BananaGithubserfer/velopath/app/velopath3_project/documents/velopath_materials/brochure/assets/velopath-device-photo.png

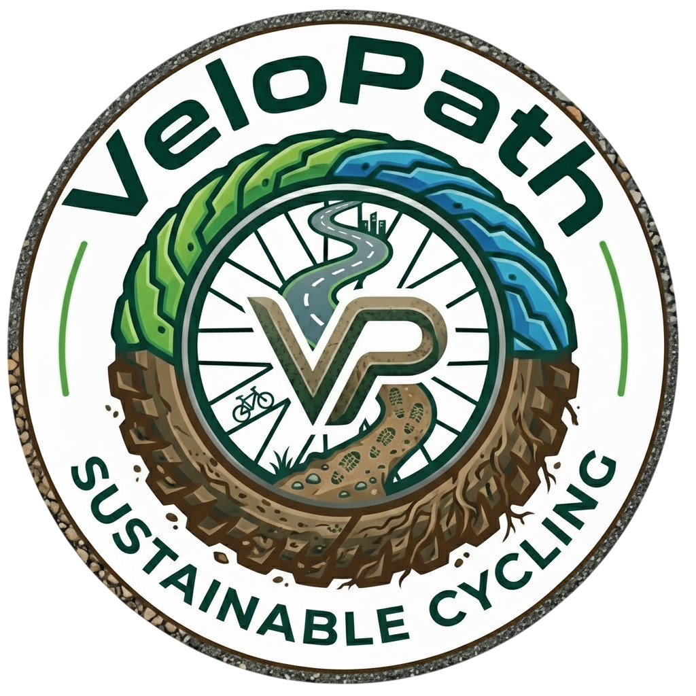
app/velopath3_project/documents/velopath_materials/brochure/assets/velopath-device-photo.png
