BananaGithubserfer/velopath/app/velopath3_project/artifacts/test-report-2026-04-02/02-dashboard-dark.png

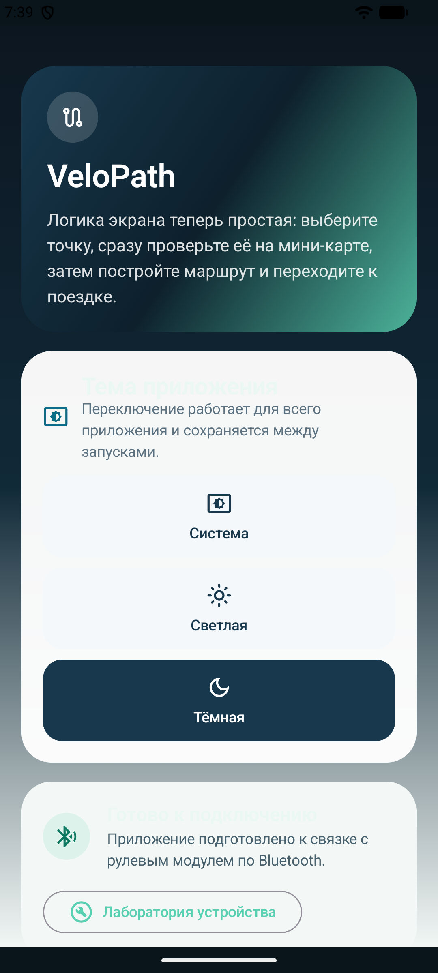
app/velopath3_project/artifacts/test-report-2026-04-02/02-dashboard-dark.png
