BananaGithubserfer/velopath/_migration/flash_import_report_2026-04-12.md

# Flash import report

Date: 2026-04-12
Source drive: D:\\
Destination: C:\\Users\\vladimir.DESKTOP-L4RFPI0\\Documents\\velopath\\documentation\\from_flash

Total files copied: 97
Total folders created: 5

## By extension
- .bak: 23
- .png: 19
- .m3d: 18
- .pdf: 8
- .docx: 5
- .stl: 5
- .a3d: 4
- .cdw: 3
- .kdw: 2
- .3mf_dir: 2
- .dxf: 2
- .3mf: 2
- .xcf: 1
- .deck: 1
- .frw: 1
- .gcode: 1

## Top-level copied groups
- gearbox
- velopath_0
- velopath_docs
- box_net_with_full_bw_logo_on_lid_FINAL.dxf
- VELOPATH (1).pdf
- VELOPATH.deck
- VELOPATH.pdf
- Тех.карта_шаблон.png
- Тех_карта_не_знаю_чего.png
