BananaGithubserfer/velopath/documentation/orders/rezonit_2026-08-21_from_scratch/drc_report.txt

** Drc report for velopath_rezonit_2026_08_21.kicad_pcb **
** Created on 2026-08-21T18:04:39 **
** Report includes: Errors, Warnings **

** Found 199 DRC violations **
[silk_over_copper]: Silkscreen clipped by solder mask
    Local override; warning
    @(29.0725 mm, 45.0300 mm): Сегмент от Q3 на F.Silkscreen
    @(29.4475 mm, 45.8000 mm): Конт. пл. 3 [GND] от Q3 на F.Cu
[silk_over_copper]: Silkscreen clipped by solder mask
    Local override; warning
    @(29.8225 mm, 45.0300 mm): Сегмент от Q3 на F.Silkscreen
    @(29.4475 mm, 45.8000 mm): Конт. пл. 3 [GND] от Q3 на F.Cu
[silk_over_copper]: Silkscreen clipped by solder mask
    Local override; warning
    @(29.8225 mm, 47.7300 mm): Сегмент от Q3 на F.Silkscreen
    @(29.4475 mm, 45.8000 mm): Конт. пл. 3 [GND] от Q3 на F.Cu
[silk_over_copper]: Silkscreen clipped by solder mask
    Local override; warning
    @(33.6325 mm, 45.0300 mm): Сегмент от Q3 на F.Silkscreen
    @(34.0075 mm, 45.8000 mm): Конт. пл. 1 [Net-(Q3-G)] от Q3 на F.Cu
[silk_over_copper]: Silkscreen clipped by solder mask
    Local override; warning
    @(34.3825 mm, 45.0300 mm): Сегмент от Q3 на F.Silkscreen
    @(34.0075 mm, 45.8000 mm): Конт. пл. 1 [Net-(Q3-G)] от Q3 на F.Cu
[silk_over_copper]: Silkscreen clipped by solder mask
    Local override; warning
    @(34.3825 mm, 48.1350 mm): Сегмент от Q3 на F.Silkscreen
    @(34.0075 mm, 45.8000 mm): Конт. пл. 1 [Net-(Q3-G)] от Q3 на F.Cu
[silk_over_copper]: Silkscreen clipped by solder mask
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
    Local override; warning
    @(27.3000 mm, 51.1000 mm): Сегмент от C7 на B.Silkscreen
    @(28.3675 mm, 50.8500 mm): Конт. пл. 1 [+3.3V] от C7 на B.Cu
[silk_over_copper]: Silkscreen clipped by solder mask
    Local override; warning
    @(27.3000 mm, 51.1000 mm): Сегмент от C7 на B.Silkscreen
    @(27.2325 mm, 50.8500 mm): Конт. пл. 2 [GND] от C7 на B.Cu
[silk_over_copper]: Silkscreen clipped by solder mask
    Local override; warning
    @(28.3000 mm, 50.6000 mm): Сегмент от C7 на B.Silkscreen
    @(28.3675 mm, 50.8500 mm): Конт. пл. 1 [+3.3V] от C7 на B.Cu
[silk_over_copper]: Silkscreen clipped by solder mask
    Local override; warning
    @(28.3000 mm, 50.6000 mm): Сегмент от C7 на B.Silkscreen
    @(27.2325 mm, 50.8500 mm): Конт. пл. 2 [GND] от C7 на B.Cu
[silk_over_copper]: Silkscreen clipped by solder mask
    Local override; warning
    @(28.3000 mm, 51.1000 mm): Сегмент от C7 на B.Silkscreen
    @(28.3675 mm, 50.8500 mm): Конт. пл. 1 [+3.3V] от C7 на B.Cu
[silk_over_copper]: Silkscreen clipped by solder mask
    Local override; warning
    @(29.6750 mm, 50.4200 mm): Сегмент от R1 на B.Silkscreen
    @(30.7975 mm, 50.1500 mm): Конт. пл. 1 [Net-(D1-K-)] от R1 на B.Cu
[silk_over_copper]: Silkscreen clipped by solder mask
    Local override; warning
    @(29.6750 mm, 50.4200 mm): Сегмент от R1 на B.Silkscreen
    @(29.6025 mm, 50.1500 mm): Конт. пл. 2 [GND] от R1 на B.Cu

** Found 0 unconnected pads **

** Found 0 Footprint errors **

** Ignored checks **
    - Footprint has no courtyard defined
    - Track endpoint not centered on via
    - Tuning profile track geometries
    - Footprint doesn't match symbol's footprint filters
    - PTH inside courtyard
    - NPTH inside courtyard
    - Footprint component type doesn't match footprint pads
    - Footprint doesn't match copy in library

** End of Report **
