BananaGithubserfer/velopath/INDEX.md

# VeloPath - project index

Last updated: 2026-08-10

Project root:
`C:\Users\vladimir.DESKTOP-L4RFPI0\Documents\velopath`

## 1) Main folders

- `app` - Android application, Gradle project, APK outputs.
- `firmware` - MCU firmware workspaces.
- `documentation` - reports, technical docs, mechanical docs, migration notes.
- `pcb` - KiCad schematic/PCB and production files.
- `advertising` - booklets, presentations, visual assets.
- `_migration` - migration/import logs.

## 2) Where to find things quickly

Android app:
- `C:\Users\vladimir.DESKTOP-L4RFPI0\Documents\velopath\app\velopath3_project`
- Release APK copies:
  `C:\Users\vladimir.DESKTOP-L4RFPI0\Documents\velopath\app\releases`

STM32 firmware:
- Primary tree:
  `C:\Users\vladimir.DESKTOP-L4RFPI0\Documents\velopath\firmware\firmware`
- Legacy/backup workspace:
  `C:\Users\vladimir.DESKTOP-L4RFPI0\Documents\velopath\firmware\stm32_legacy_workspace`

ESP (all ESP code + artifacts + temp build data in one place):
- `C:\Users\vladimir.DESKTOP-L4RFPI0\Documents\velopath\firmware\esp`
- Folder policy:
  `C:\Users\vladimir.DESKTOP-L4RFPI0\Documents\velopath\firmware\esp\README.md`

Reports and explanatory documents:
- `C:\Users\vladimir.DESKTOP-L4RFPI0\Documents\velopath\documentation\reports\project_docs`
- Explanatory note (Shanenkov):
  `C:\Users\vladimir.DESKTOP-L4RFPI0\Documents\velopath\documentation\reports\explanatory_note`
- Reviews:
  `C:\Users\vladimir.DESKTOP-L4RFPI0\Documents\velopath\documentation\reports\reviews`
- Hardware audit (schematic + PCB, 2026-08-10):
  `C:\Users\vladimir.DESKTOP-L4RFPI0\Documents\velopath\documentation\reports\hardware_audit_2026-08-10`

Engineering/process docs:
- `C:\Users\vladimir.DESKTOP-L4RFPI0\Documents\velopath\documentation\engineering\process_docs`
- Engineering visuals:
  `C:\Users\vladimir.DESKTOP-L4RFPI0\Documents\velopath\documentation\engineering\visuals`

Mechanical CAD docs:
- Main assembly models:
  `C:\Users\vladimir.DESKTOP-L4RFPI0\Documents\velopath\documentation\mechanical_cad\main_assembly_models`
- Gearbox:
  `C:\Users\vladimir.DESKTOP-L4RFPI0\Documents\velopath\documentation\mechanical_cad\gearbox`

PCB:
- Main PCB folder:
  `C:\Users\vladimir.DESKTOP-L4RFPI0\Documents\velopath\pcb`

Advertising:
- Presentations:
  `C:\Users\vladimir.DESKTOP-L4RFPI0\Documents\velopath\advertising\presentations`
- Booklets:
  `C:\Users\vladimir.DESKTOP-L4RFPI0\Documents\velopath\advertising\brochures`
- Assets:
  `C:\Users\vladimir.DESKTOP-L4RFPI0\Documents\velopath\advertising\assets`

## 3) Navigation docs

Project onboarding guide:
- `C:\Users\vladimir.DESKTOP-L4RFPI0\Documents\velopath\START_HERE.md`

Software stack (non-ESP):
- `C:\Users\vladimir.DESKTOP-L4RFPI0\Documents\velopath\documentation\software_stack_non_esp.md`

Materials origin map:
- `C:\Users\vladimir.DESKTOP-L4RFPI0\Documents\velopath\documentation\materials_origin_and_import_map.md`

Migration reports:
- `C:\Users\vladimir.DESKTOP-L4RFPI0\Documents\velopath\_migration\migration_report_2026-04-12.md`
- `C:\Users\vladimir.DESKTOP-L4RFPI0\Documents\velopath\_migration\flash_import_report_2026-04-12.md`
