BananaGithubserfer/velopath/START_HERE.md

# START HERE - quick onboarding

If you are new to this project, use this order:

1. Open project map:
   `C:\Users\vladimir.DESKTOP-L4RFPI0\Documents\velopath\INDEX.md`
2. Read software overview (non-ESP):
   `C:\Users\vladimir.DESKTOP-L4RFPI0\Documents\velopath\documentation\software_stack_non_esp.md`
3. Read materials/source map:
   `C:\Users\vladimir.DESKTOP-L4RFPI0\Documents\velopath\documentation\materials_origin_and_import_map.md`

## Fast path by task

Mobile app:
- `C:\Users\vladimir.DESKTOP-L4RFPI0\Documents\velopath\app\velopath3_project`

STM32 firmware:
- `C:\Users\vladimir.DESKTOP-L4RFPI0\Documents\velopath\firmware\firmware`

ESP work:
- `C:\Users\vladimir.DESKTOP-L4RFPI0\Documents\velopath\firmware\esp`

PCB/electronics:
- `C:\Users\vladimir.DESKTOP-L4RFPI0\Documents\velopath\pcb`

Reports and explanatory docs:
- `C:\Users\vladimir.DESKTOP-L4RFPI0\Documents\velopath\documentation\reports`

Engineering/process docs:
- `C:\Users\vladimir.DESKTOP-L4RFPI0\Documents\velopath\documentation\engineering`

Mechanical CAD docs:
- `C:\Users\vladimir.DESKTOP-L4RFPI0\Documents\velopath\documentation\mechanical_cad`
