BananaGithubserfer/velopath/documentation/reports/Криминалистические очки с ультрафиолетовой подсветкой_VeloPath_готово.docx

# VeloPath — система тактильной навигации для велосипеда

ВСОШ 2026-2027

Файл утверждён: 01.10.2026

Список олимпиад для которых предназначен проект: ВсОШ «Труд (технология)», направление ТТиТТ

____________________________________________________________________

ФИО Исполнителя №1: Штаненков Владимир Владимирович

Класс (Номер, буква): ______________

ФИО Классного руководителя исполнителя №1: ___________________________

ФИО Исполнителя №2: не предусмотрен

Класс (Номер, буква): ______________

ФИО Классного руководителя исполнителя №2:___________________________

ФИО Исполнителя №3: не предусмотрен

Класс (Номер, буква): ______________

ФИО Классного руководителя исполнителя №3:___________________________

ФИО Научного руководителя №1: ______________________________________

ФИО Научного руководителя №2: ______________________________________

ФИО Научного руководителя №3: ______________________________________

Подпись исполнителя №1: ____________________

Подпись исполнителя №2: ____________________

Подпись исполнителя №3: ____________________

Подпись научного руководителя №1: ____________________

Подпись научного руководителя №2: ____________________

Подпись научного руководителя №3: ____________________

Оглавление

1. Общая часть 6

1.1 Цель 6

1.2 Проблема, решаемая проектом 6

1.3 Целевая аудитория проекта 6

1.4 Преимущества проекта перед аналогами 7

1.5 Уровень готовности проекта по этапам олимпиады 8

1.5.1 Муниципальный этап 8

1.5.2 Региональный этап 8

1.5.3 Заключительный этап 8

2. Предмет разработки (тип устройства) 9

2.1 Комплектация готового изделия(-ий) 9

2.2 Список функций предмета разработки 9

2.3 Список задач до каждого этапа 10

2.3.1 Муниципальный этап 10

2.3.2 Региональный этап 10

2.3.3 Заключительный этап 10

2.4 Список основних электронных компоннентов 10

2.5 Список сложных для создания/закупки компонентов 11

2.6 Список собственных печатных плат/готовых электронных модулей 12

2.7 Перспективы в случае оставшегося времени на доработку 13

3. Зарядная станция (при наличии) 15

3.1 Список функций зарядной станции 15

3.2 Список задач до каждого этапа 15

3.2.1 Муниципальный этап 16

3.2.2 Региональный этап 16

3.2.3 Заключительный этап 16

3.3 Список основних электронных компоннентов 16

3.4 Список сложных для создания/закупки компонентов 17

3.5 Список собственных печатных плат/готовых электронных модулей 18

3.6 Перспективы в случае оставшегося времени на доработку 19

4. Программная часть проекта (при наличии) 20

4.1 Список программных функций предмета разработки 20

4.2 Список программных функций зарядной станции (при наличии) 20

4.3 Список функций приложения/сайта/бота (при наличии) 21

4.4 Список задач до каждого этапа 22

4.4.1 Муниципальный этап 22

4.4.2 Региональный этап 23

4.4.3 Заключительный этап 23

4.5 Перспективы в случае оставшегося времени на доработку 23

5. Дополнительные материалы 24

5.1 Название проекта 24

5.2 Патентное исследование 24

5.3 Опросы целевой аудитории 25

5.4 Логотип 26

5.5 Продвижение и ведение социальных сетей проекта 27

5.6 Буклеты/визитки 28

5.7 Упаковка 29

5.8 Презентация и сценарий защиты проекта 30

5.9 Апробация проекта 31

5.10 Дополнительные печатные и информационные материалы 32

1. Общая часть

## 1.1 Цель

Цель проекта — разработать и испытать комплекс VeloPath: мобильное приложение и встраиваемый в концы велосипедного руля модуль, который передаёт тактильные указания о направлении движения и позволяет пользоваться навигацией без постоянного взгляда на экран.

## 1.2 Проблема, решаемая проектом

Во время движения велосипедисту приходится отвлекаться от дороги, чтобы читать карту или указания на экране смартфона. Это снижает внимание к дорожной обстановке, особенно при ярком солнце, вибрации, дожде и движении по незнакомому маршруту. VeloPath передаёт предупреждение о повороте, сигнал самого поворота и завершение маршрута вибрацией левой и правой частей руля. Направление считывается руками, поэтому экран нужен только для построения маршрута и контроля приложения.

## 1.3 Целевая аудитория проекта

Основные пользователи — велосипедисты-любители, участники велоспорта и курьеры, которым требуется навигация во время движения. Дополнительная аудитория — пользователи, которым неудобно постоянно смотреть на экран из-за яркого освещения, погодных условий или требований безопасности. Устройство рассчитано на велосипеды с рулём, в торцы которого устанавливаются два модуля диаметром примерно 17–20 мм.

## 1.4 Преимущества проекта перед аналогами

Прямые аналоги — велокомпьютеры и навигаторы с экраном; косвенные — смартфон на держателе и голосовые подсказки. VeloPath сообщает направление тактильно и не закрывает обзор картой или телефоном. Два симметричных модуля дают однозначное различение левого и правого поворота, а компас позволяет уточнять отклонение от курса. Конструкция размещается внутри руля, защищает электронику и не требует отдельного экрана на руле. Прототип объединяет собственную плату, прошивку и мобильное приложение в одной системе.

## 1.5 Уровень готовности проекта по этапам олимпиады

Проект готовится поэтапно: на муниципальном этапе демонстрируется работающий макет и базовый сценарий навигации; на региональном — собранный прототип с корпусом, платой, прошивкой и приложением; на заключительном — полностью собранное изделие, комплект документации, результаты испытаний на нескольких типах велосипедов и демонстрация маршрута.

### 1.5.1 Муниципальный этап

Готовы постановка задачи и архитектура системы, CAD-модель корпуса, схема основных узлов, базовая версия мобильного приложения и прошивки, демонстрация передачи команд по Bluetooth и работы вибромоторов.

### 1.5.2 Региональный этап

Собраны печатная плата и корпус, установлены аккумуляторы, вибромоторы, крепления и зарядный разъём; реализованы построение маршрута, получение GPS, расчёт направления, передача команд по Bluetooth и сигналы поворота; выполнена первичная проверка на велосипеде.

### 1.5.3 Заключительный этап

Представляется рабочий прототип VeloPath в корпусе с двумя вибрационными модулями, управляющей платой на STM32F103RGT6, аккумуляторами LiFePO4, мобильным приложением Android, руководством пользователя, схемами, чертежами, спецификацией и протоколом апробации на разных велосипедах.

## 2.1 Комплектация готового изделия(-ий)

1) левый и правый модули корпуса; 2) управляющая плата; 3) два вибромотора с регуляторами; 4) два аккумулятора LiFePO4 14500; 5) крепления и крепёж; 6) соединительная проводка и разъём XT30; 7) установленная прошивка; 8) мобильное приложение VeloPath для Android; 9) инструкция по установке, зарядке и первому запуску; 10) транспортировочная упаковка.

## 2.2 Список функций предмета разработки

• передача тактильного сигнала левого и правого направления; • предупреждение о повороте примерно за 10 секунд; • сигнал выполнения поворота с интенсивностью, зависящей от отклонения курса; • сигнал завершения маршрута одновременной вибрацией; • получение команд от приложения по Bluetooth UART; • определение ориентации по магнитометру LIS3MDL; • автономная работа от двух LiFePO4 аккумуляторов; • зарядка через установленную схему TP5000 и разъём XT30; • размещение в торцах велосипедного руля с механической фиксацией.

## 2.3 Список задач до каждого этапа

Задачи включают разработку конструкции, электроники, прошивки, мобильного приложения, изготовление деталей, сборку и испытания. Состав по этапам указан ниже.

### 2.3.1 Муниципальный этап

Уточнить требования и сценарии сигналов; завершить эскизную компоновку; подготовить схему и перечень компонентов; реализовать базовую Bluetooth-связь и управление вибрацией; подготовить демонстрационный макет.

### 2.3.2 Региональный этап

Изготовить и проверить печатную плату; изготовить корпус и крепления; установить аккумуляторы и моторы; реализовать построение маршрута, GPS и расчёт направления; выполнить первичную апробацию и исправить выявленные ошибки.

### 2.3.3 Заключительный этап

Завершить сборку и маркировку изделия; проверить зарядку, связь и все сигналы; провести испытания в городе, на просёлочной дороге и в лесу; оформить чертежи, спецификацию, инструкцию, презентацию и подтверждающие материалы.

## 2.4 Список основних электронных компоннентов

STM32F103RGT6 — микроконтроллер прошивки и управления; WH-BLE106 — Bluetooth UART-связь с телефоном; LIS3MDL — магнитометр для определения курса; TP5000 и BMS — зарядка и защита LiFePO4; два LiFePO4 14500 — автономное питание; два бесколлекторных мотора Mini 1103 и два регулятора SPEDIX ES20 Lite 20A — создание тактильной вибрации; LD39050PU33 и пассивные компоненты — стабилизация и согласование питания.

## 2.5 Список сложных для создания/закупки компонентов

Печатная плата требует заказа на производстве из-за малых посадочных мест магнитометра и плотной трассировки. Эксцентрики вибромоторов изготавливаются фрезерованием алюминия и запрессовкой на вал. Корпус, крепления и держатели моторов печатаются на 3D-принтере по разработанным моделям. Эти элементы необходимы для размещения узлов в ограниченном диаметре руля и обеспечения надёжной фиксации.

## 2.6 Список собственных печатных плат/готовых электронных модулей

Собственная управляющая печатная плата объединяет STM32F103RGT6, Bluetooth, магнитометр, питание, зарядку и выводы моторов. Готовые модули: WH-BLE106, регуляторы SPEDIX ES20 Lite и элементы защиты аккумуляторов. Плата спроектирована в KiCad и изготовлена на производстве Резонит.

## 2.7 Список необходимого технологического оборудования

ПК с KiCad, Android Studio и STM32CubeIDE; паяльная станция; мультиметр; лабораторный блок питания; сварка аккумуляторов; 3D-принтер Creality Ender 3 V3 SE; фрезерный и сверлильный станки для эксцентриков; ручной слесарный инструмент; оборудование для проверки Bluetooth и навигации.

## 2.8 Перспективы в случае оставшегося времени на доработку

Уменьшить габариты платы и корпуса; повысить влагозащиту; добавить диагностику заряда и состояния связи; разработать сменные крепления для рулей разных диаметров; улучшить алгоритм фильтрации компаса; подготовить серийную технологию изготовления и расширить приложение статистикой поездки.

3. Зарядная станция (при наличии)

Отдельная зарядная станция проектом не предусмотрена. Зарядка аккумуляторов выполнена внутри правого модуля через разъём XT30 и контроллер TP5000.

## 3.1 Список функций зарядной станции

Не применяется: отдельной станции нет. Изделие принимает заряд через встроенный разъём и контроллер.

## 3.2 Список задач до каждого этапа

Не применяется: отдельная зарядная станция не разрабатывается.

### 3.2.1 Муниципальный этап

Не применяется.

### 3.2.2 Региональный этап

Не применяется.

### 3.2.3 Заключительный этап

Не применяется.

## 3.3 Список основних электронных компоннентов

Не применяется: зарядный узел находится на управляющей плате изделия и использует TP5000, BMS и разъём XT30.

## 3.4 Список сложных для создания/закупки компонентов

Не применяется.

## 3.5 Список собственных печатных плат/готовых электронных модулей

Зарядная часть выполнена на собственной управляющей плате; отдельная плата станции отсутствует.

## 3.6 Список необходимого технологического оборудования

Оборудование отдельной станции не требуется; для проверки зарядки используются мультиметр и лабораторный блок питания.

## 3.7 Перспективы в случае оставшегося времени на доработку

Разработать внешний зарядный док с контактами pogo-pin, если испытания покажут необходимость ускоренной установки изделия на зарядку.

## 4.1 Список программных функций предмета разработки

Прошивка контроллера и логика устройства обеспечивают приём команд по UART, управление левым и правым каналами вибрации, чтение магнитометра, формирование сигналов предупреждения, поворота и завершения маршрута, контроль режимов питания и диагностику связи.

## 4.2 Список программных функций зарядной станции (при наличии)

Не применяется: отдельной зарядной станции нет.

## 4.3 Список функций приложения/сайта/бота (при наличии)

Android-приложение создаёт маршрут, отображает карту, получает координаты GPS, рассчитывает направление и ключевые события, передаёт команды по Bluetooth, показывает состояние подключения и предоставляет настройки пользователя. Используются Kotlin, Jetpack Compose, Android Navigation Compose, Yandex MapKit и Google Play Services Location.

## 4.4 Список задач до каждого этапа

Разработка прошивки и Android-приложения ведётся совместно с изготовлением аппаратной части.

### 4.4.1 Муниципальный этап

Собрать прототип обмена данными; реализовать команды вибрации; подготовить экран построения маршрута и подключение Bluetooth; проверить базовый сценарий на стенде.

### 4.4.2 Региональный этап

Реализовать GPS, расчёт направления, события маршрута и работу с магнитометром; связать приложение с реальной платой; добавить диагностику и обработку ошибок связи.

### 4.4.3 Заключительный этап

Стабилизировать прошивку и приложение; провести полевые испытания; подготовить APK, инструкцию, демонстрационный сценарий и резервный режим показа функций без внешней сети.

## 4.5 Перспективы в случае оставшегося времени на доработку

Добавить журнал поездки, настройку интенсивности сигналов, обновление прошивки через приложение, профили для разных типов велосипедов и более устойчивое к помехам определение курса.

## 5.1 Название проекта

VeloPath («ВелоПуть») — название отражает назначение системы: построение велосипедного маршрута и передача пути пользователю через устройство в руле. Название используется на корпусе, в приложении, документации и презентации.

## 5.2 Патентное исследование

Провести поиск по открытым базам Роспатента и международным базам по ключевым словам: велосипедная навигация, тактильная навигация, вибрационные указатели поворота, устройство в руле. Отдельно сравнить решения с экраном, голосовыми подсказками и вибрационными сигналами. Результаты оформить таблицей аналогов и приложить к защите; при обнаружении близкого патента скорректировать формулировки конструкции.

## 5.3 Опросы целевой аудитории

Провести опрос не менее 10 велосипедистов и курьеров. Проверить понятность левого и правого сигналов, полезность предупреждения за 10 секунд, удобство расположения в руле и готовность использовать приложение. Зафиксировать ответы анкетами, свести результаты в таблицу и использовать их для настройки сигналов.

## 5.4 Логотип

Использовать существующий логотип VeloPath в едином варианте: название VeloPath и графический мотив маршрута. Размещать логотип на корпусе, плате, упаковке, буклете, презентации и экране приложения.

## 5.5 Продвижение и ведение социальных сетей проекта

Вести дневник разработки и демонстрации прототипа в VK и Telegram с дублированием ключевых публикаций в VK. Публиковать фотографии CAD-моделей, платы, сборки, испытаний и короткие ролики с пояснением сигналов. Подготовить контент-план по этапам изготовления и апробации.

## 5.6 Буклеты/визитки

Подготовить двусторонний буклет формата А5: проблема, схема работы, комплект, характеристики, фотографии и QR-код на материалы проекта. Для общения с экспертами дополнительно использовать визитку с названием VeloPath и контактами автора.

## 5.7 Упаковка

Использовать компактную картонную коробку с ложементом из вспененного материала. Внутри отдельно зафиксировать левый и правый модули, кабель, крепёж и инструкцию. На крышке разместить логотип VeloPath, на вкладыше — схему установки и предупреждения по зарядке.

## 5.8 Презентация и сценарий защиты проекта

Защита включает презентацию, демонстрационный прототип, схему системы, фотографию платы и корпуса, сравнительную таблицу аналогов и короткую демонстрацию маршрута. Порядок: проблема безопасности, идея тактильной навигации, конструкция и электроника, приложение, испытания, результаты и перспективы.

## 5.9 Апробация проекта

Испытать устройство на спортивном кросс-кантри, фитнес-кросс-кантри, гравийном и шоссейном велосипедах. Проверить фиксацию, различимость сигналов, работу Bluetooth, точность указаний и автономность. Участники проходят знакомый и незнакомый маршрут; результаты фиксируются видео, фотографиями, анкетами и протоколом испытаний.

## 5.10 Дополнительные печатные и информационные материалы

Подготовить руководство по установке и первому запуску, памятку по сигналам, правила зарядки LiFePO4, технический паспорт с составом изделия, спецификацию, электрическую схему, чертежи корпуса и протокол апробации. К заключительному этапу материалы должны быть доступны в печатном и электронном виде.
