BananaGithubserfer/velopath/documentation/reports/reviews/рецензия_от_ядра.pdf

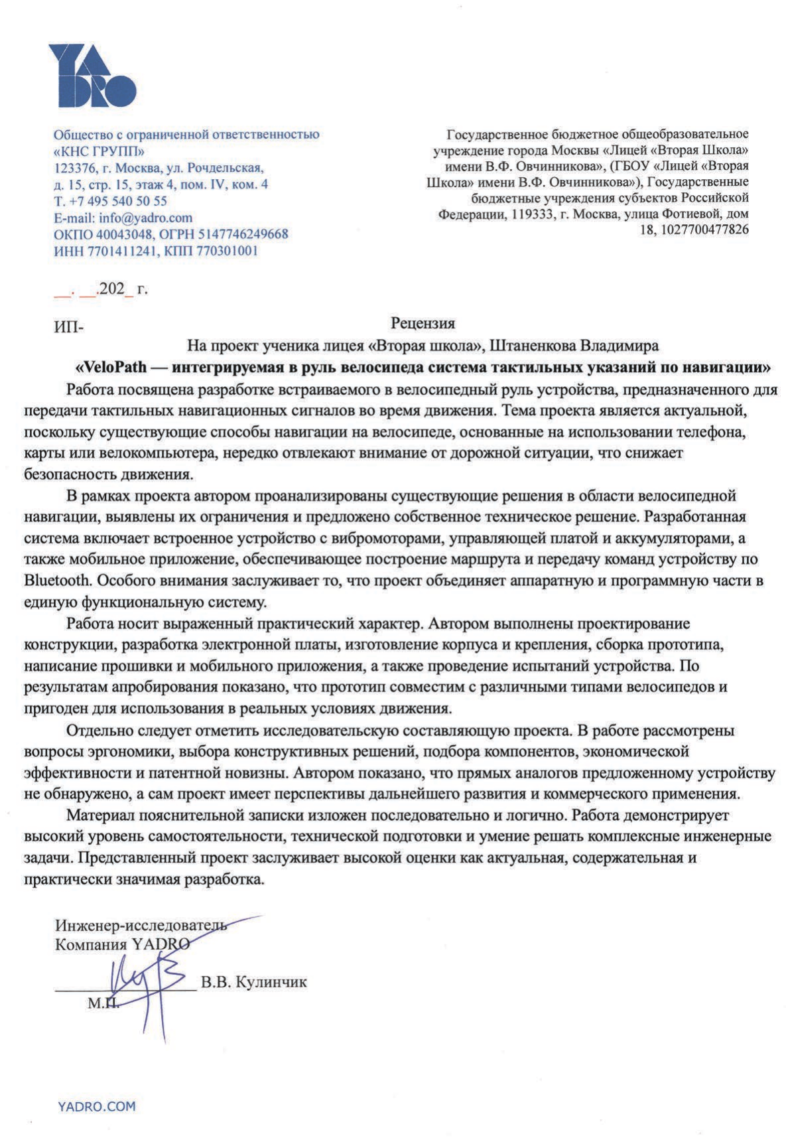
[picture p44: page 1]
