BananaGithubserfer/velopath/documentation/engineering/process_docs/Тех.карта_корпус.pdf

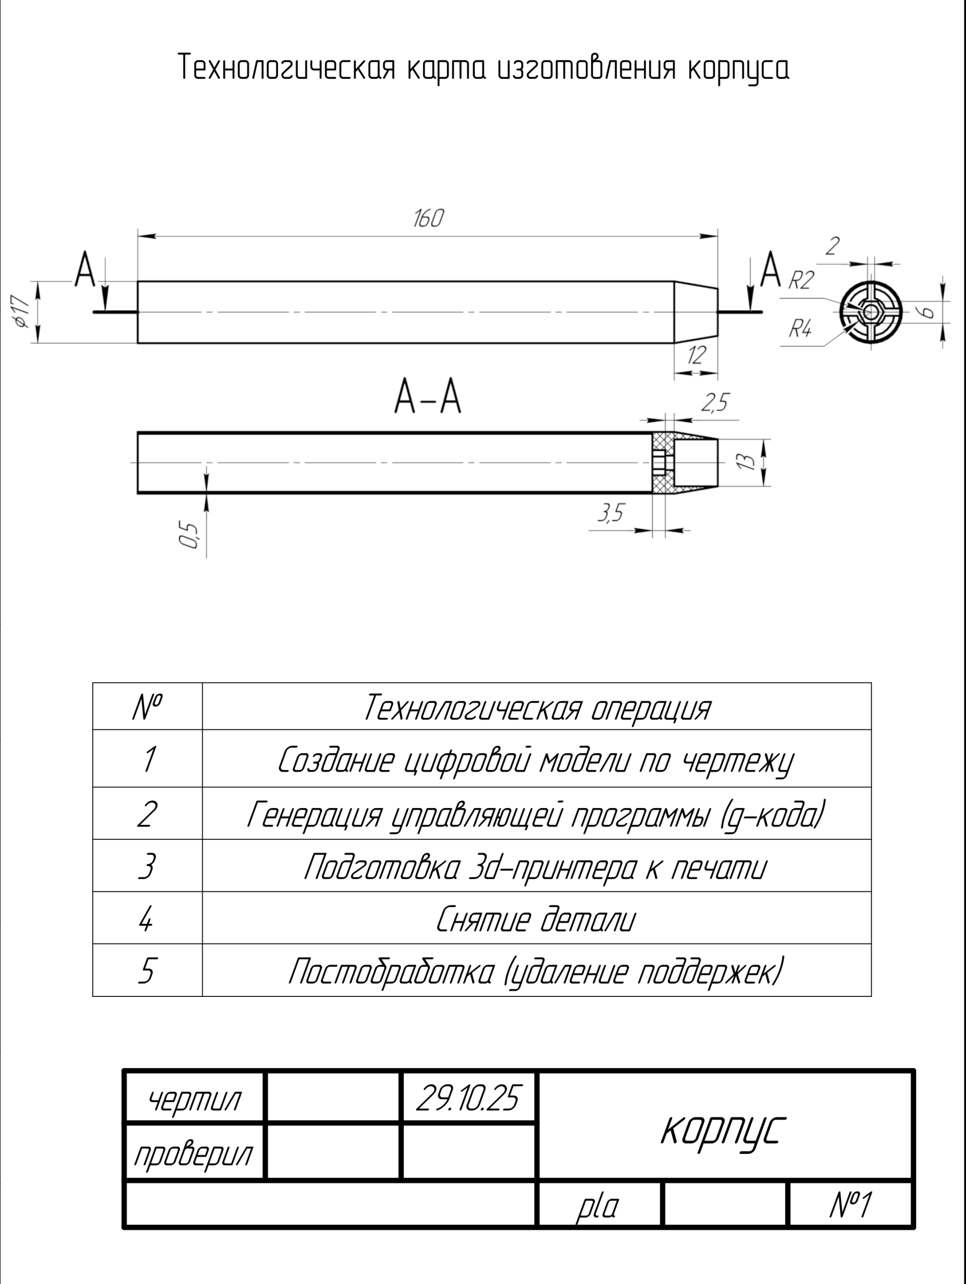
[picture p45: page 1]
