BananaGithubserfer/velopath/advertising/assets/lid_black_preview.png

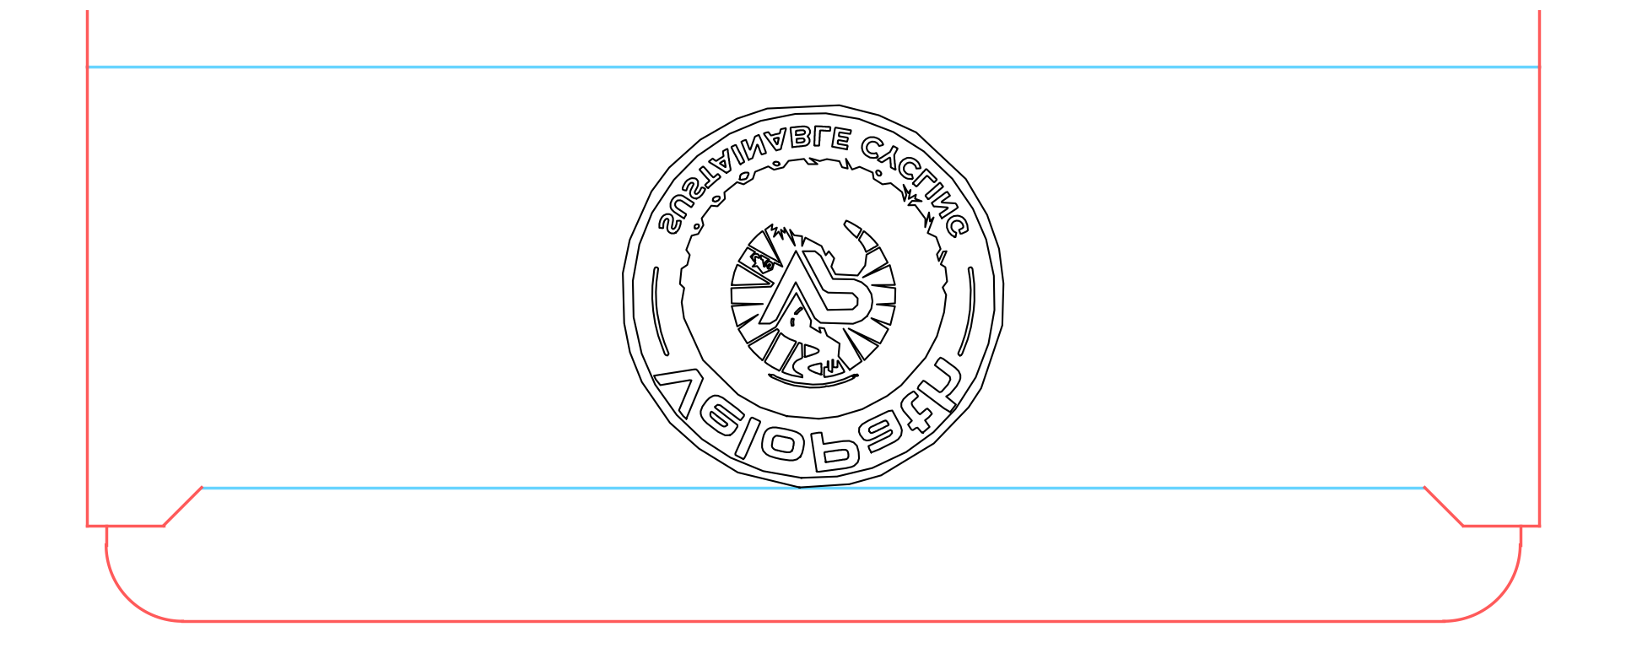
advertising/assets/lid_black_preview.png
