BananaGithubserfer/velopath/app/velopath3_project/documents/velopath_materials/app_reports/route-current.png

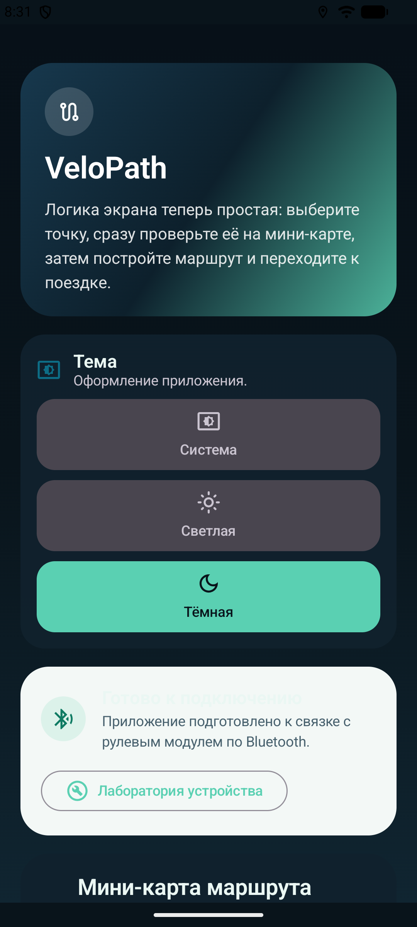
app/velopath3_project/documents/velopath_materials/app_reports/route-current.png
