BananaGithubserfer/velopath/documentation/_artifacts/duplicates/Тех.карта_корпус__20260412_233927406__20260412_234039031.png

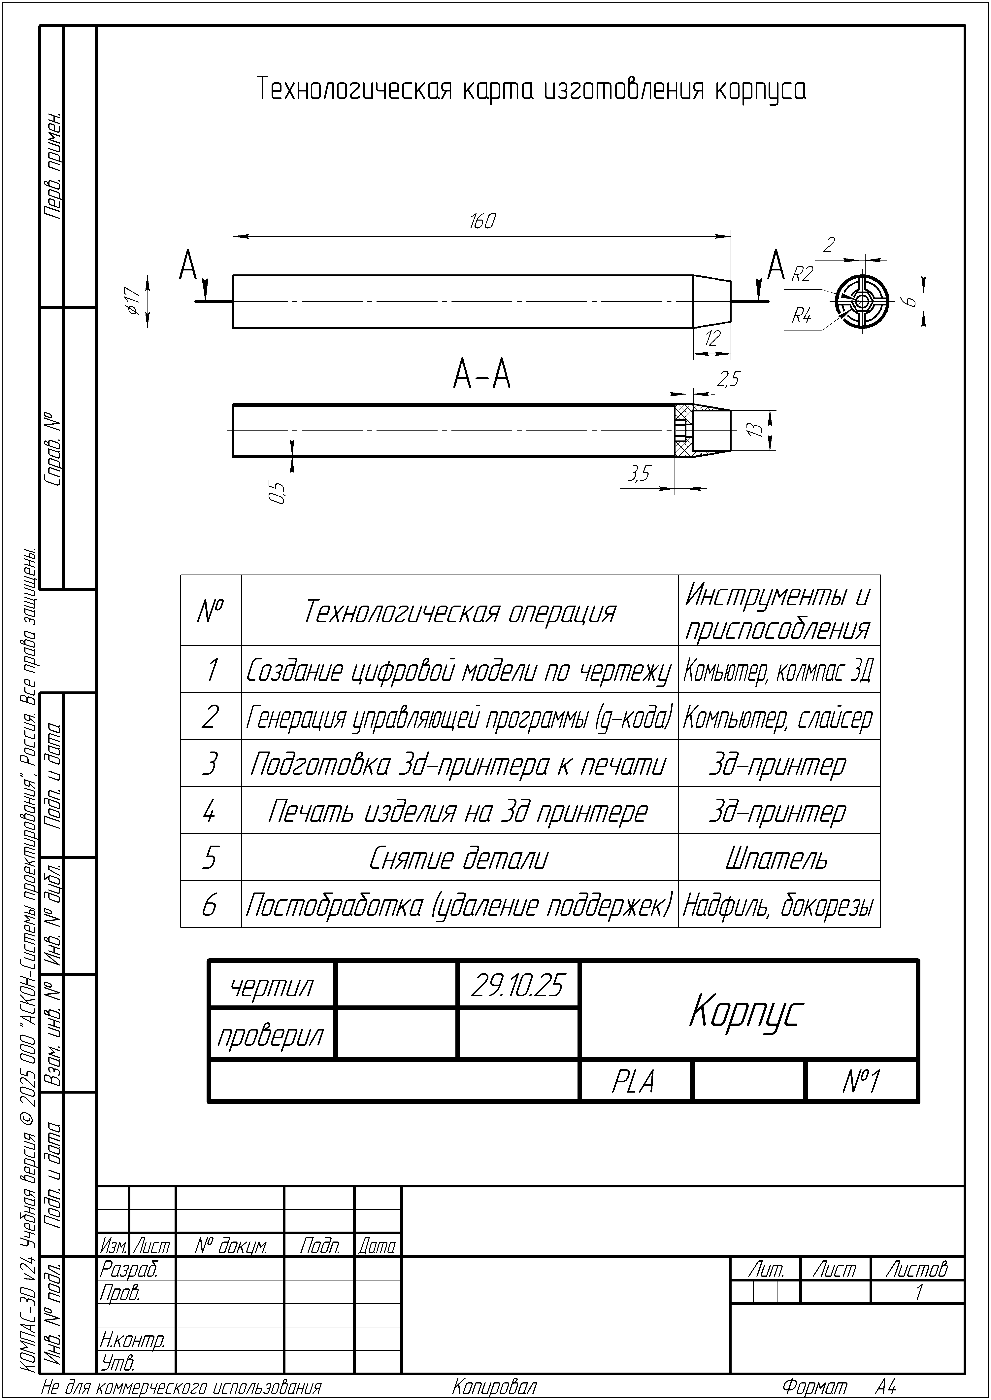
documentation/_artifacts/duplicates/Тех.карта_корпус__20260412_233927406__20260412_234039031.png
