BananaGithubserfer/velopath/documentation/engineering/visuals/1 - корпус.png

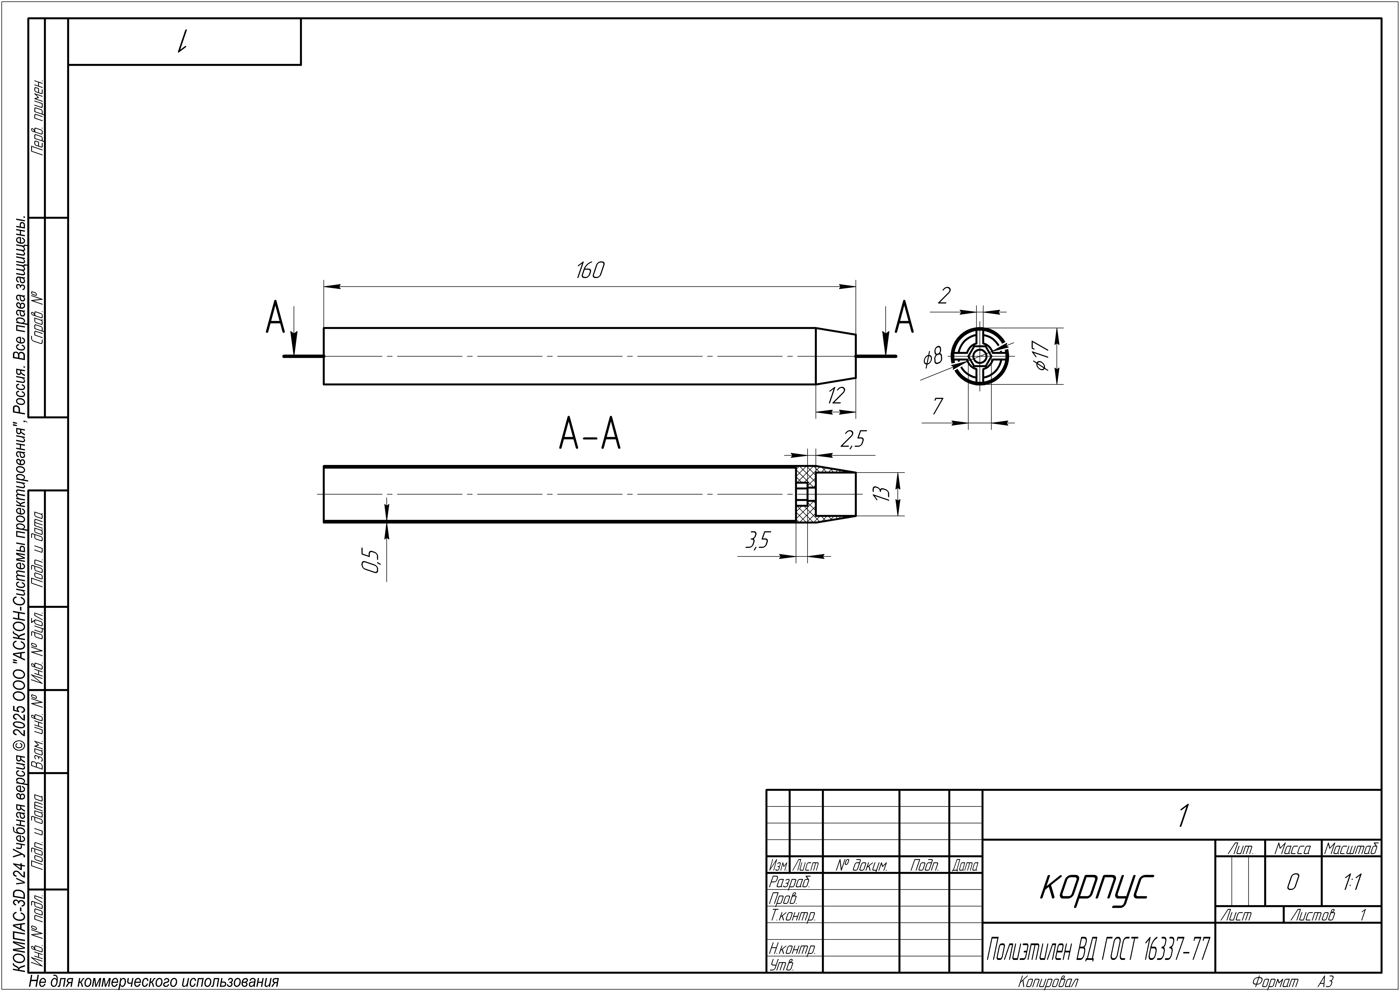
documentation/engineering/visuals/1 - корпус.png
