BananaGithubserfer/velopath/documentation/engineering/visuals/Тех.карта_корпус.png

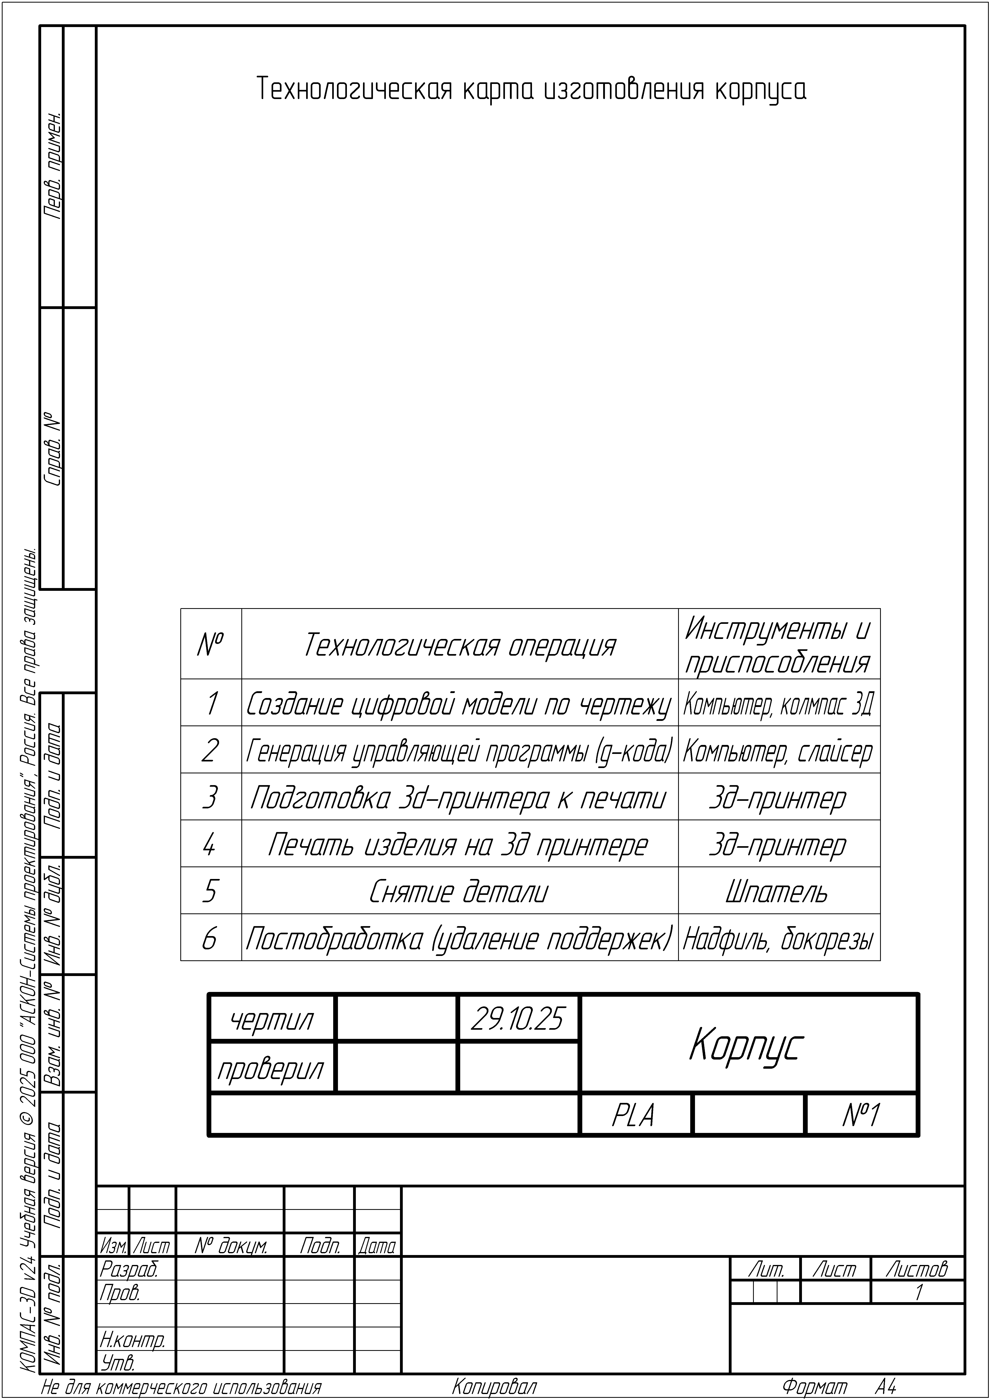
documentation/engineering/visuals/Тех.карта_корпус.png
