BananaGithubserfer/velopath/documentation/engineering/visuals/Тех.карта_шаблон.png

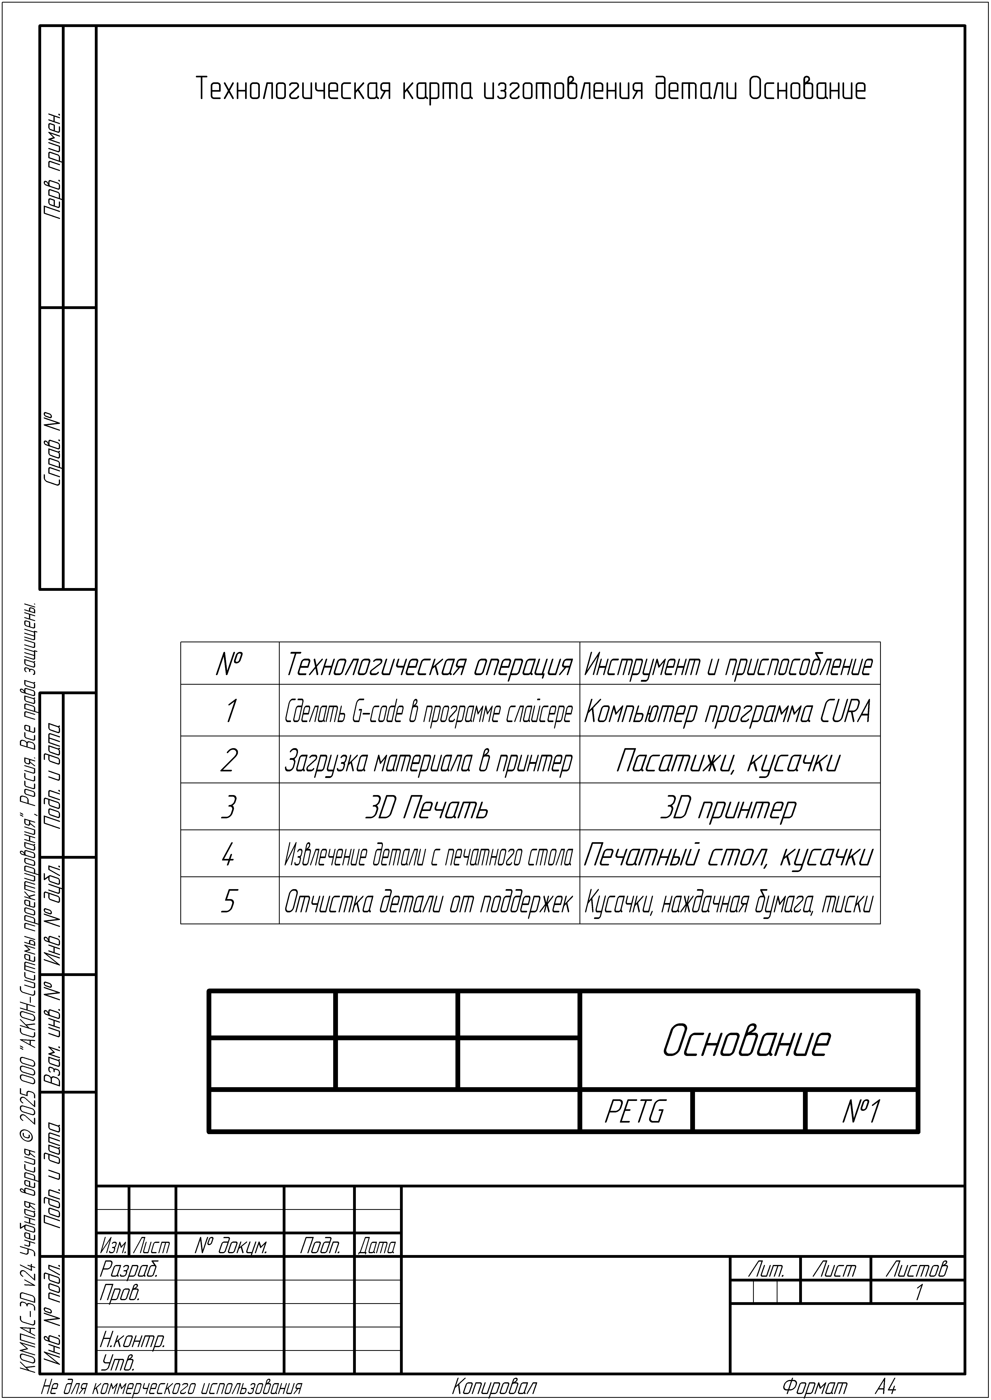
documentation/engineering/visuals/Тех.карта_шаблон.png
