BananaGithubserfer/velopath/documentation/mechanical_cad/.зарядка.3mf/зарядка_plate_1.png

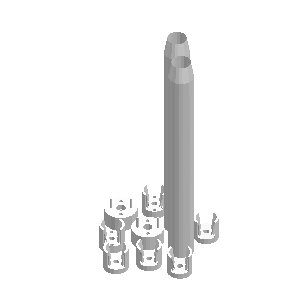
documentation/mechanical_cad/.зарядка.3mf/зарядка_plate_1.png
