BananaGithubserfer/velopath/documentation/mechanical_cad/.сборка.3mf/сборка_thumbnail.png

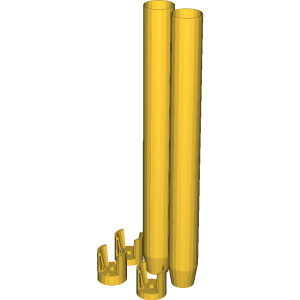
documentation/mechanical_cad/.сборка.3mf/сборка_thumbnail.png
