BananaGithubserfer/velopath/app/velopath3_project/documents/velopath_materials/README.md

# VeloPath Materials

This folder contains the curated non-code materials for VeloPath.

Contents:

- `brochure/`
  - final Figma-importable brochure SVGs
  - brochure assets
  - real app screenshots used for brochure/layout work
- `app_reports/`
  - selected app capture files
  - latest visual report artifacts
- `firmware_docs/`
  - handlebar firmware overview
  - WH-BLE106 notes and report

Removed as obsolete from the project root and brochure workspace:

- temporary emulator screenshots
- intermediate UI XML dumps
- old non-Figma brochure SVGs
- duplicate artifact screenshots from the project root
