BananaGithubserfer/velopath/documentation/materials_origin_and_import_map.md

# Materials origin and placement map

Last updated: 2026-04-12

This file explains where materials came from and where they are now located.

## 1) Source locations used during import

- Local machine:
  `C:\Users\vladimir.DESKTOP-L4RFPI0\Documents`
- USB flash drive:
  `D:\`
  (import was copy-only; source files on flash were not deleted)
- Existing project workspace:
  `C:\Users\vladimir.DESKTOP-L4RFPI0\AndroidStudioProjects\velopath3`

## 2) Final mapping (human-readable structure)

Application:
- Source project:
  `C:\Users\vladimir.DESKTOP-L4RFPI0\Documents\velopath\app\velopath3_project`
- APK copies:
  `C:\Users\vladimir.DESKTOP-L4RFPI0\Documents\velopath\app\releases`

Firmware:
- STM32:
  `C:\Users\vladimir.DESKTOP-L4RFPI0\Documents\velopath\firmware\firmware`
  `C:\Users\vladimir.DESKTOP-L4RFPI0\Documents\velopath\firmware\stm32_legacy_workspace`
- ESP (all ESP-related data consolidated):
  `C:\Users\vladimir.DESKTOP-L4RFPI0\Documents\velopath\firmware\esp`

Documentation:
- Reports/text docs:
  `C:\Users\vladimir.DESKTOP-L4RFPI0\Documents\velopath\documentation\reports\project_docs`
- Explanatory note:
  `C:\Users\vladimir.DESKTOP-L4RFPI0\Documents\velopath\documentation\reports\explanatory_note`
- Reviews:
  `C:\Users\vladimir.DESKTOP-L4RFPI0\Documents\velopath\documentation\reports\reviews`
- Engineering/process docs:
  `C:\Users\vladimir.DESKTOP-L4RFPI0\Documents\velopath\documentation\engineering\process_docs`
- Engineering visuals:
  `C:\Users\vladimir.DESKTOP-L4RFPI0\Documents\velopath\documentation\engineering\visuals`
- Mechanical CAD docs:
  `C:\Users\vladimir.DESKTOP-L4RFPI0\Documents\velopath\documentation\mechanical_cad\main_assembly_models`
  `C:\Users\vladimir.DESKTOP-L4RFPI0\Documents\velopath\documentation\mechanical_cad\gearbox`

PCB:
- Main electrical/PCB files:
  `C:\Users\vladimir.DESKTOP-L4RFPI0\Documents\velopath\pcb`

Advertising:
- Presentations:
  `C:\Users\vladimir.DESKTOP-L4RFPI0\Documents\velopath\advertising\presentations`
- Booklets:
  `C:\Users\vladimir.DESKTOP-L4RFPI0\Documents\velopath\advertising\brochures`
- Assets:
  `C:\Users\vladimir.DESKTOP-L4RFPI0\Documents\velopath\advertising\assets`

## 3) Service/technical leftovers

Temporary lock files and duplicate-collision files are isolated to:
- `C:\Users\vladimir.DESKTOP-L4RFPI0\Documents\velopath\documentation\_artifacts`

This keeps main folders clean and readable for new contributors.
