BananaGithubserfer/velopath/outputs/01a176eb-3d44-7fe1-ba5f-1e65135a0bb9/missing-components.xlsx

BMS
Обозначение на плате | Блок | Название и номинал | Посадочное место | Количество | Срок доставки | Ссылка | Стоимость за шт
Q1 | BMS | BMS, марка не указана | PCM_Package_TO_SOT_SMD_AKL:TSOT-23-6 | 1
Q2 | BMS | Транзистор NPN, номинал не указан | Package_TO_SOT_SMD:TO-252-2 | 1 |  | virtustec
Q3 | BMS | Транзистор NPN, номинал не указан | Package_TO_SOT_SMD:TO-252-2 | 1 |  | virtustec
C18 | BMS | Конденсатор 10 мкФ | PCM_Capacitor_SMD_AKL:C_0402_1005Metric_Pad0.74x0.62mm_HandSolder | 1 |  | virtustec
R9 | BMS | Резистор, номинал не указан | Resistor_SMD:R_0603_1608Metric_Pad0.98x0.95mm_HandSolder | 1 |  | virtustec
Контроллер зарядки и прочие компоненты
Обозначение на плате | Блок | Название и номинал | Посадочное место | Количество | Срок доставки | Ссылка
R13 | Контроллер зарядки | Резистор 50 кОм | PCM_4ms_Resistor:R_0402 | 1 |  | не найдено
R16 | Контроллер зарядки | Резистор 2,2 кОм | PCM_4ms_Resistor:R_0402 | 1 |  | https://www.chipdip.ru/product/0.062vt-0402-2.2-kom-1-rc0402fr-072k2l-chip-rezistor-yageo-9000451096 | 6
R8 | Контроллер зарядки | Резистор 110 кОм | PCM_4ms_Resistor:R_0402 | 1 |  | https://www.chipdip.ru/product/0.062vt-0402-110-kom-1-chip-rezistor-smd-9000189884 | 4
C17 | Контроллер зарядки | Конденсатор 10 мкФ | PCM_Capacitor_SMD_AKL:C_0603_1608Metric_Pad1.05x0.95mm_HandSolder | 1 |  | https://www.chipdip.ru/product/10mkf-x5r-10v-10-0603-cc0603krx5r6bb106-kondensator-yageo-9000289184 | 8
D11 | Контроллер зарядки | Диод Шоттки, маркировка не указана | PCM_SparkFun-Semiconductor-Standard:SOD-123 | 1 |  | https://www.chipdip.ru/product/1n5817w-diod-shottki-1a-20v-sod-123-hottech-9001276142 | 4
D7 | Контроллер зарядки | Контроллер CN3763 | PCM_Package_SO_AKL:SSOP-10_3.9x4.9mm_P1.00mm | 1 |  | https://www.chipdip.ru/product/cn3763-ponizhayuschiy-pwm-preobrazovatel-dlya-consonance-9001242034 | 36
