BananaGithubserfer/velopath/documentation/orders/rezonit_2026-08-21_from_scratch/assembly/bom_grouped.csv

Refs | Value | Footprint | Qty | DNP
C1,C9 | 105 | Capacitor_SMD:C_0402_1005Metric_Pad0.74x0.62mm_HandSolder | 2
C2-C4,C7,C8,C10,C11 | 104 | Capacitor_SMD:C_0402_1005Metric_Pad0.74x0.62mm_HandSolder | 7
C12,C15,C17 | 10uF | PCM_Capacitor_SMD_AKL:C_0603_1608Metric_Pad1.05x0.95mm_HandSolder | 3
C13,C16 | 100nF | PCM_4ms_Capacitor:C_0402 | 2
C14 | 220nF | PCM_4ms_Capacitor:C_0402 | 1
C18,C19 | 22 uF | PCM_Capacitor_SMD_AKL:C_0402_1005Metric_Pad0.74x0.62mm_HandSolder | 2
C23 | 100nF | PCM_4ms_Capacitor:C_0603 | 1
C24 | 100nF | Capacitor_SMD:C_0603_1608Metric_Pad1.08x0.95mm_HandSolder | 1
C25 | 10nF | Capacitor_SMD:C_0603_1608Metric_Pad1.08x0.95mm_HandSolder | 1
D1,D2 |  | LED_SMD:LED_0603_1608Metric_Pad1.05x0.95mm_HandSolder | 2
D3 | HT7333-A | PCM_Package_TO_SOT_SMD_AKL:SOT-89-3_Handsoldering | 1
D10,D11 |  | PCM_SparkFun-Semiconductor-Standard:SOD-123 | 2
D13 | Red | PCM_LED_SMD_AKL:LED_0603_1608Metric | 1
J1 | charger | PCM_4ms_Connector:Socket_1x02_2.54mm_TH | 1
J2 | battery | Connector_PinSocket_2.54mm:PinSocket_1x03_P2.54mm_Vertical | 1
J3,J6 | control | PCM_SparkFun-Connector:1x01_P2.0mm | 2
J4,J7 | gnd | PCM_SparkFun-Connector:1x01_P2.0mm | 2
J5 | ESC_power | PCM_4ms_Connector:Socket_1x02_2.54mm_TH | 1
JP1 |  | Jumper:SolderJumper-3_P1.3mm_Open_Pad1.0x1.5mm | 1
L2 | 22 uH | PCM_Inductor_SMD_AKL:L_Vishay_IHLP-2525 | 1
P2 | SWD | Connector_PinSocket_2.00mm:PinSocket_1x04_P2.00mm_Vertical | 1
Q1 | HY2122-AB1B | PCM_Package_TO_SOT_SMD_AKL:TSOT-23-6 | 1
Q2,Q3 | N-MOSFET 30V logic-level | Package_TO_SOT_SMD:TO-252-2 | 2
Q6 | 2SJ168 | PCM_Package_TO_SOT_SMD_AKL:SC-59 | 1
R1,R5 | 1k | Resistor_SMD:R_0402_1005Metric_Pad0.72x0.64mm_HandSolder | 2
R2,R7,R11 | 10K | Resistor_SMD:R_0402_1005Metric_Pad0.72x0.64mm_HandSolder | 3
R3,R4 | 4.7K | Resistor_SMD:R_0402_1005Metric_Pad0.72x0.64mm_HandSolder | 2
R6 | 1M | Resistor_SMD:R_0402_1005Metric_Pad0.72x0.64mm_HandSolder | 1
R9,R10 | 470R | Resistor_SMD:R_0603_1608Metric_Pad0.98x0.95mm_HandSolder | 2
R12 | 0.12 | PCM_4ms_Resistor:R_0402 | 1
R13 | 50 kOm | PCM_4ms_Resistor:R_0402 | 1
R14 | 120 | PCM_4ms_Resistor:R_0402 | 1
R15 | 10 kOm | PCM_4ms_Resistor:R_0402 | 1
R16 | 2.2 kOm | PCM_4ms_Resistor:R_0402 | 1
R17 | 10 kOm | Resistor_SMD:R_0402_1005Metric_Pad0.72x0.64mm_HandSolder | 1
R18 | 2k | Resistor_SMD:R_0603_1608Metric_Pad0.98x0.95mm_HandSolder | 1
SW1 | Push_Button | Button_Switch_SMD:SW_SPST_PTS810 | 1
U1 | LIS3MDL | Package_LGA:LGA-12_2x2mm_P0.5mm | 1
U3 | STM32F103RGTx | Package_QFP:LQFP-64_10x10mm_P0.5mm | 1
U6 |  | 2026_314_projects:WH-BLE106 | 1
U7 | CN3765 | PCM_Package_SO_AKL:SSOP-10_3.9x4.9mm_P1.00mm | 1
Y2 | 8MHz | Crystal:Resonator_SMD_Murata_CSTxExxV-3Pin_3.0x1.1mm_HandSoldering | 1
