BananaGithubserfer/velopath/app/velopath3_project/documents/velopath_materials/brochure/assets/velopath-telegram-qr.png

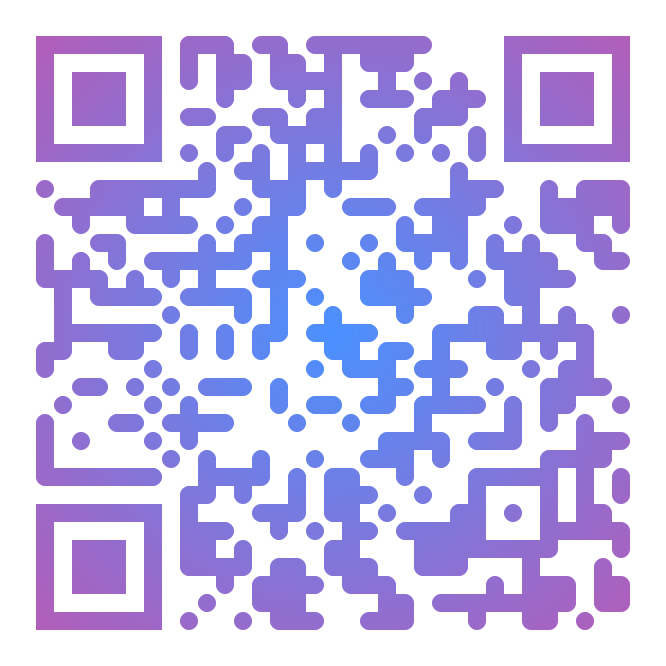
app/velopath3_project/documents/velopath_materials/brochure/assets/velopath-telegram-qr.png
