BananaGithubserfer/velopath/app/velopath3_project/documents/velopath_materials/brochure/screenshots/velopath-home.jpg

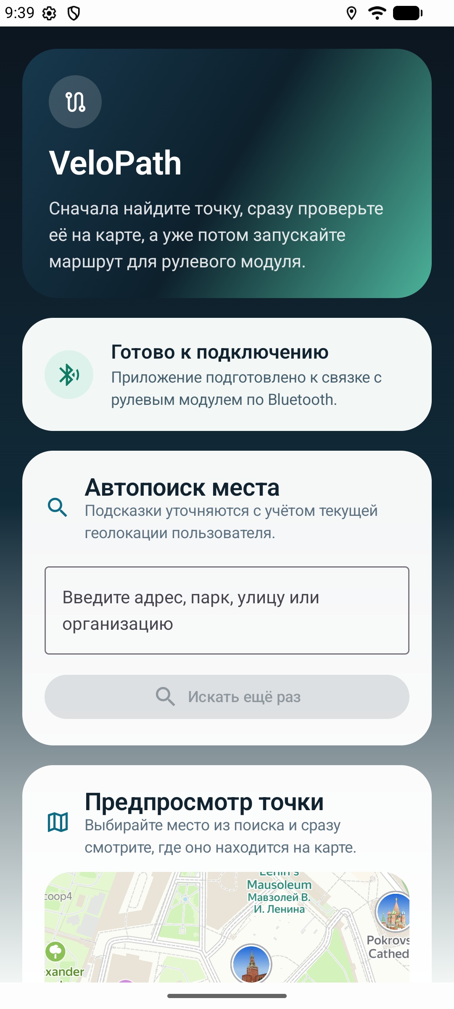
app/velopath3_project/documents/velopath_materials/brochure/screenshots/velopath-home.jpg
