BananaGithubserfer/velopath/documentation/mechanical_cad/сборка.3mf

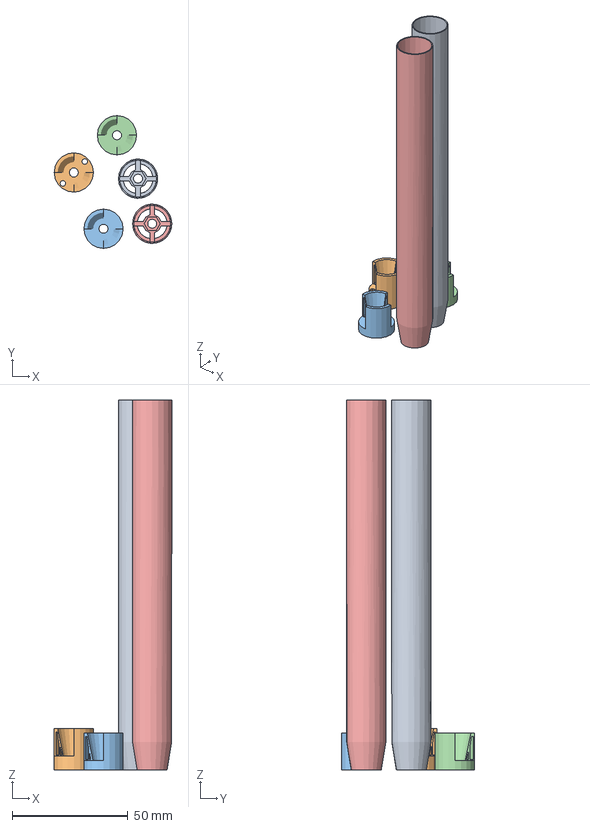
[picture p58: CAD file, 2026-08-09]
documentation/mechanical_cad/сборка.3mf
50.9 x 57.4 x 160.0 mm
корпус.stl
крепеж bat.stl
крепеж пассивный.stl
крепеж.stl
корпус.stl(1)
