BananaGithubserfer/velopath/documentation/mechanical_cad/Фрагмент.dxf

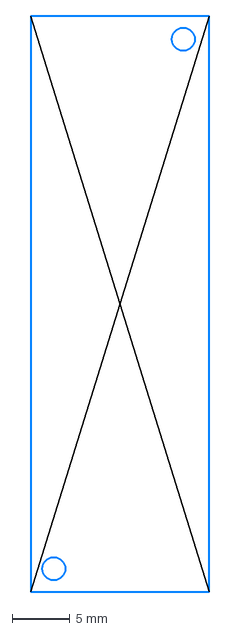
[picture p59: CAD file, 2026-08-09]
documentation/mechanical_cad/Фрагмент.dxf
15.5 x 50.0 mm
