BananaGithubserfer/velopath/documentation/mechanical_cad/крепеж пассивный.stl

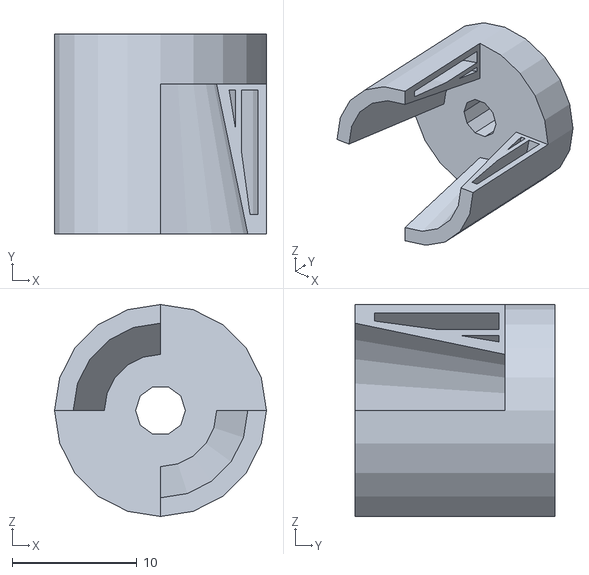
[picture p60: CAD file, 2026-08-09]
documentation/mechanical_cad/крепеж пассивный.stl
17.0 x 16.0 x 17.0
