BananaGithubserfer/velopath/documentation/mechanical_cad/корпус.stl

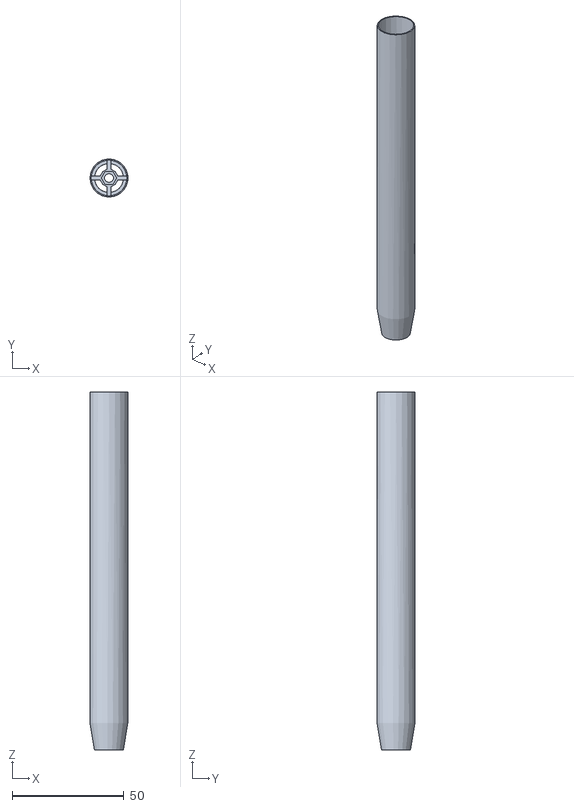
[picture p61: CAD file, 2026-08-09]
documentation/mechanical_cad/корпус.stl
17.0 x 17.0 x 160.0
