BananaGithubserfer/velopath/documentation/mechanical_cad/крепеж bat.stl

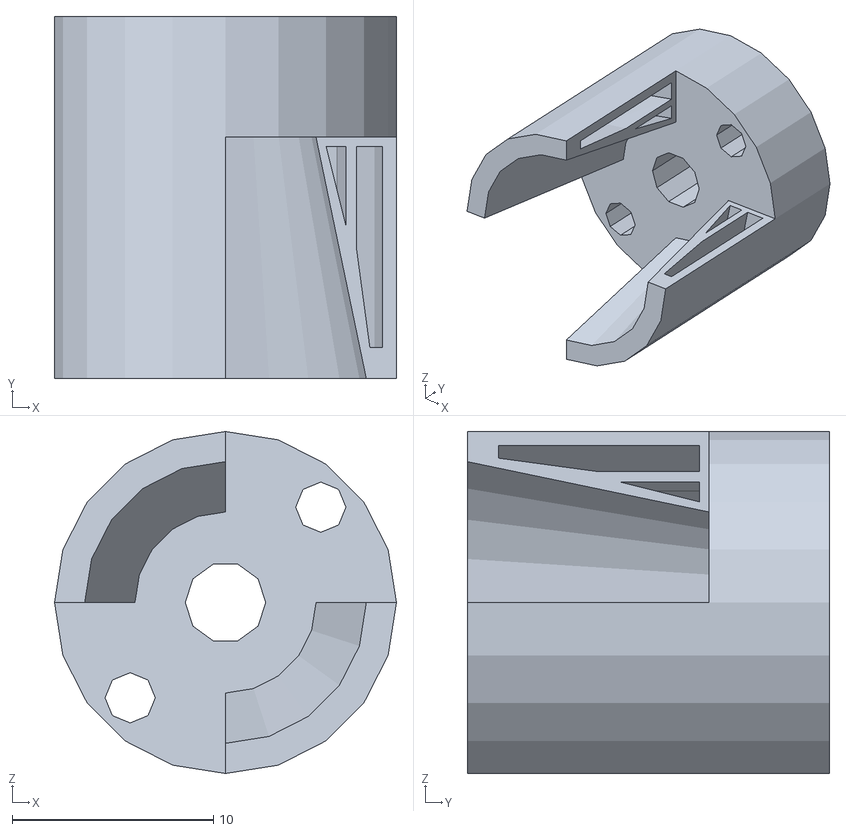
[picture p62: CAD file, 2026-08-09]
documentation/mechanical_cad/крепеж bat.stl
17.0 x 18.0 x 17.0
