BananaGithubserfer/velopath/(list of files, cad)

Other CAD files:
documentation/mechanical_cad/зарядка.3mf
documentation/mechanical_cad/крепеж.stl
documentation/mechanical_cad/зарядка.stl
