BananaGithubserfer/velopath/app/velopath3_project/artifacts/test-report-2026-04-02/09-ride-after-build.png

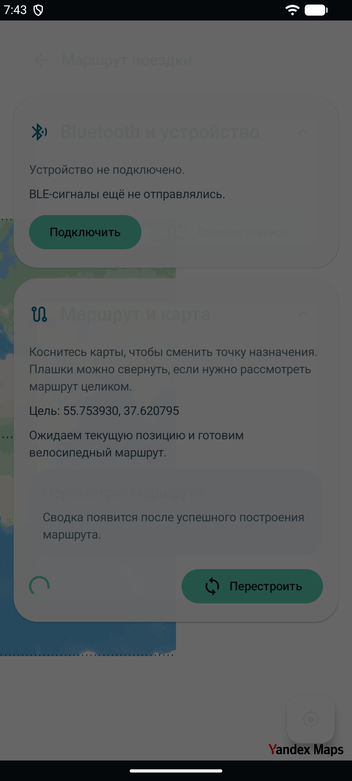
app/velopath3_project/artifacts/test-report-2026-04-02/09-ride-after-build.png
