BananaGithubserfer/velopath/app/velopath3_project/artifacts/ble_test_report_20260404_151605.txt

VeloPath BLE Test Report (Retry)
===============================
Timestamp: 2026-04-04 15:16:05
Workspace: C:\Users\vladimir.DESKTOP-L4RFPI0\AndroidStudioProjects\velopath3

Test Attempt
------------
- Command: python firmware/tools/ble_stable_terminal.py --retries 6 --pair-reset-on-fail --max-runtime 120
- Outcome:
  * ATTEMPT 1 FAILED: BLE device 'VeloPath' not found
  * ATTEMPT 2 FAILED: BLE device 'VeloPath' not found (after repair cycle)
  * ATTEMPT 3 FAILED: BLE device 'VeloPath' not found (after repair cycle)
  * Timed out after 120s

Summary
-------
- BLE advertising for VeloPath/WH-BLE 106 not visible during this window.
- No GATT connection or console testing possible without advertisement.
