BananaGithubserfer/velopath/app/velopath3_project/artifacts/test-report-2026-04-02-final/00-current.png

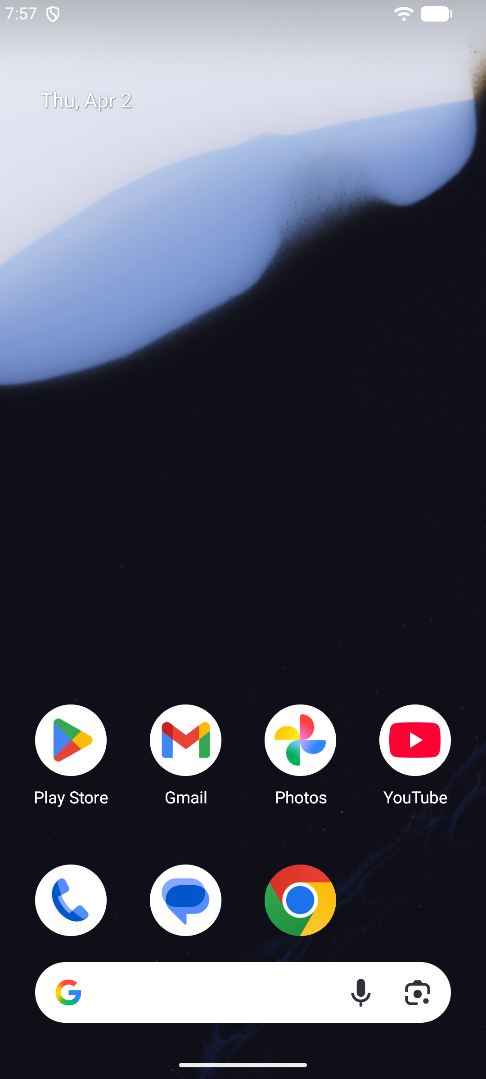
app/velopath3_project/artifacts/test-report-2026-04-02-final/00-current.png
