BananaGithubserfer/velopath/app/velopath3_project/artifacts/test-report-2026-04-02-final/02-after-wait.png

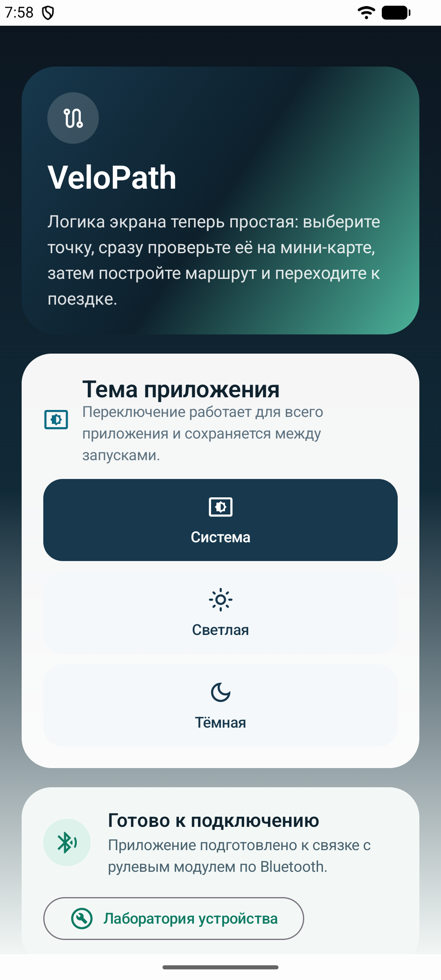
app/velopath3_project/artifacts/test-report-2026-04-02-final/02-after-wait.png
