BananaGithubserfer/velopath/app/velopath3_project/artifacts/test-report-2026-04-02-final/05-current-after-lab-tap.png

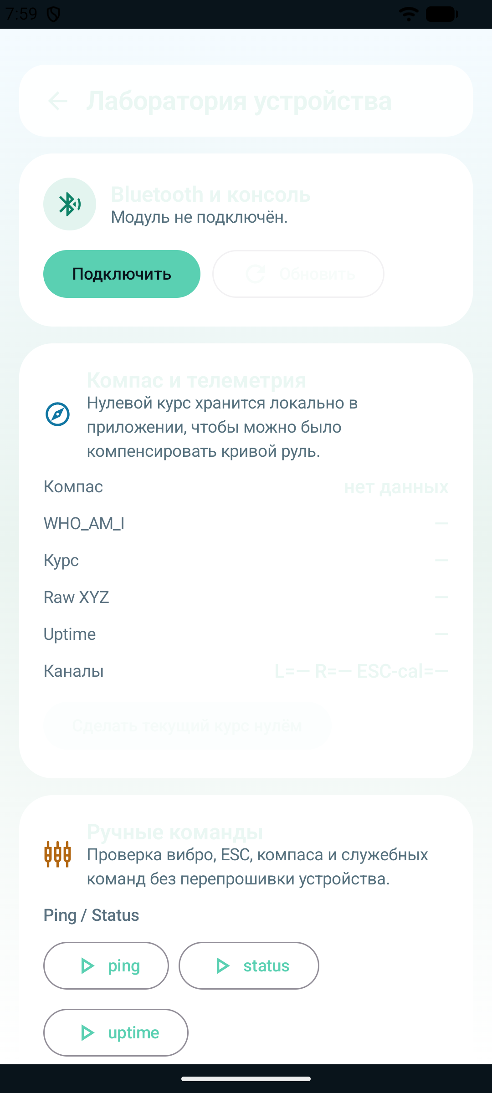
app/velopath3_project/artifacts/test-report-2026-04-02-final/05-current-after-lab-tap.png
