BananaGithubserfer/velopath/app/velopath3_project/artifacts/test-report-2026-04-02-final/07-dashboard-quickstart-dark.png

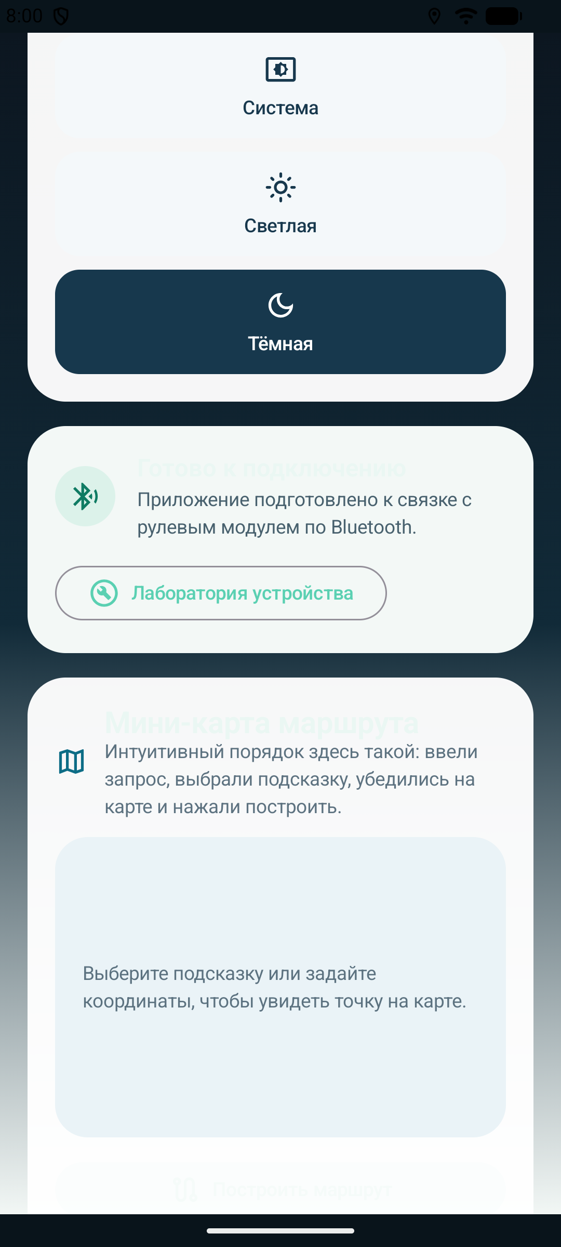
app/velopath3_project/artifacts/test-report-2026-04-02-final/07-dashboard-quickstart-dark.png
