BananaGithubserfer/velopath/app/velopath3_project/artifacts/test-report-2026-04-02-final/08-dashboard-lower.png

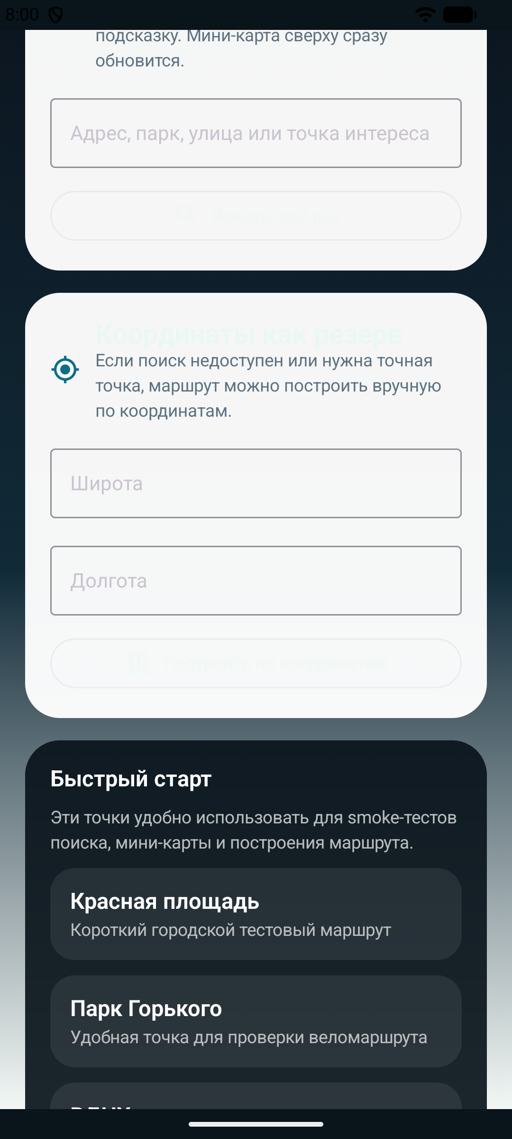
app/velopath3_project/artifacts/test-report-2026-04-02-final/08-dashboard-lower.png
