BananaGithubserfer/velopath/app/velopath3_project/artifacts/test-report-2026-04-02-final/10-ride-collapsed-dark.png

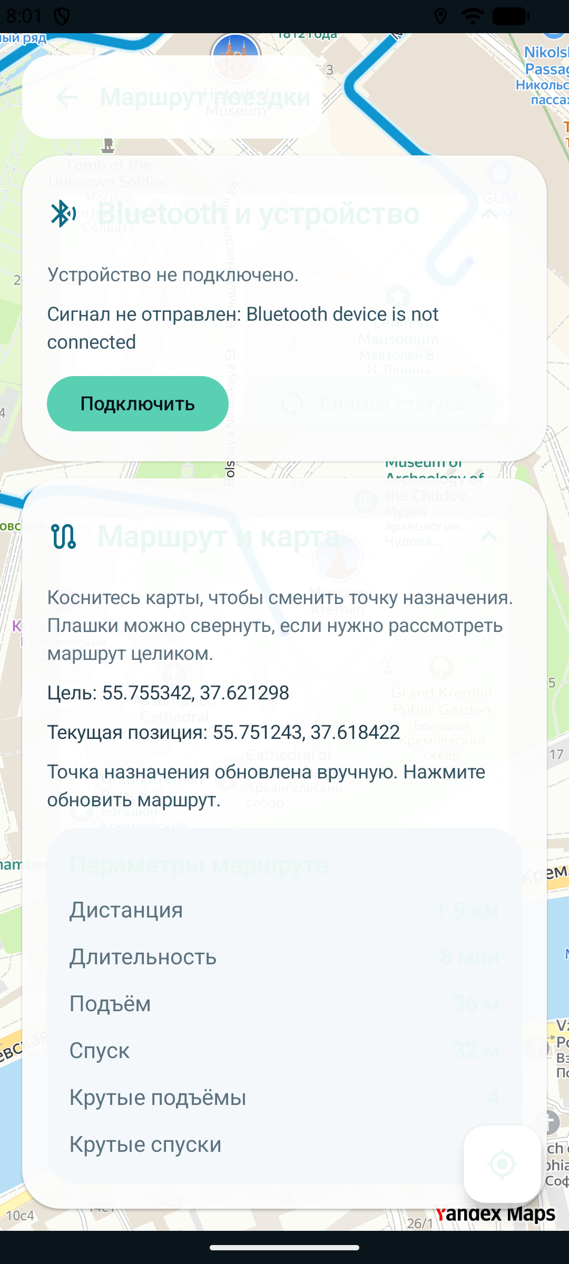
app/velopath3_project/artifacts/test-report-2026-04-02-final/10-ride-collapsed-dark.png
