BananaGithubserfer/velopath/app/velopath3_project/artifacts/test-report-2026-04-02-final/17-dashboard-dark-final-explicit.png

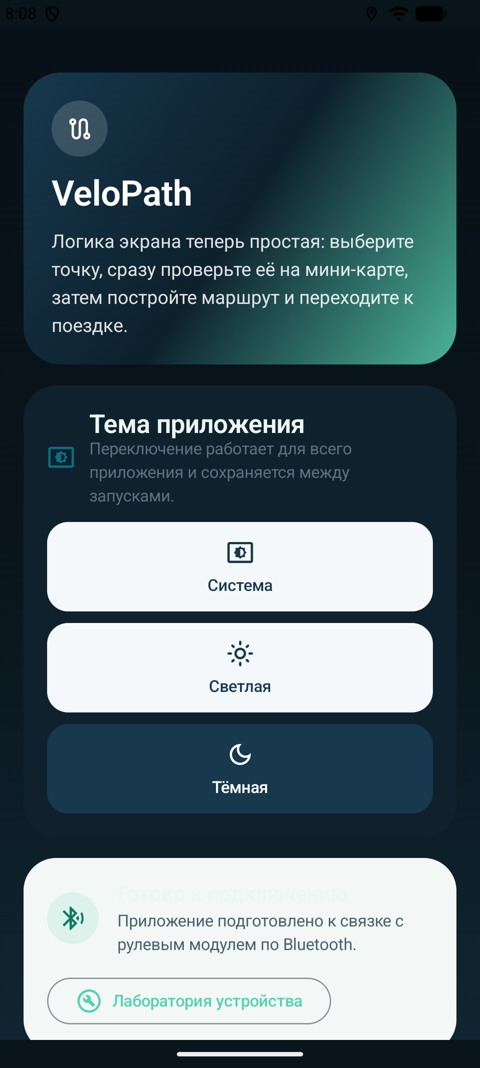
app/velopath3_project/artifacts/test-report-2026-04-02-final/17-dashboard-dark-final-explicit.png
