BananaGithubserfer/velopath/app/velopath3_project/artifacts/test-report-2026-04-02-final/19-device-lab-dark-final.png

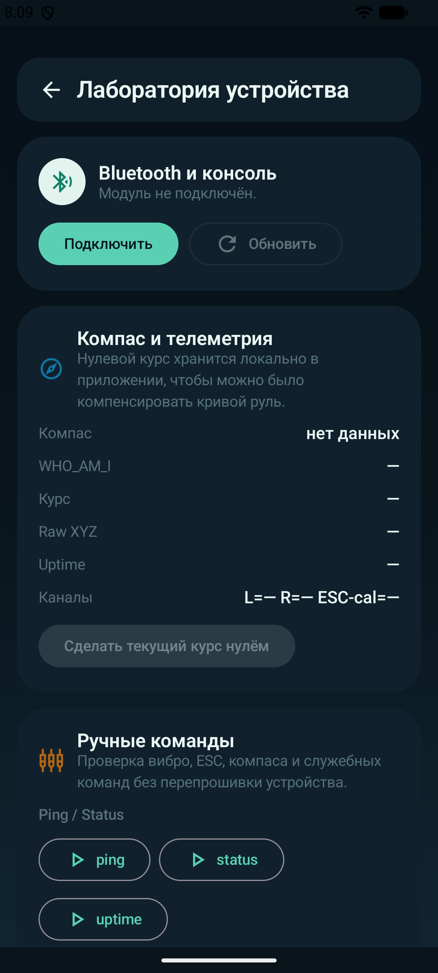
app/velopath3_project/artifacts/test-report-2026-04-02-final/19-device-lab-dark-final.png
