BananaGithubserfer/velopath/app/velopath3_project/artifacts/test-report-2026-04-02-final/route-collapsed-final.png

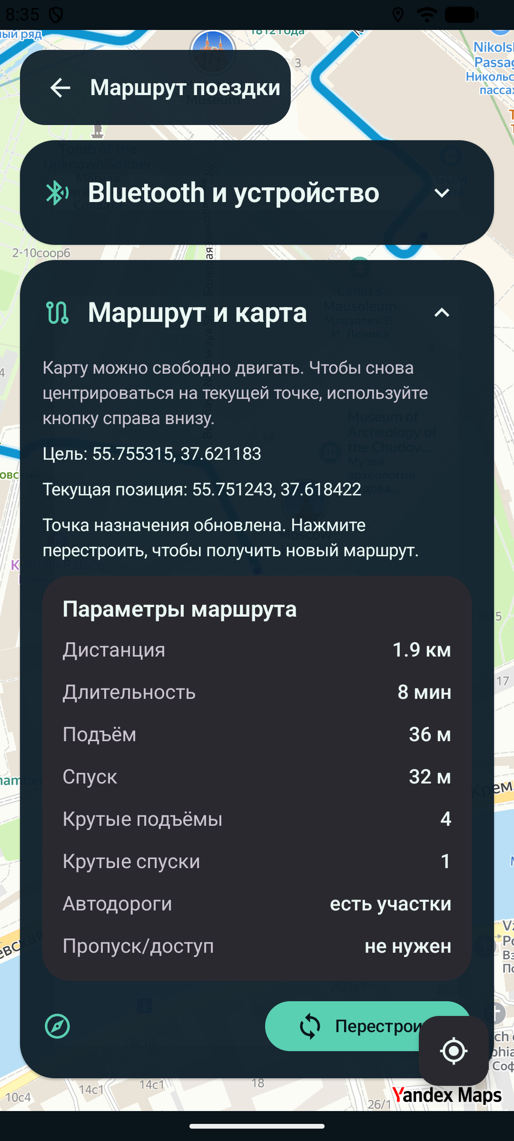
app/velopath3_project/artifacts/test-report-2026-04-02-final/route-collapsed-final.png
