BananaGithubserfer/velopath/app/velopath3_project/artifacts/test-report-2026-04-02-final/route-intent-final.png

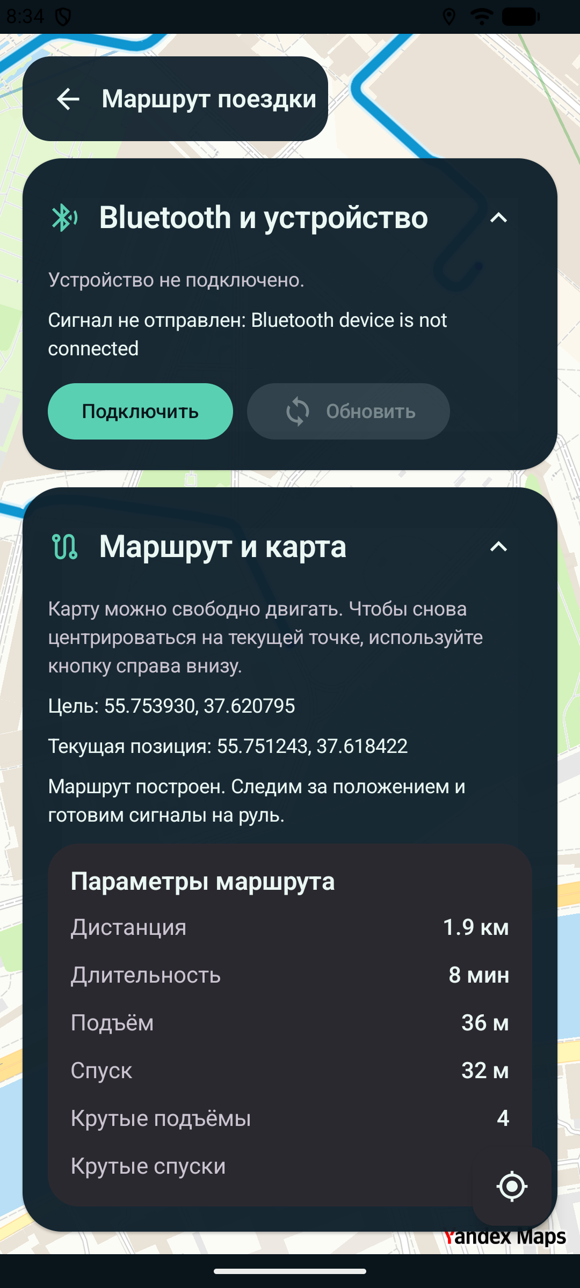
app/velopath3_project/artifacts/test-report-2026-04-02-final/route-intent-final.png
