BananaGithubserfer/velopath/app/velopath3_project/artifacts/test-report-2026-04-02/04-dashboard-presets.png

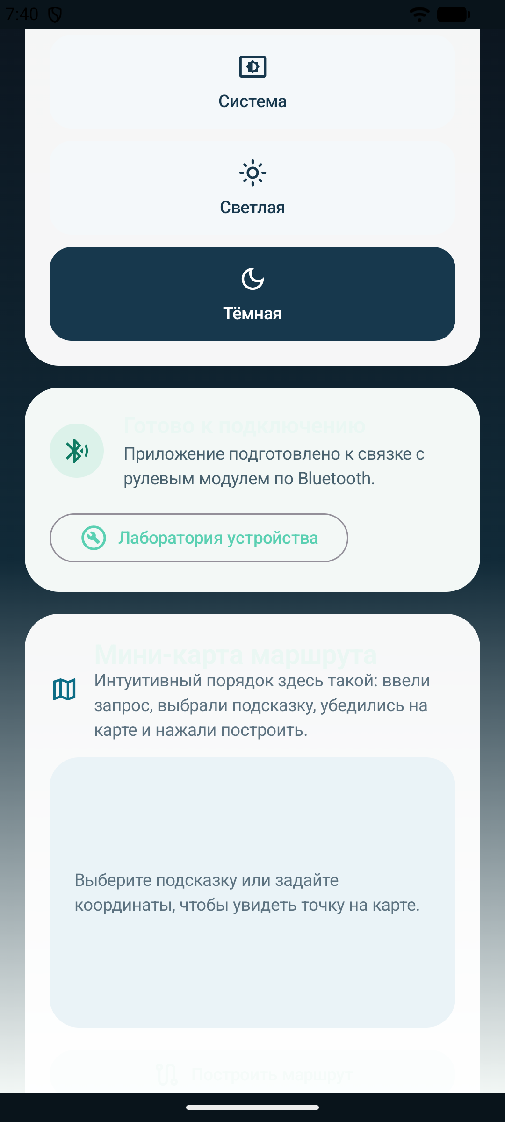
app/velopath3_project/artifacts/test-report-2026-04-02/04-dashboard-presets.png
