BananaGithubserfer/velopath/app/velopath3_project/artifacts/test-report-2026-04-02/05-dashboard-scrolled.png

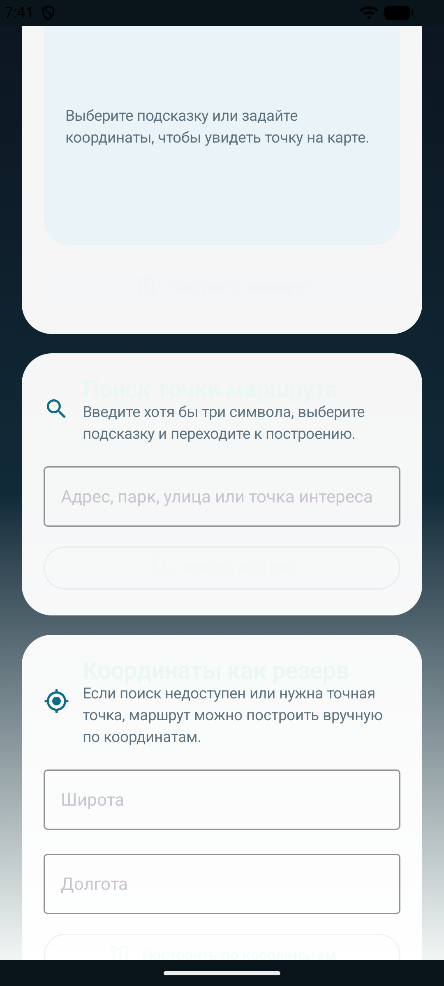
app/velopath3_project/artifacts/test-report-2026-04-02/05-dashboard-scrolled.png
