BananaGithubserfer/velopath/app/velopath3_project/artifacts/test-report-2026-04-02/06-dashboard-quickstart.png

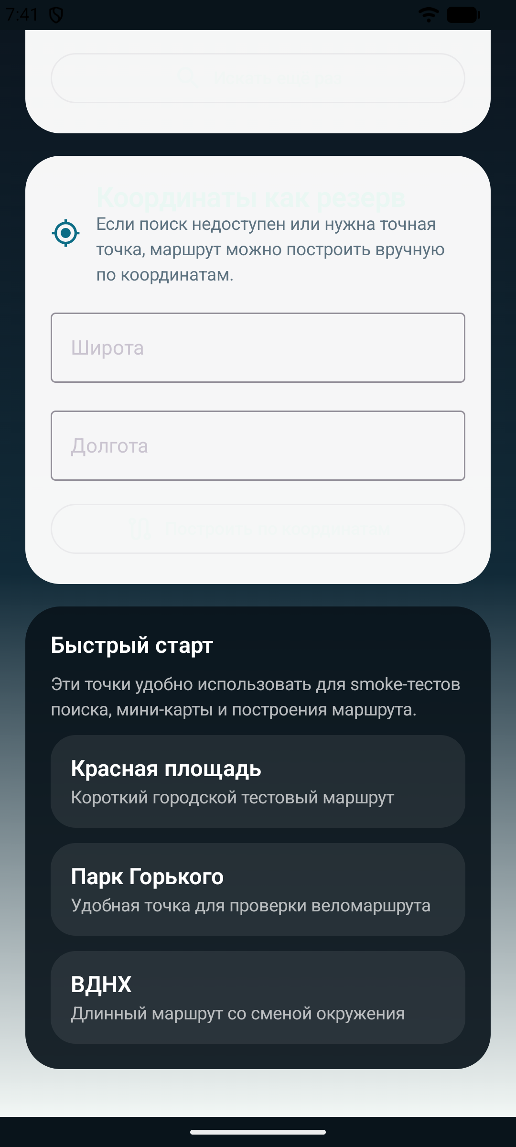
app/velopath3_project/artifacts/test-report-2026-04-02/06-dashboard-quickstart.png
