BananaGithubserfer/velopath/app/velopath3_project/artifacts/test-report-2026-04-02/07-dashboard-after-preset.png

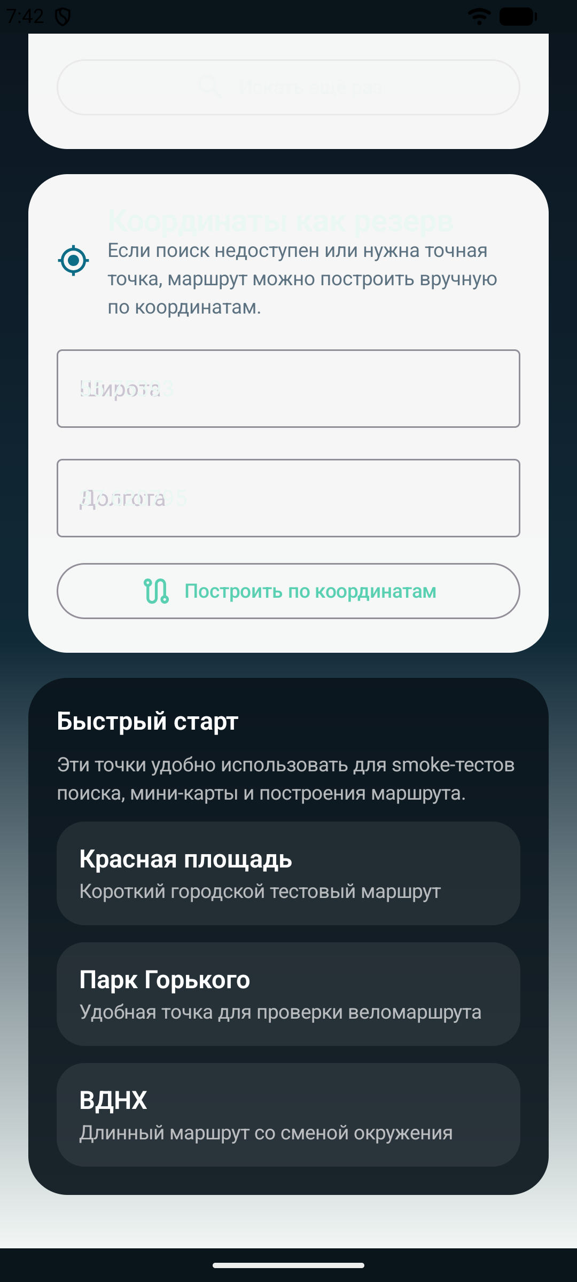
app/velopath3_project/artifacts/test-report-2026-04-02/07-dashboard-after-preset.png
