BananaGithubserfer/velopath/app/velopath3_project/artifacts/test-report-2026-04-02/08-ride-screen.png

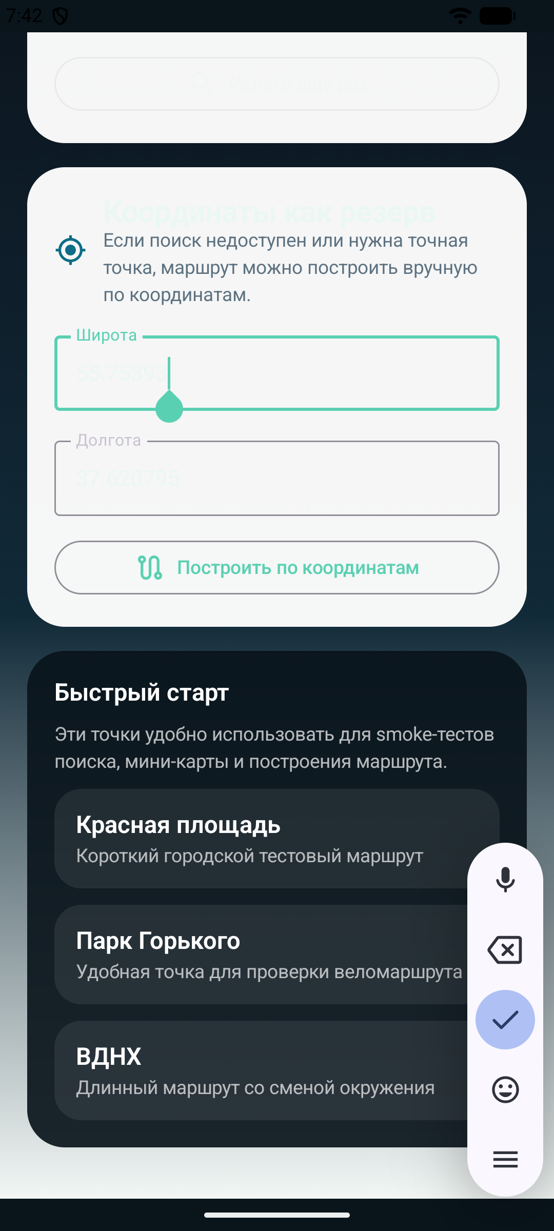
app/velopath3_project/artifacts/test-report-2026-04-02/08-ride-screen.png
