BananaGithubserfer/velopath/app/velopath3_project/artifacts/test-report-2026-04-02/10-ride-collapsed.png

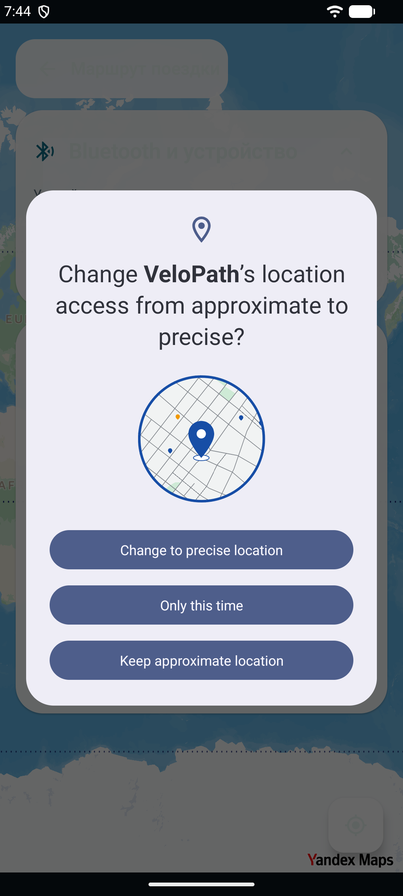
app/velopath3_project/artifacts/test-report-2026-04-02/10-ride-collapsed.png
