BananaGithubserfer/velopath/app/velopath3_project/artifacts/test-report-2026-04-02/11-ride-after-precise.png

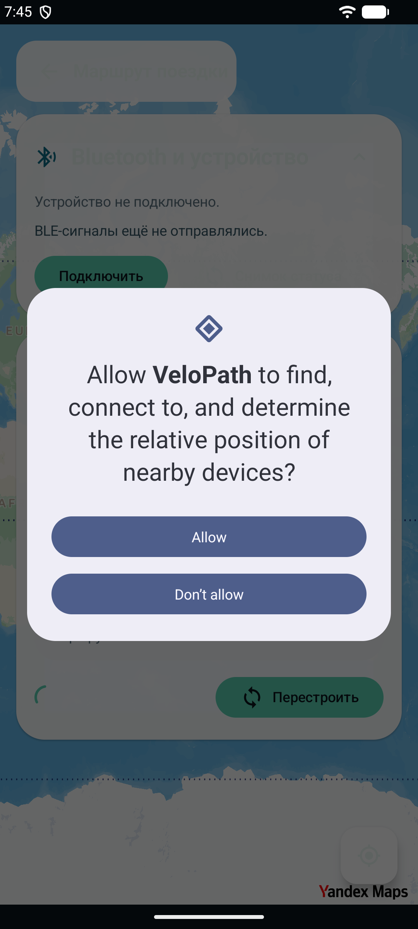
app/velopath3_project/artifacts/test-report-2026-04-02/11-ride-after-precise.png
