BananaGithubserfer/velopath/advertising/brochures/Velopath Буклет.pdf

# Что это?

# Для кого?

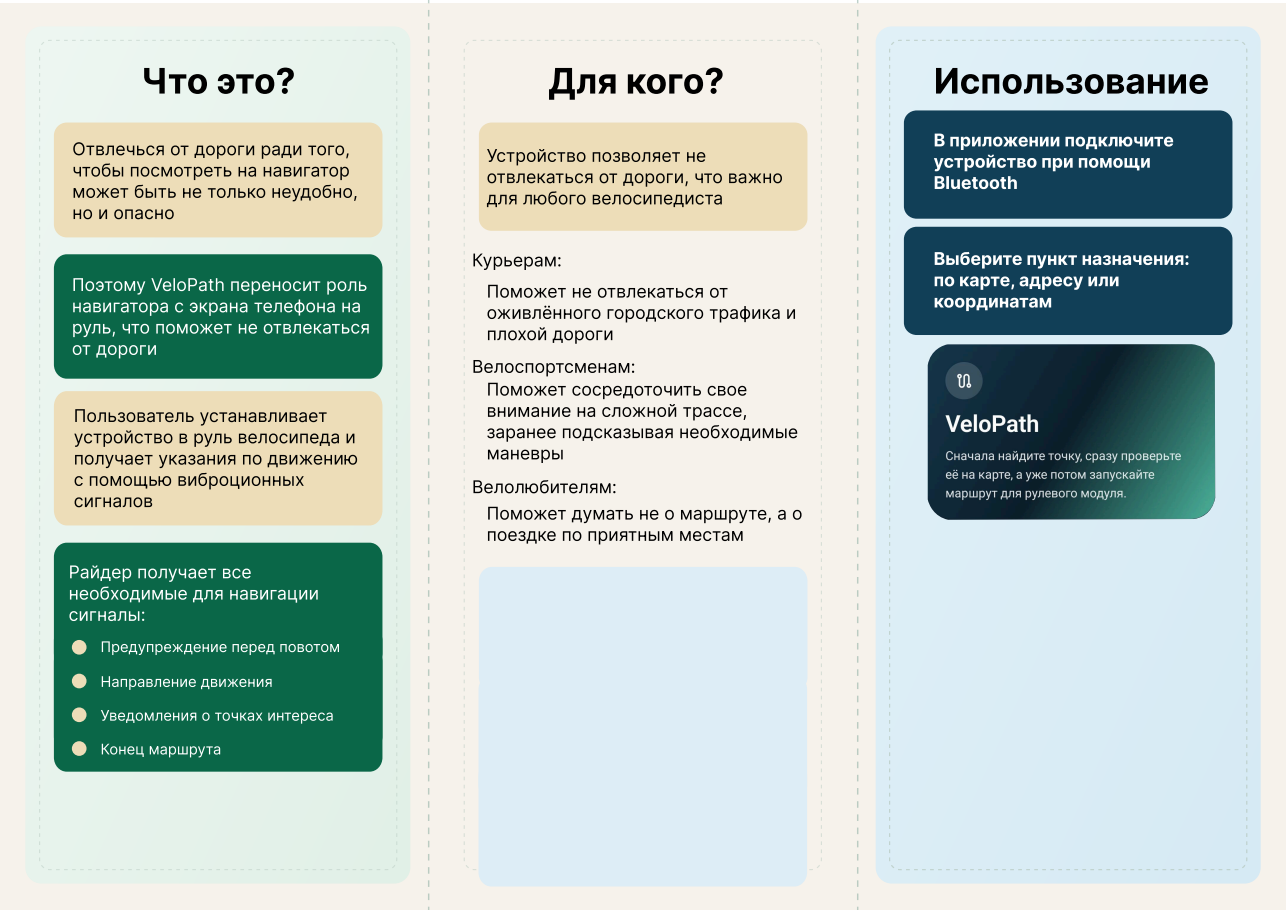
[picture p88: page 1]
но и опасно; Использование; от дороги; Пользователь устанавливает; сигналов; Курьерам:; плохой дороги; Велоспортсменам:; маневры; Велолюбителям:; координатам; сигналы:; Направление движения; Конец маршрута

В приложении подключите
устройство при помощи
Bluetooth

Отвлечься от дороги ради того,

Устройство позволяет не

чтобы посмотреть на навигатор

отвлекаться от дороги, что важно

может быть не только неудобно,

для любого велосипедиста

Выберите пункт назначения:

по карте, адресу или

Поэтому VeloPath переносит роль
навигатора с экрана телефона на

Поможет не отвлекаться от
оживлённого городского трафика и

руль, что поможет не отвлекаться

Поможет сосредоточить свое

внимание на сложной трассе,

заранее подсказывая необходимые

устройство в руль велосипеда и

получает указания по движению
с помощью виброционных

Поможет думать не о маршруте, а о

поездке по приятным местам

Райдер получает все

необходимые для навигации

Предупреждение перед повотом

Уведомления о точках интереса
