BananaGithubserfer/velopath/advertising/presentations/VELOPATH.pdf

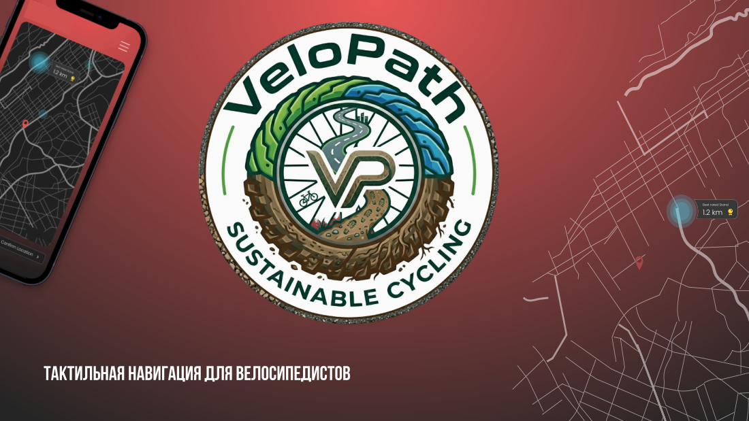
[picture p89: page 1]

Slide Deck Title

Best rated Stand

This is just the beginning of something big.

тактильная навигация для велосипедистов

# Проблематика

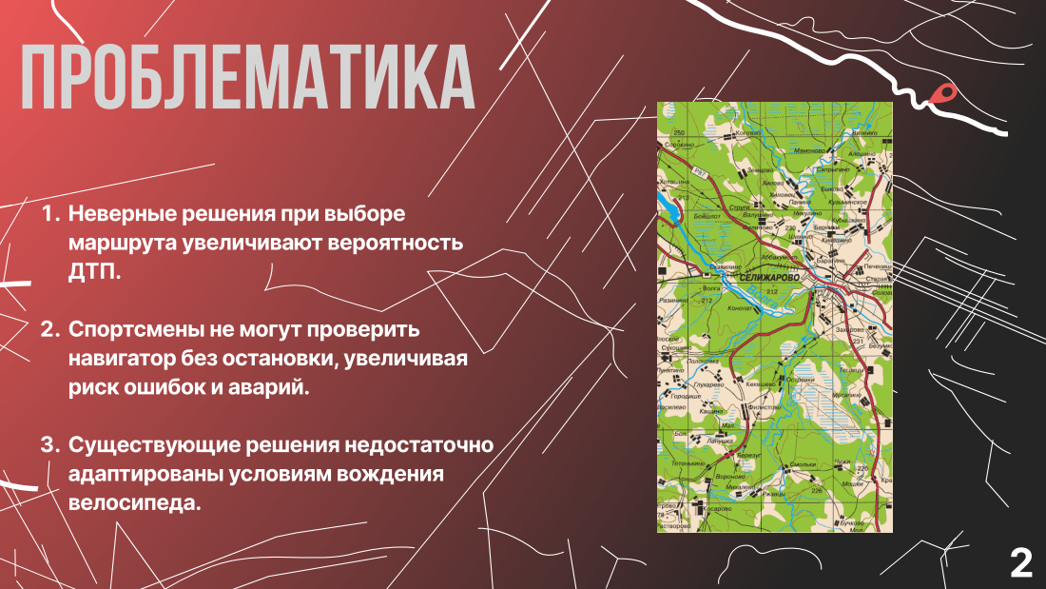
[picture p90: page 2]

Неверные решения при выборе
маршрута увеличивают вероятность
ДТП.
is just the beginninцукцуйацуацйуацуацйауg of something big.

Спортсмены не могут проверить
навигатор без остановки, увеличивая
риск ошибок и аварий.

Существующие решения недостаточно
адаптированы условиям вождения
велосипеда.

# АКТУальность

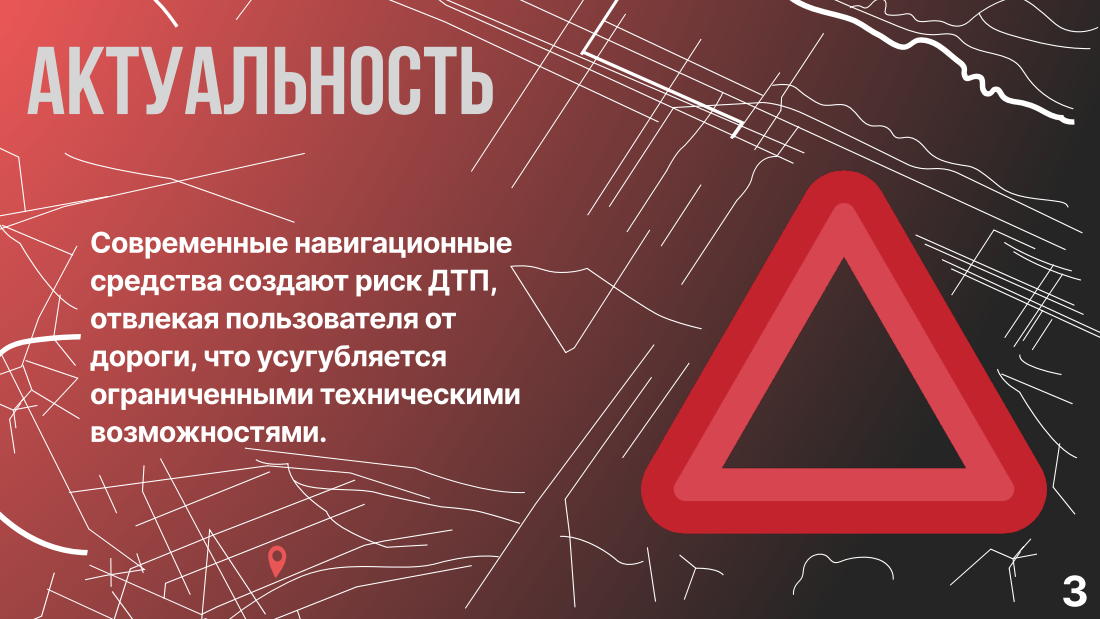
[picture p91: page 3]

Современные навигационные
Slide Deck Title
средства создают риск ДТП,

отвлекая пользователя от
This is just the beginning of something big.
дороги, что усугубляется
ограниченными техническими
возможностями.

# концепция

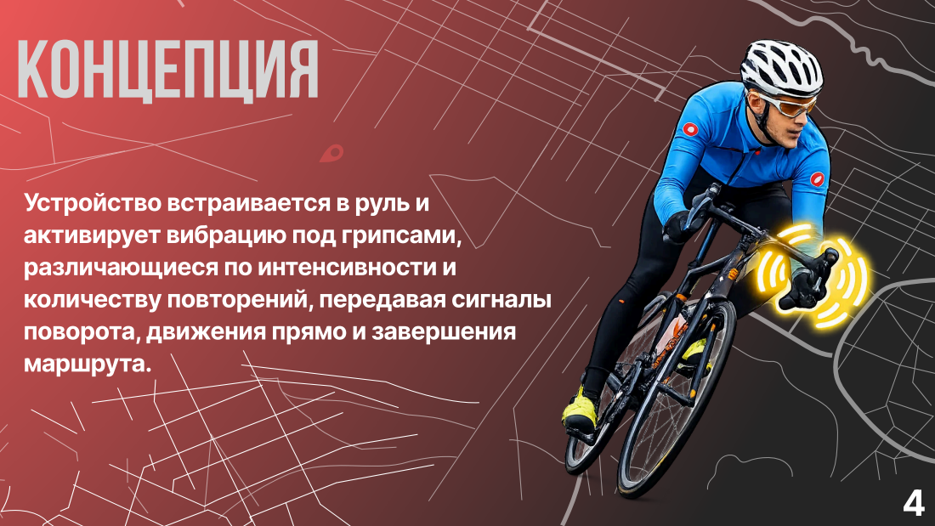
[picture p92: page 4]

Устройство встраивается в руль и
активирует вибрацию под грипсами,
различающиеся по интенсивности и
количеству повторений, передавая сигналы
поворота, движения прямо и завершения
маршрута.

# ЦЕЛЬ

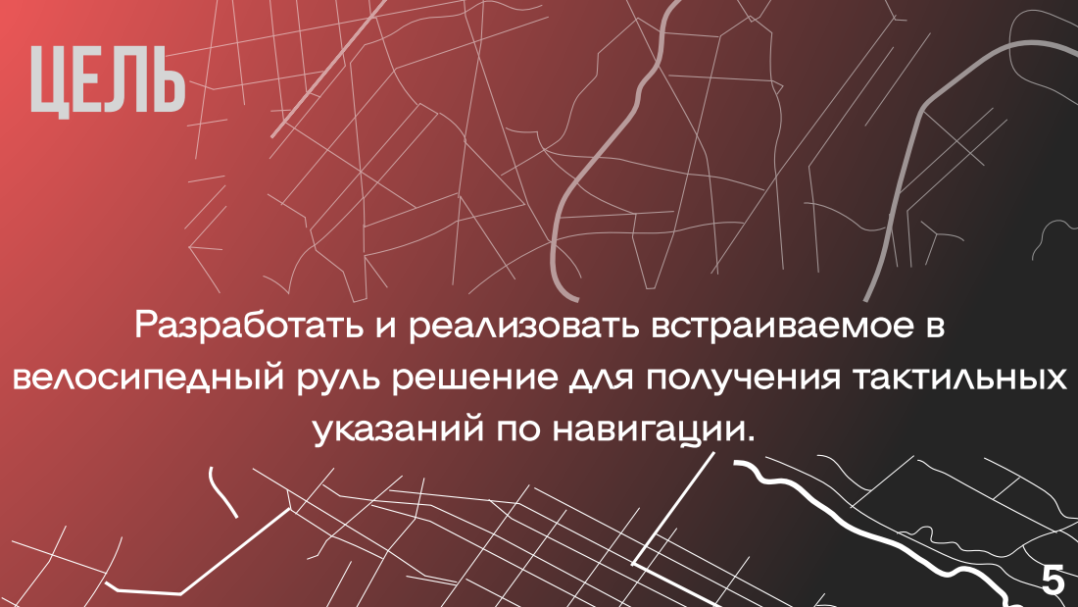
[picture p93: page 5]

Slide Deck Title
Разработать и реализовать встраиваемое в
This is just the beginning of something big.
велосипедный руль решение для получения тактильных

указаний по навигации.

# Задачи

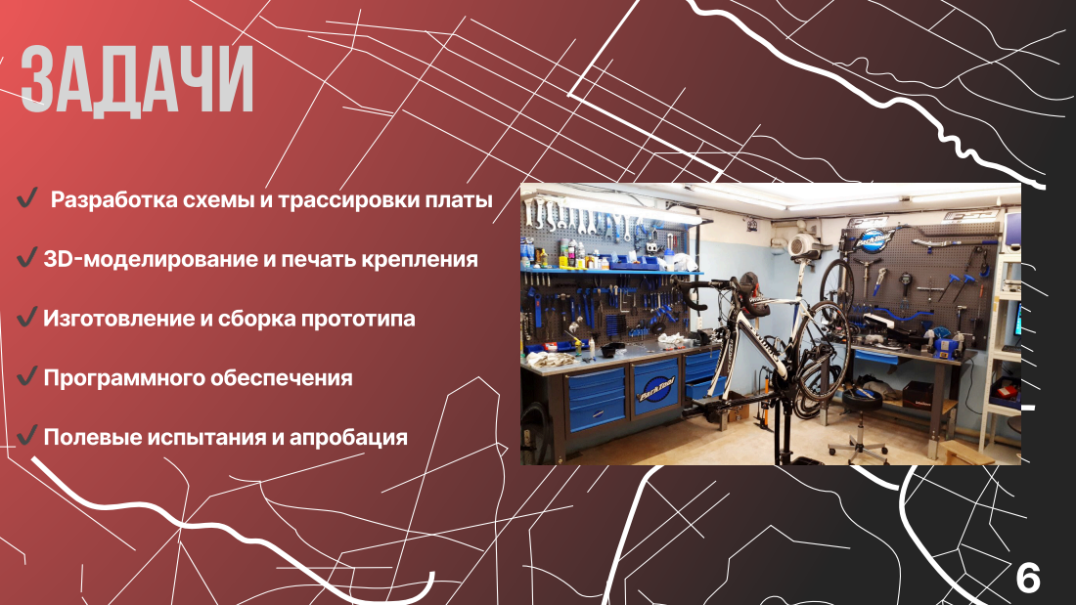
[picture p94: page 6]
Программного обеспечения

Разработка схемы и трассировки платы

3D-моделирование и печать крепления

Изготовление и сборка прототипа

Полевые испытания и апробация

# Целевая Аудитория

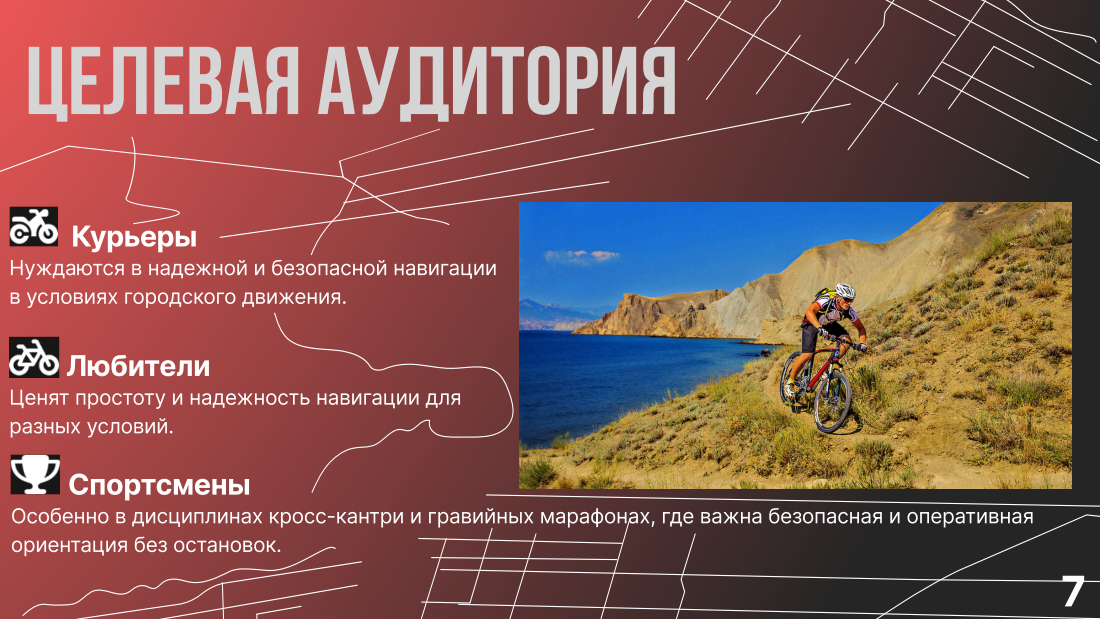
[picture p95: page 7]
Курьеры; Любители; разных условий.; Спортсмены

Нуждаются в надежной и безопасной навигации
в условиях городского движения.

This is just the beginning of something big.

Ценят простоту и надежность навигации для

Особенно в дисциплинах кросс-кантри и гравийных марафонах, где важна безопасная и оперативная
ориентация без остановок.

# Преимущества velopath

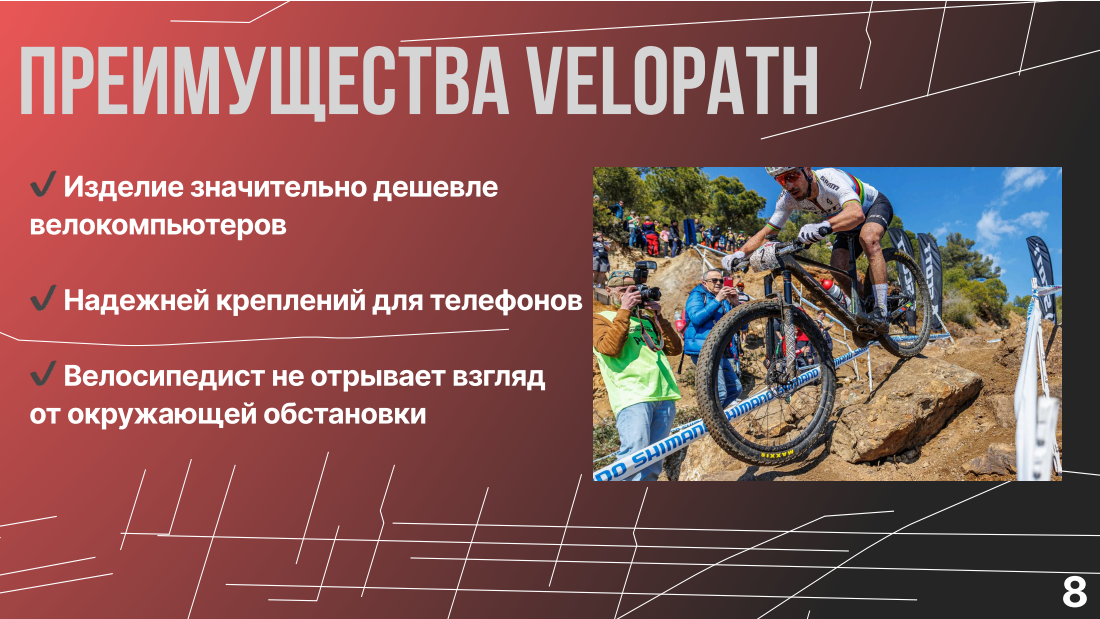
[picture p96: page 8]

Изделие значительно дешевле
велокомпьютеров
Slide Deck Title
Надежней креплений для телефонов

This is just the beginning of something big.
Велосипедист не отрывает взгляд
от окружающей обстановки

# Как работает

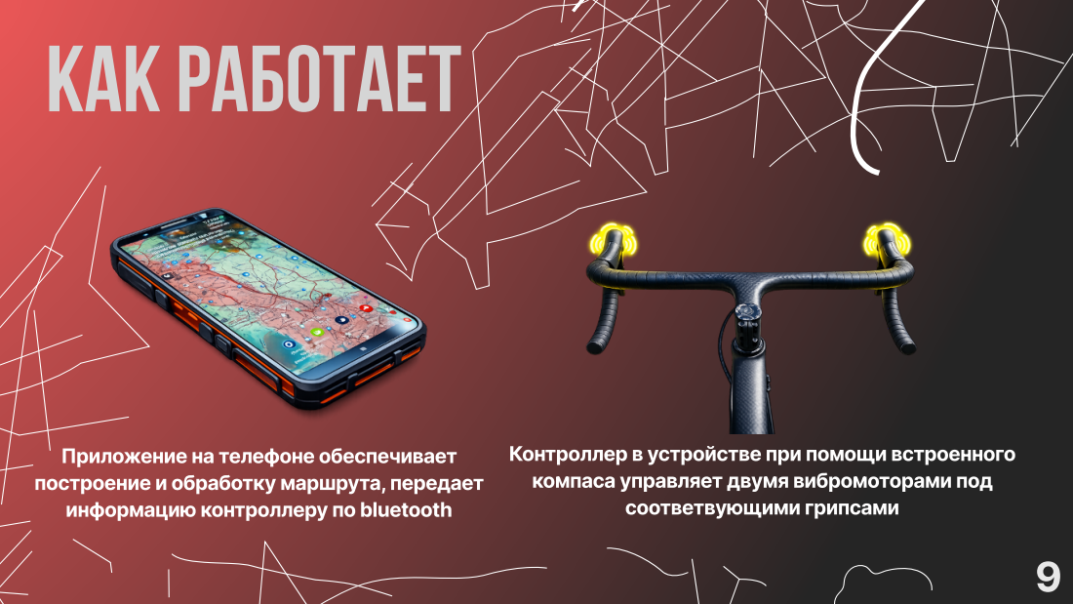
[picture p97: page 9]
соответвующими грипсами

Slide Deck Title

This is just the beginning of something big.

Приложение на телефоне обеспечивает
построение и обработку маршрута, передает
информацию контроллеру по bluetooth

Контроллер в устройстве при помощи встроенного
компаса управляет двумя вибромоторами под

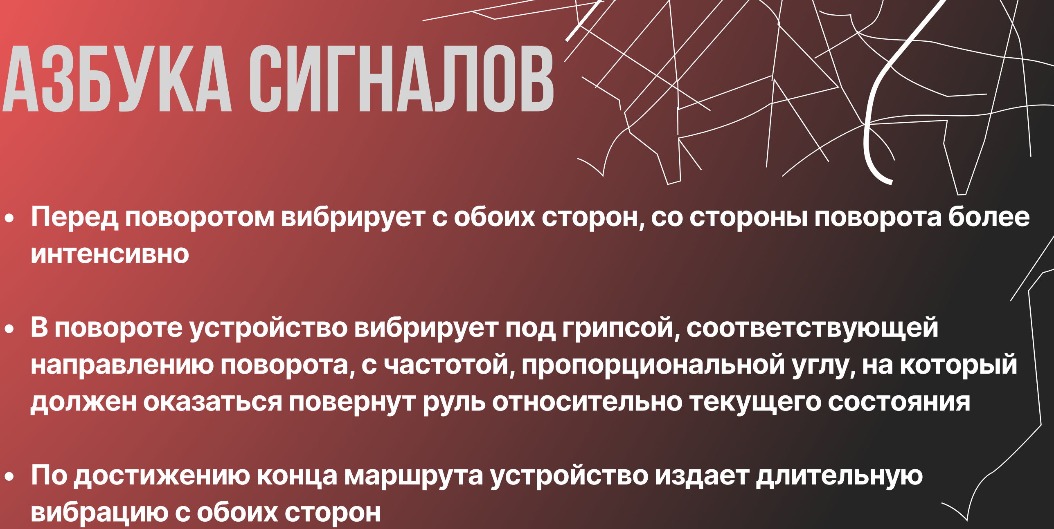
[picture p98: figure]
Slide Deck Title; Азбука сигналов; интенсивно; вибрацию с обоих сторон

This is just the beginning of something big.

Перед поворотом вибрирует с обоих сторон, со стороны поворота более

В повороте устройство вибрирует под грипсой, соответствующей направлению поворота, с частотой, пропорциональной углу, на который должен оказаться повернут руль относительно текущего состояния

По достижению конца маршрута устройство издает длительную

# Компоненты

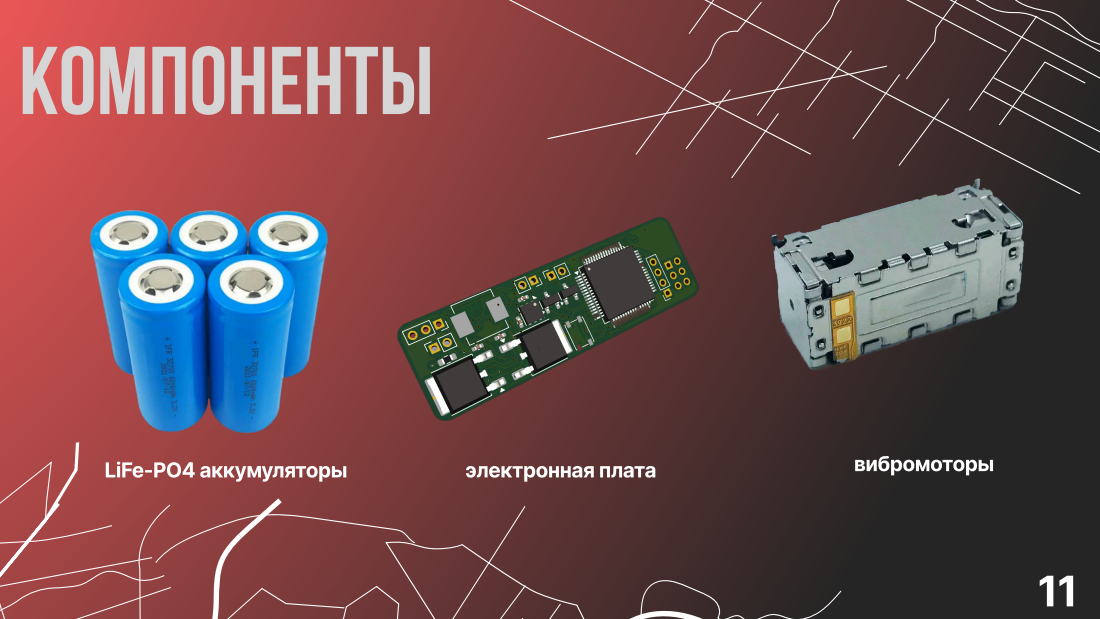
[picture p99: page 11]
LiFe-PO4 аккумуляторы; электронная плата; вибромоторы

Slide Deck Title

This is just the beginning of something big.

# Разработка прототипа

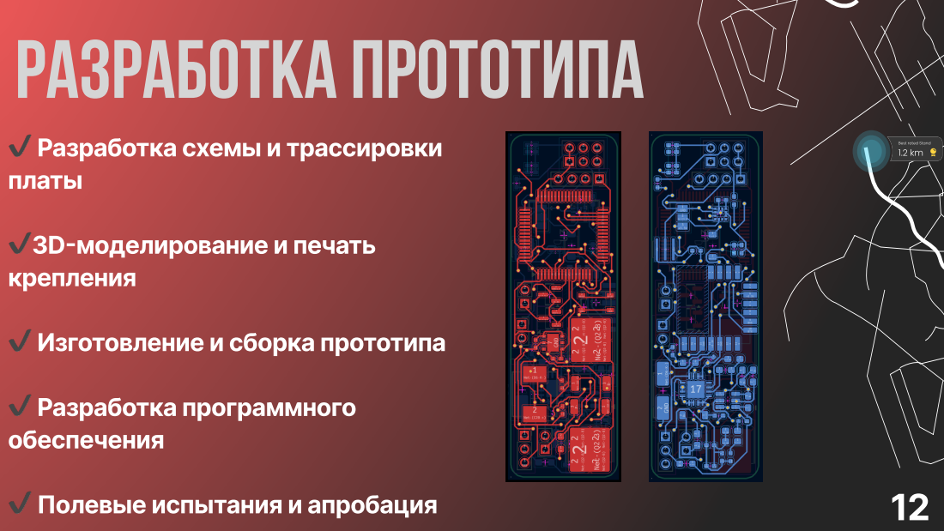
[picture p100: page 12]
Разработка программного обеспечения

Разработка схемы и трассировки
платы
Slide Deck Title
3D-моделирование и печать
крепления

Best rated Stand

This is just the beginning of something big.
Изготовление и сборка прототипа

Полевые испытания и апробация

# Реализация продукта

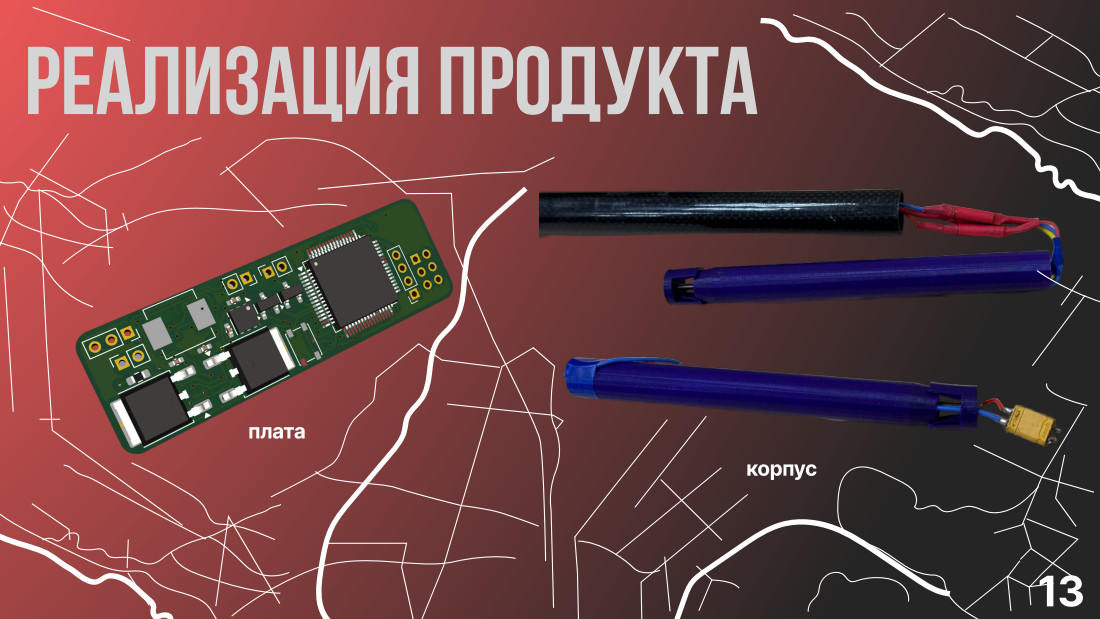
[picture p101: page 13]
плата; корпус

# Перспективы

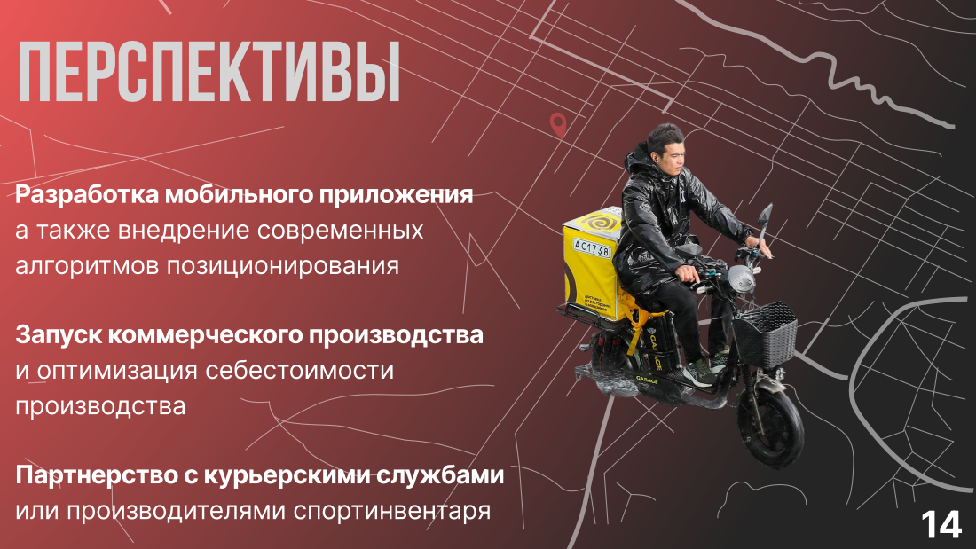
[picture p102: page 14]
или производителями спортинвентаря

Разработка мобильного приложения
а также внедрение современных
алгоритмов позиционирования

This is just the beа также внедрение современных алгоритмов
позиционированияginning of something big.

Запуск коммерческого производства
и оптимизация себестоимости
производства

Партнерство с курьерскими службами

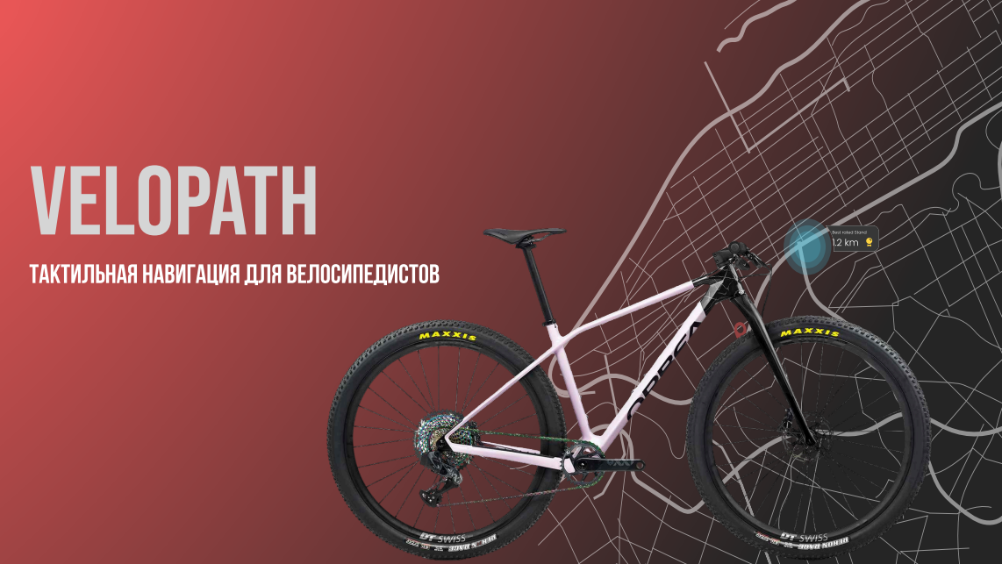
[picture p103: page 15]

Best rated Stand VELOPATH
Slide Deck Title
тактильная навигация для велосипедистов

This is just the beginning of something big.
