BananaGithubserfer/velopath/advertising/brochures/Velopath Буклет (2).pdf

### АРХИТЕКТУРА

### Приложение строит маршрут, а

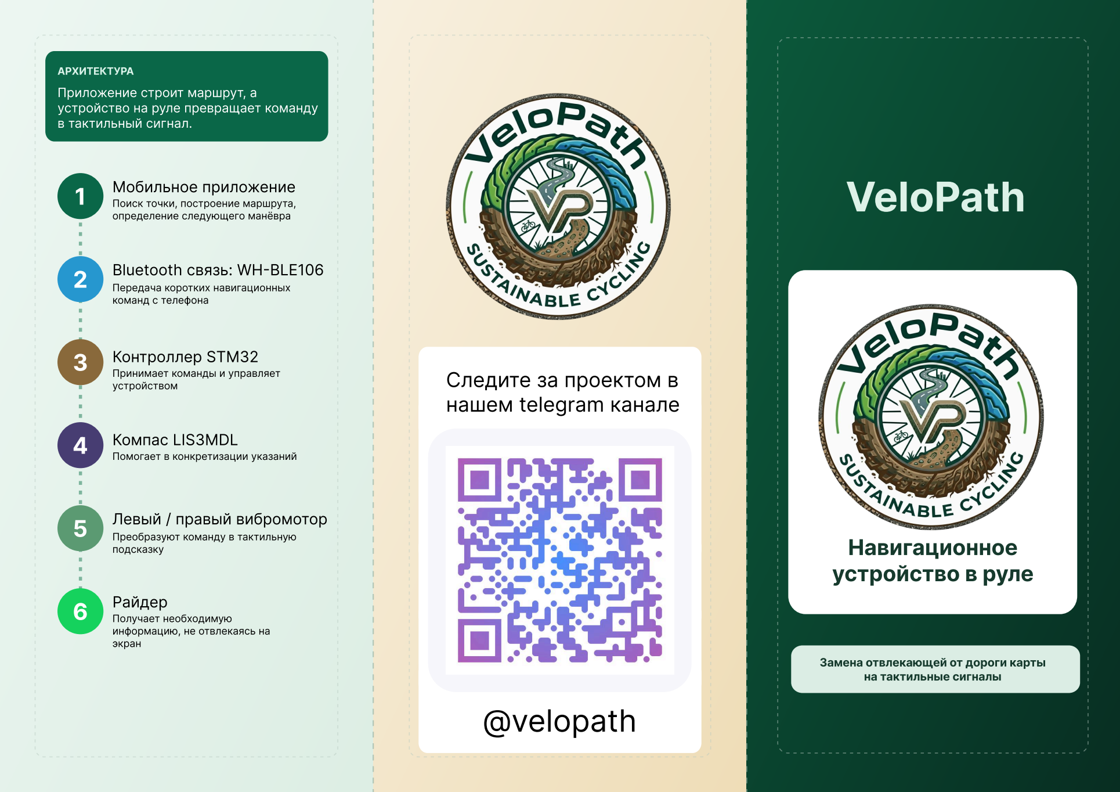
[picture p104: page 1]
в тактильный сигнал.; Мобильное приложение; VeloPath; Контроллер STM32; устройством; Следите за проектом в; Компас LIS3MDL; Левый / правый вибромотор; подсказку; Навигационное; устройство в руле; Райдер; экран; @velopath

устройство на руле превращает команду

Поиск точки, построение маршрута,

определение следующего манёвра

Bluetooth связь: WH-BLE106

Передача коротких навигационных
команд с телефона

Принимает команды и управляет

нашем telegram канале

Помогает в конкретизации указаний

Преобразуют команду в тактильную

Получает необходимую
информацию, не отвлекаясь на

Замена отвлекающей от дороги карты

на тактильные сигналы
