BananaGithubserfer/velopath/advertising/presentations/VELOPATH (1).pdf

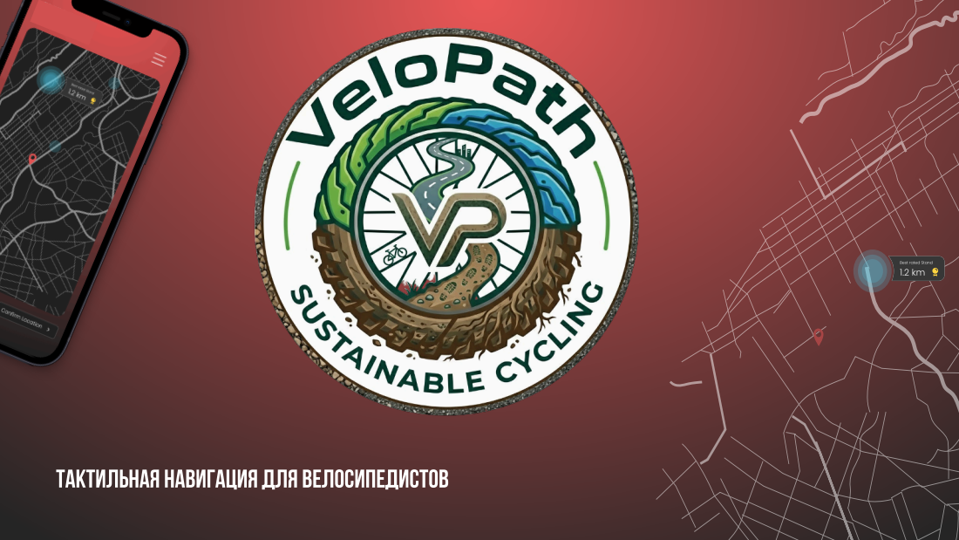
[picture p105: page 1]

Slide Deck Title

Best rated Stand

This is just the beginning of something big.

тактильная навигация для велосипедистов

# Проблематика

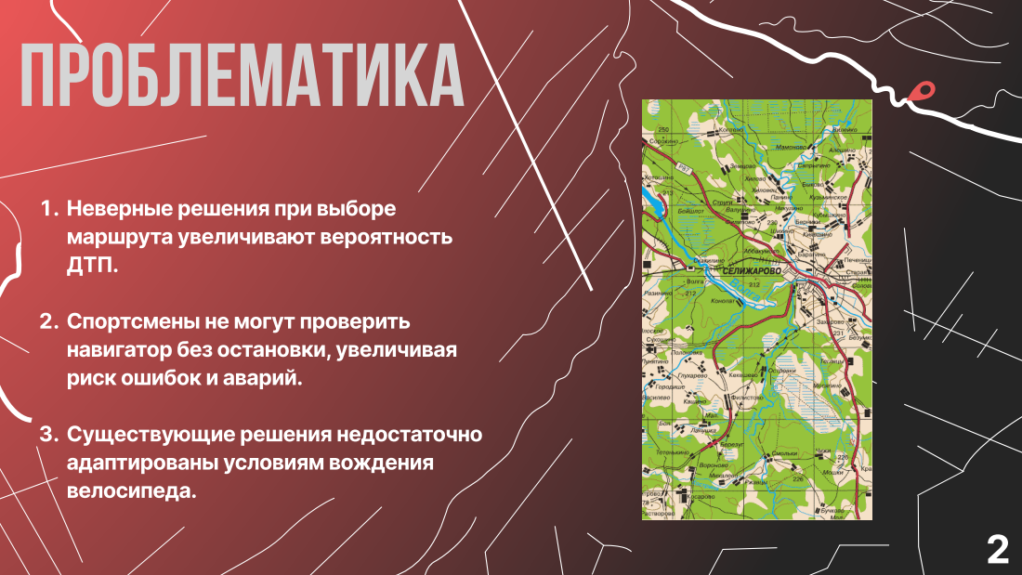
[picture p106: page 2]

Неверные решения при выборе
маршрута увеличивают вероятность
ДТП.
is just the beginninцукцуйацуацйуацуацйауg of something big.
Спортсмены не могут проверить
навигатор без остановки, увеличивая
риск ошибок и аварий.

Существующие решения недостаточно
адаптированы условиям вождения
велосипеда.

# АКТУальность

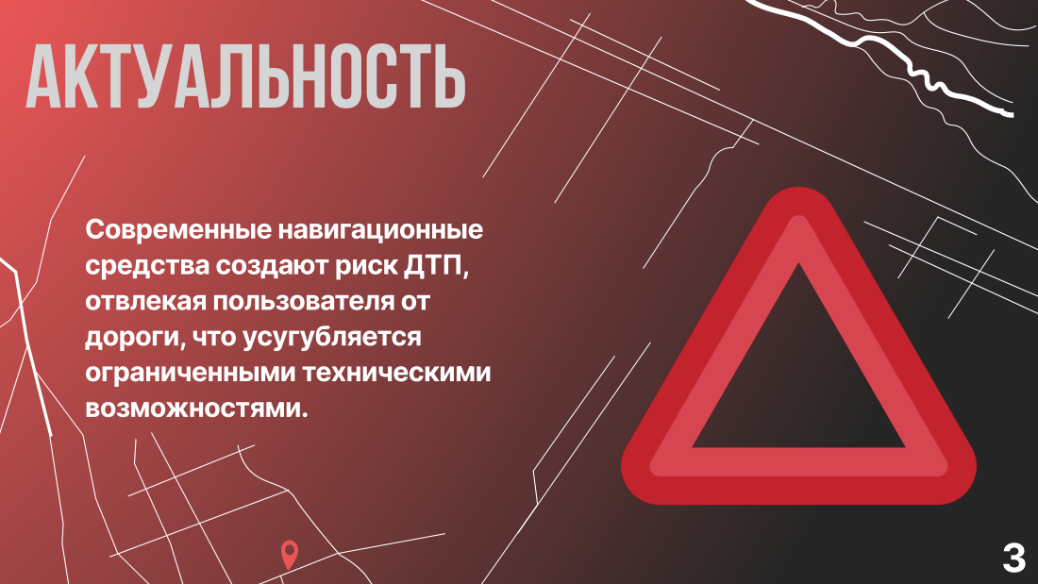
[picture p107: page 3]

Современные навигационные
Slide Deck Title
средства создают риск ДТП,

отвлекая пользователя от
This is just the beginning of something big.
дороги, что усугубляется
ограниченными техническими
возможностями.

# Целевая Аудитория

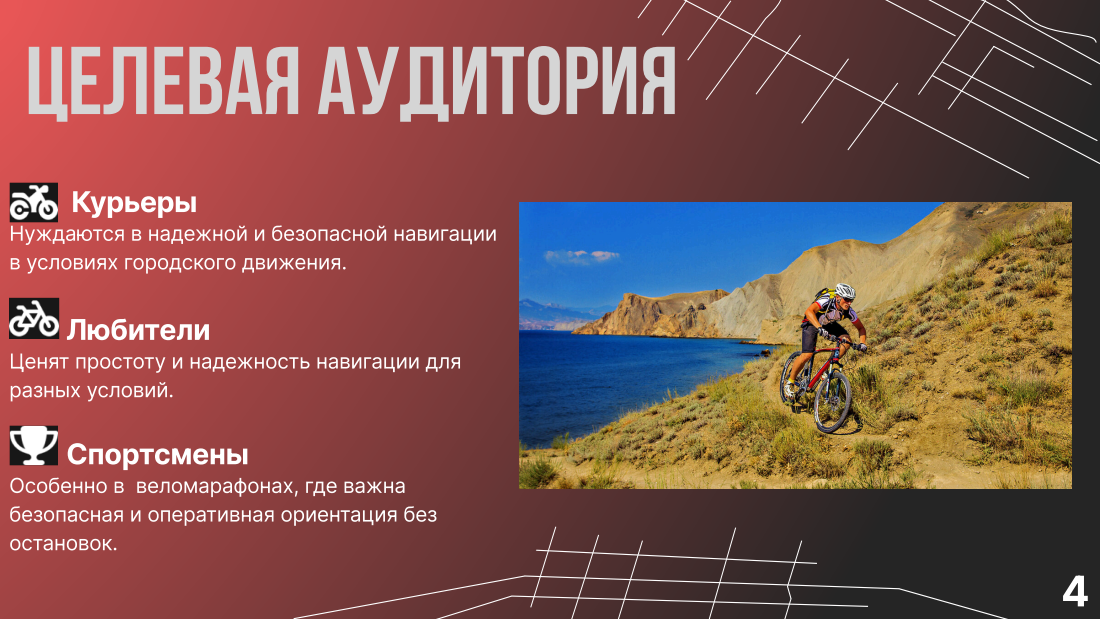
[picture p108: page 4]
Курьеры; разных условий.; Спортсмены; остановок.

Нуждаются в надежной и безопасной навигации
в условиях городского движения.

This is just the beginning of something big.
Любители

Ценят простоту и надежность навигации для

Особенно в веломарафонах, где важна

безопасная и оперативная ориентация без

# концепция

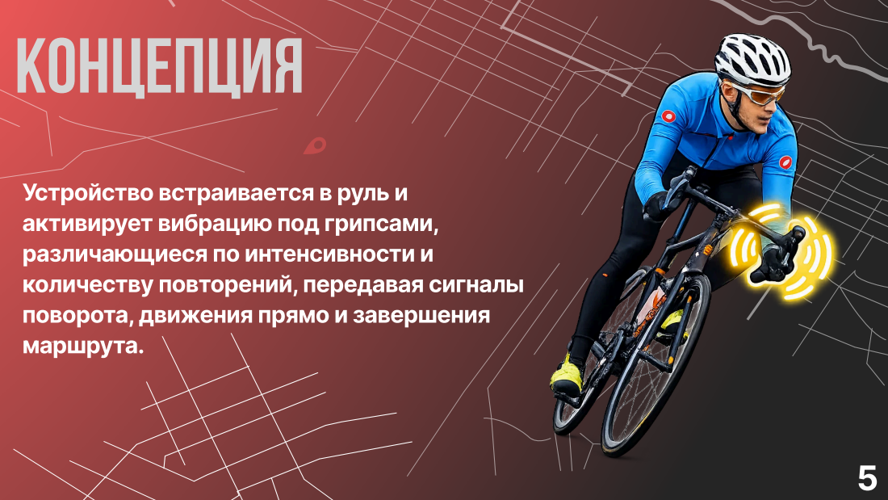
[picture p109: page 5]

Устройство встраивается в руль и
активирует вибрацию под грипсами,
различающиеся по интенсивности и
количеству повторений, передавая сигналы
поворота, движения прямо и завершения
маршрута.

# ЦЕЛЬ

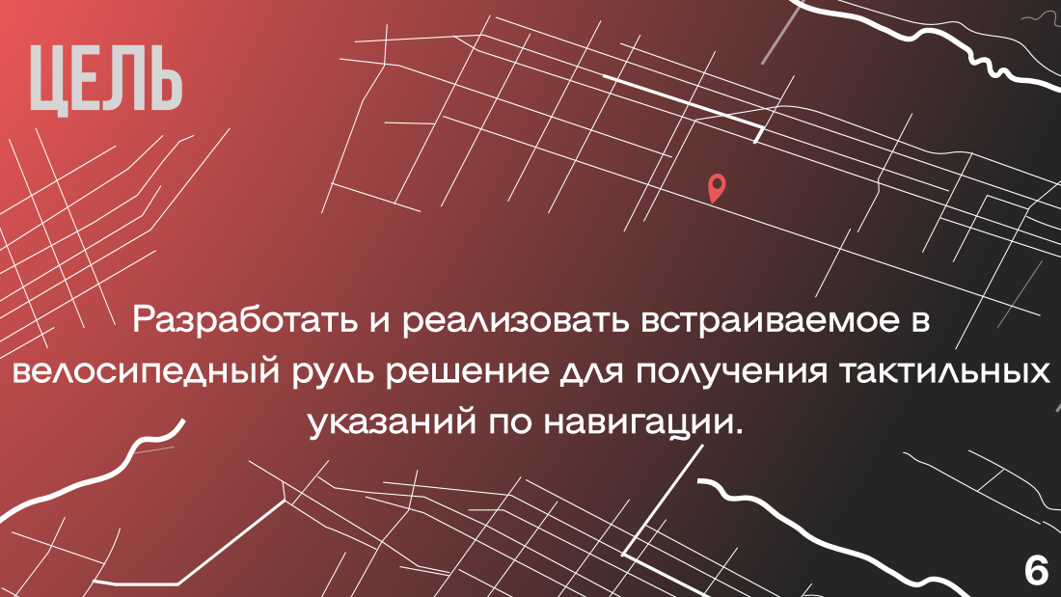
[picture p110: page 6]

Slide Deck Title
Разработать и реализовать встраиваемое в
This is just the beginning of something big.
велосипедный руль решение для получения тактильных

указаний по навигации.

# Задачи

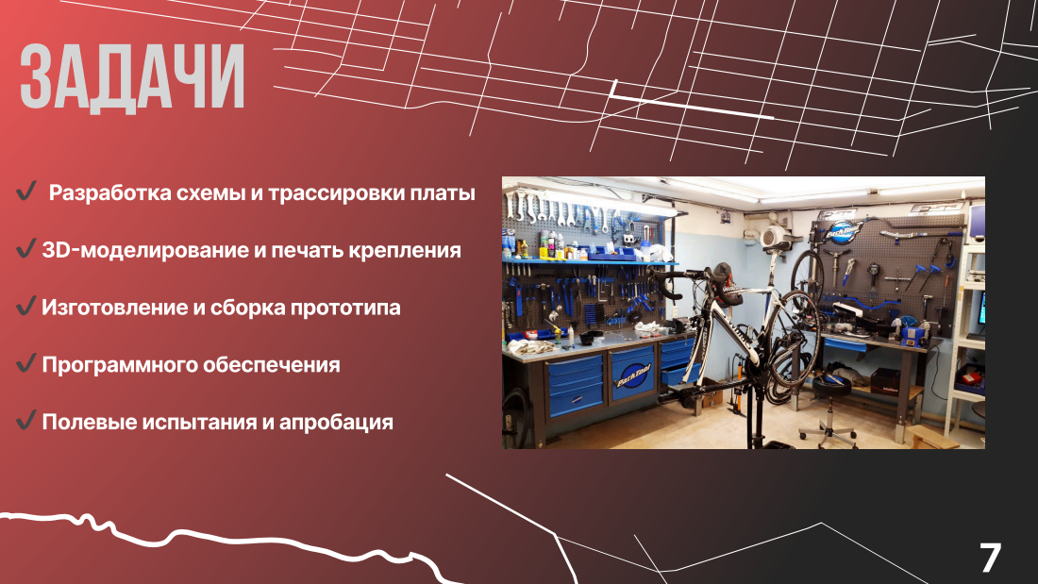
[picture p111: page 7]
✔ Программного обеспечения

✔ Разработка схемы и трассировки платы

✔ 3D-моделирование и печать крепления

✔ Изготовление и сборка прототипа

✔ Полевые испытания и апробация

# Как работает

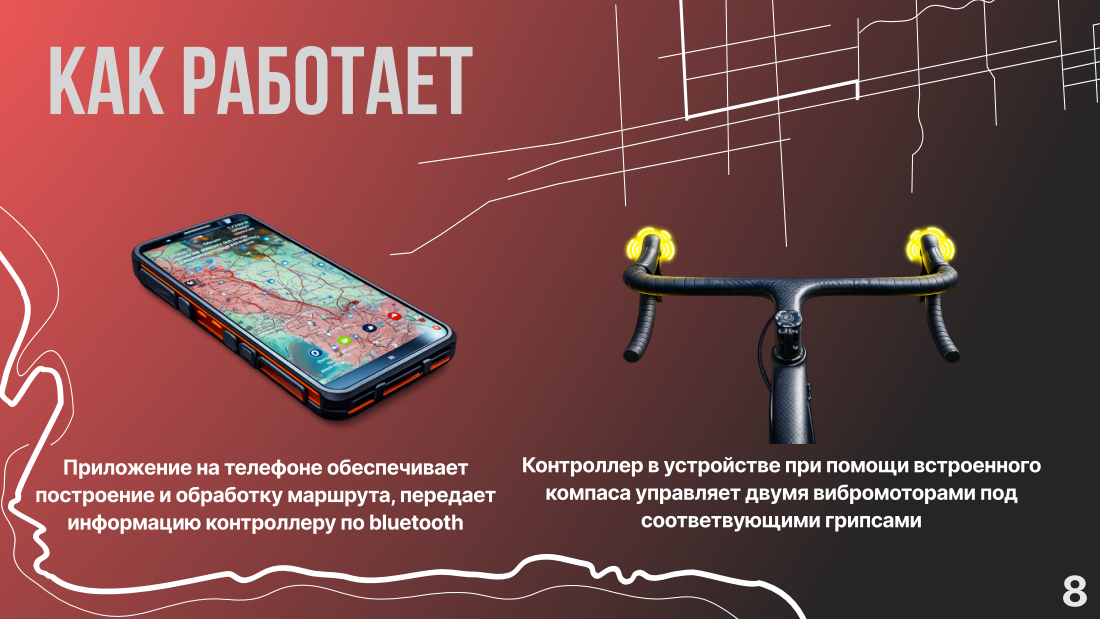
[picture p112: page 8]
соответвующими грипсами

Slide Deck Title

Приложение на телефоне обеспечивает
построение и обработку маршрута, передает
информацию контроллеру по bluetooth

Контроллер в устройстве при помощи встроенного
компаса управляет двумя вибромоторами под

# Азбука сигналов

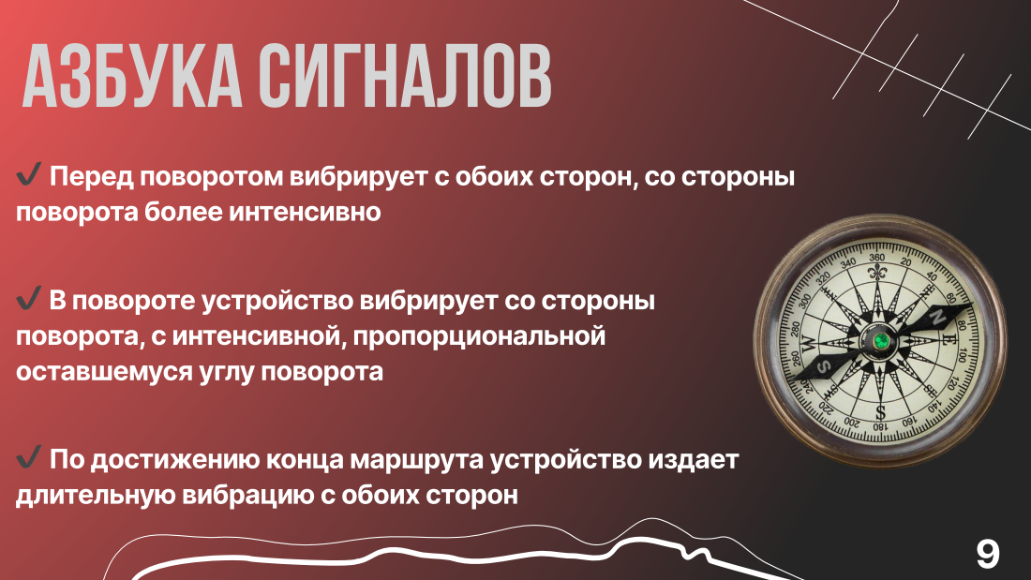
[picture p113: page 9]

✔ Перед поворотом вибрирует с обоих сторон, со стороны

поворота более интенсивно
Slide Deck Title

✔ В повороте устройство вибрирует со стороны

This is just the beginning of something big.

поворота, с интенсивной, пропорциональной

оставшемуся углу поворота

✔ По достижению конца маршрута устройство издает

длительную вибрацию с обоих сторон

# Преимущества velopath

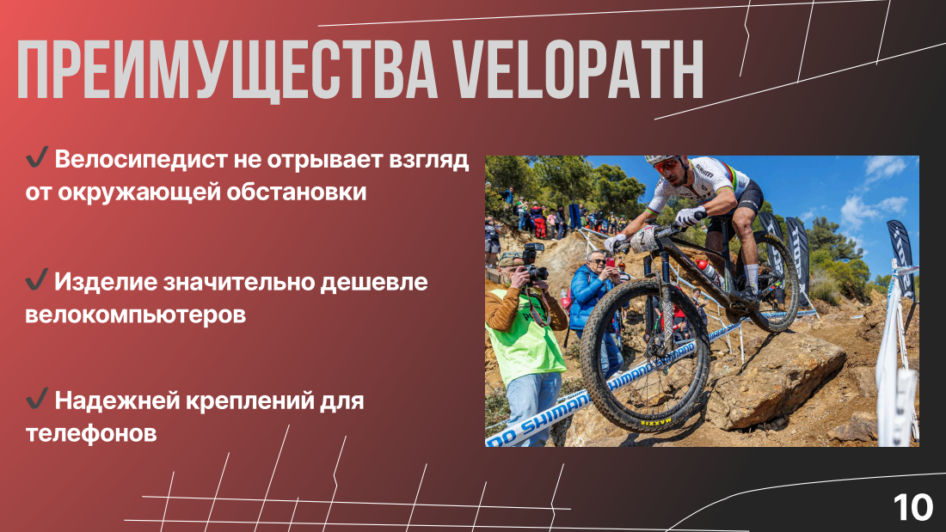
[picture p114: page 10]
телефонов

✔ Велосипедист не отрывает взгляд

от окружающей обстановки
Slide Deck Title

✔ Изделие значительно дешевле

This is just the beginning of something big.
велокомпьютеров

✔ Надежней креплений для

# Компоненты

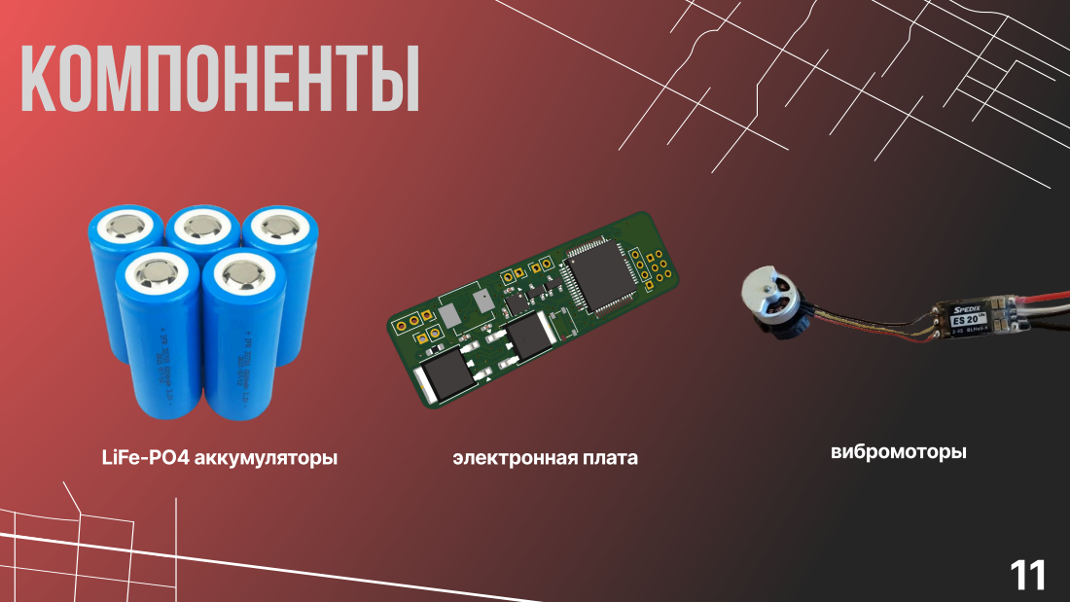
[picture p115: page 11]
LiFe-PO4 аккумуляторы; электронная плата; вибромоторы

Slide Deck Title

This is just the beginning of something big.

## ✔ Разработка схемы и трассировки

# Разработка прототипа

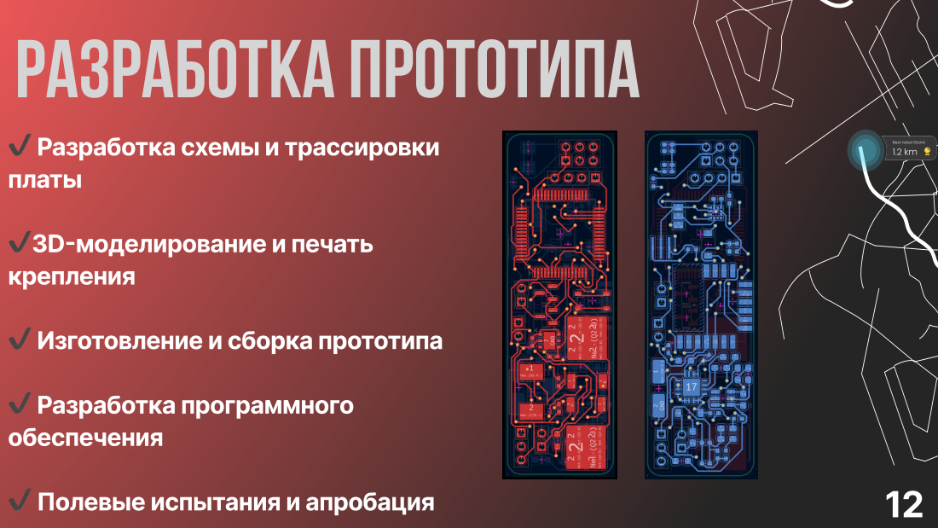
[picture p116: page 12]
✔ Разработка программного; обеспечения

Best rated Stand

платы
Slide Deck Title
✔3D-моделирование и печать
крепления

This is just the beginning of something big.
✔ Изготовление и сборка прототипа

✔ Полевые испытания и апробация

# Реализация продукта

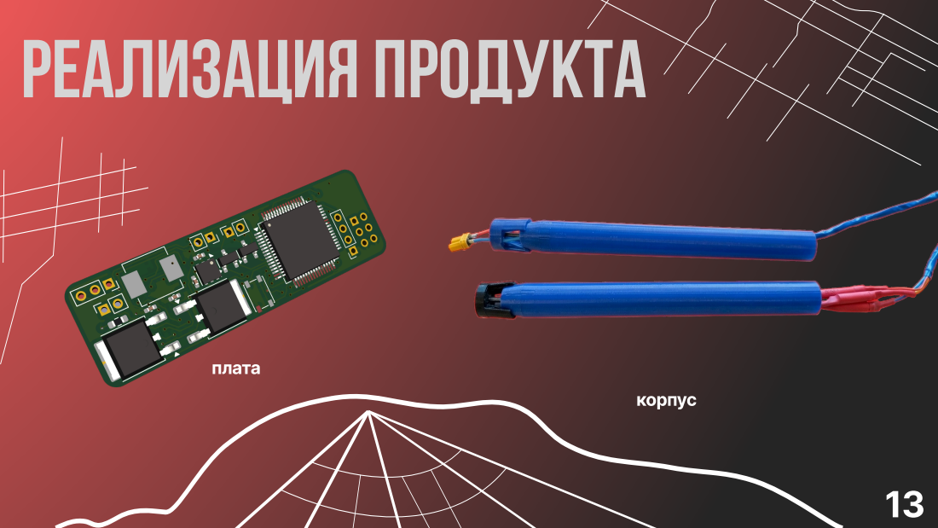
[picture p117: page 13]
плата; корпус

# Перспективы

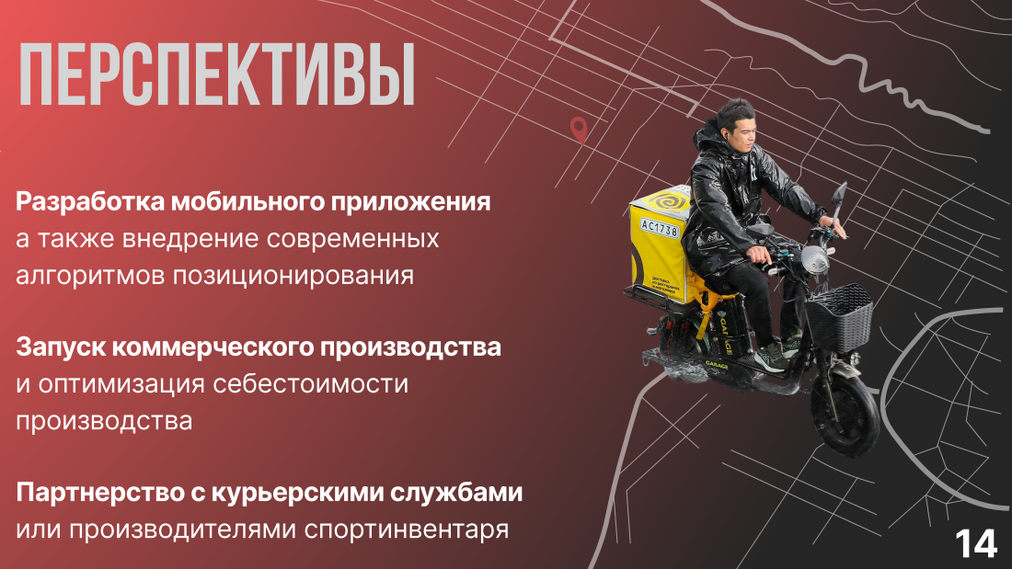
[picture p118: page 14]

Разработка мобильного приложения
а также внедрение современных
алгоритмов позиционирования

This is just the beа также внедрение современных алгоритмов
позиционированияginning of something big.

Запуск коммерческого производства
и оптимизация себестоимости
производства

Партнерство с курьерскими службами
или производителями спортинвентаря

# Перспективы

Разработка мобильного приложения
а также внедрение современных
алгоритмов позиционирования

This is just the beа также внедрение современных алгоритмов
позиционированияginning of something big.

Запуск коммерческого производства
и оптимизация себестоимости
производства

Партнерство с курьерскими службами
или производителями спортинвентаря

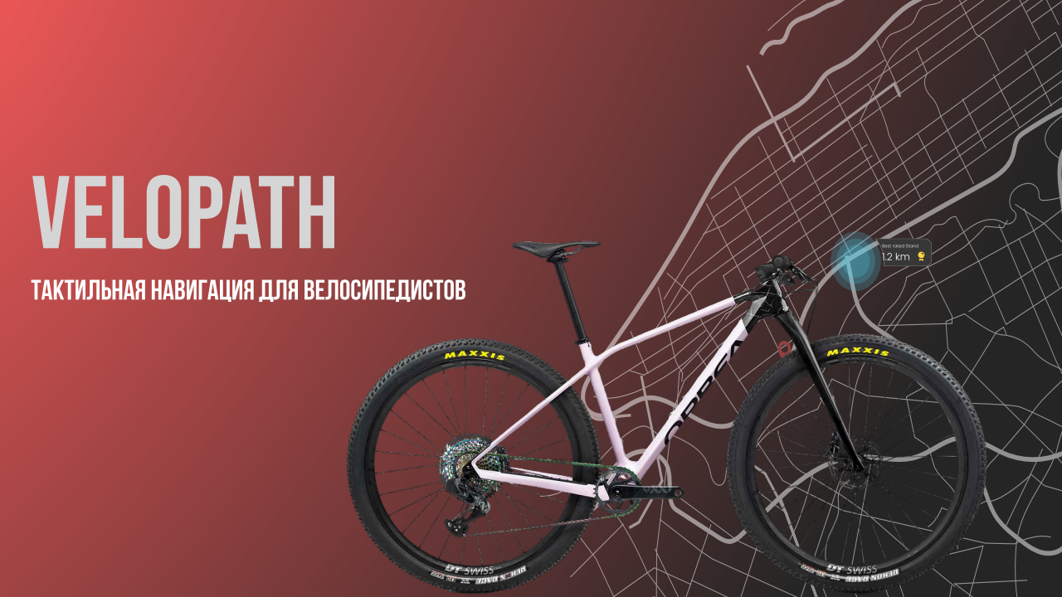
[picture p119: page 16]

VELOPATH Slide Deck Title

Best rated Stand

тактильная навигация для велосипедистов

This is just the beginning of something big.
