BananaGithubserfer/velopath/pcb/velopath_final.kicad_pcb

## KiCad design pcb/velopath_final.kicad_pcb (2026-10-26)

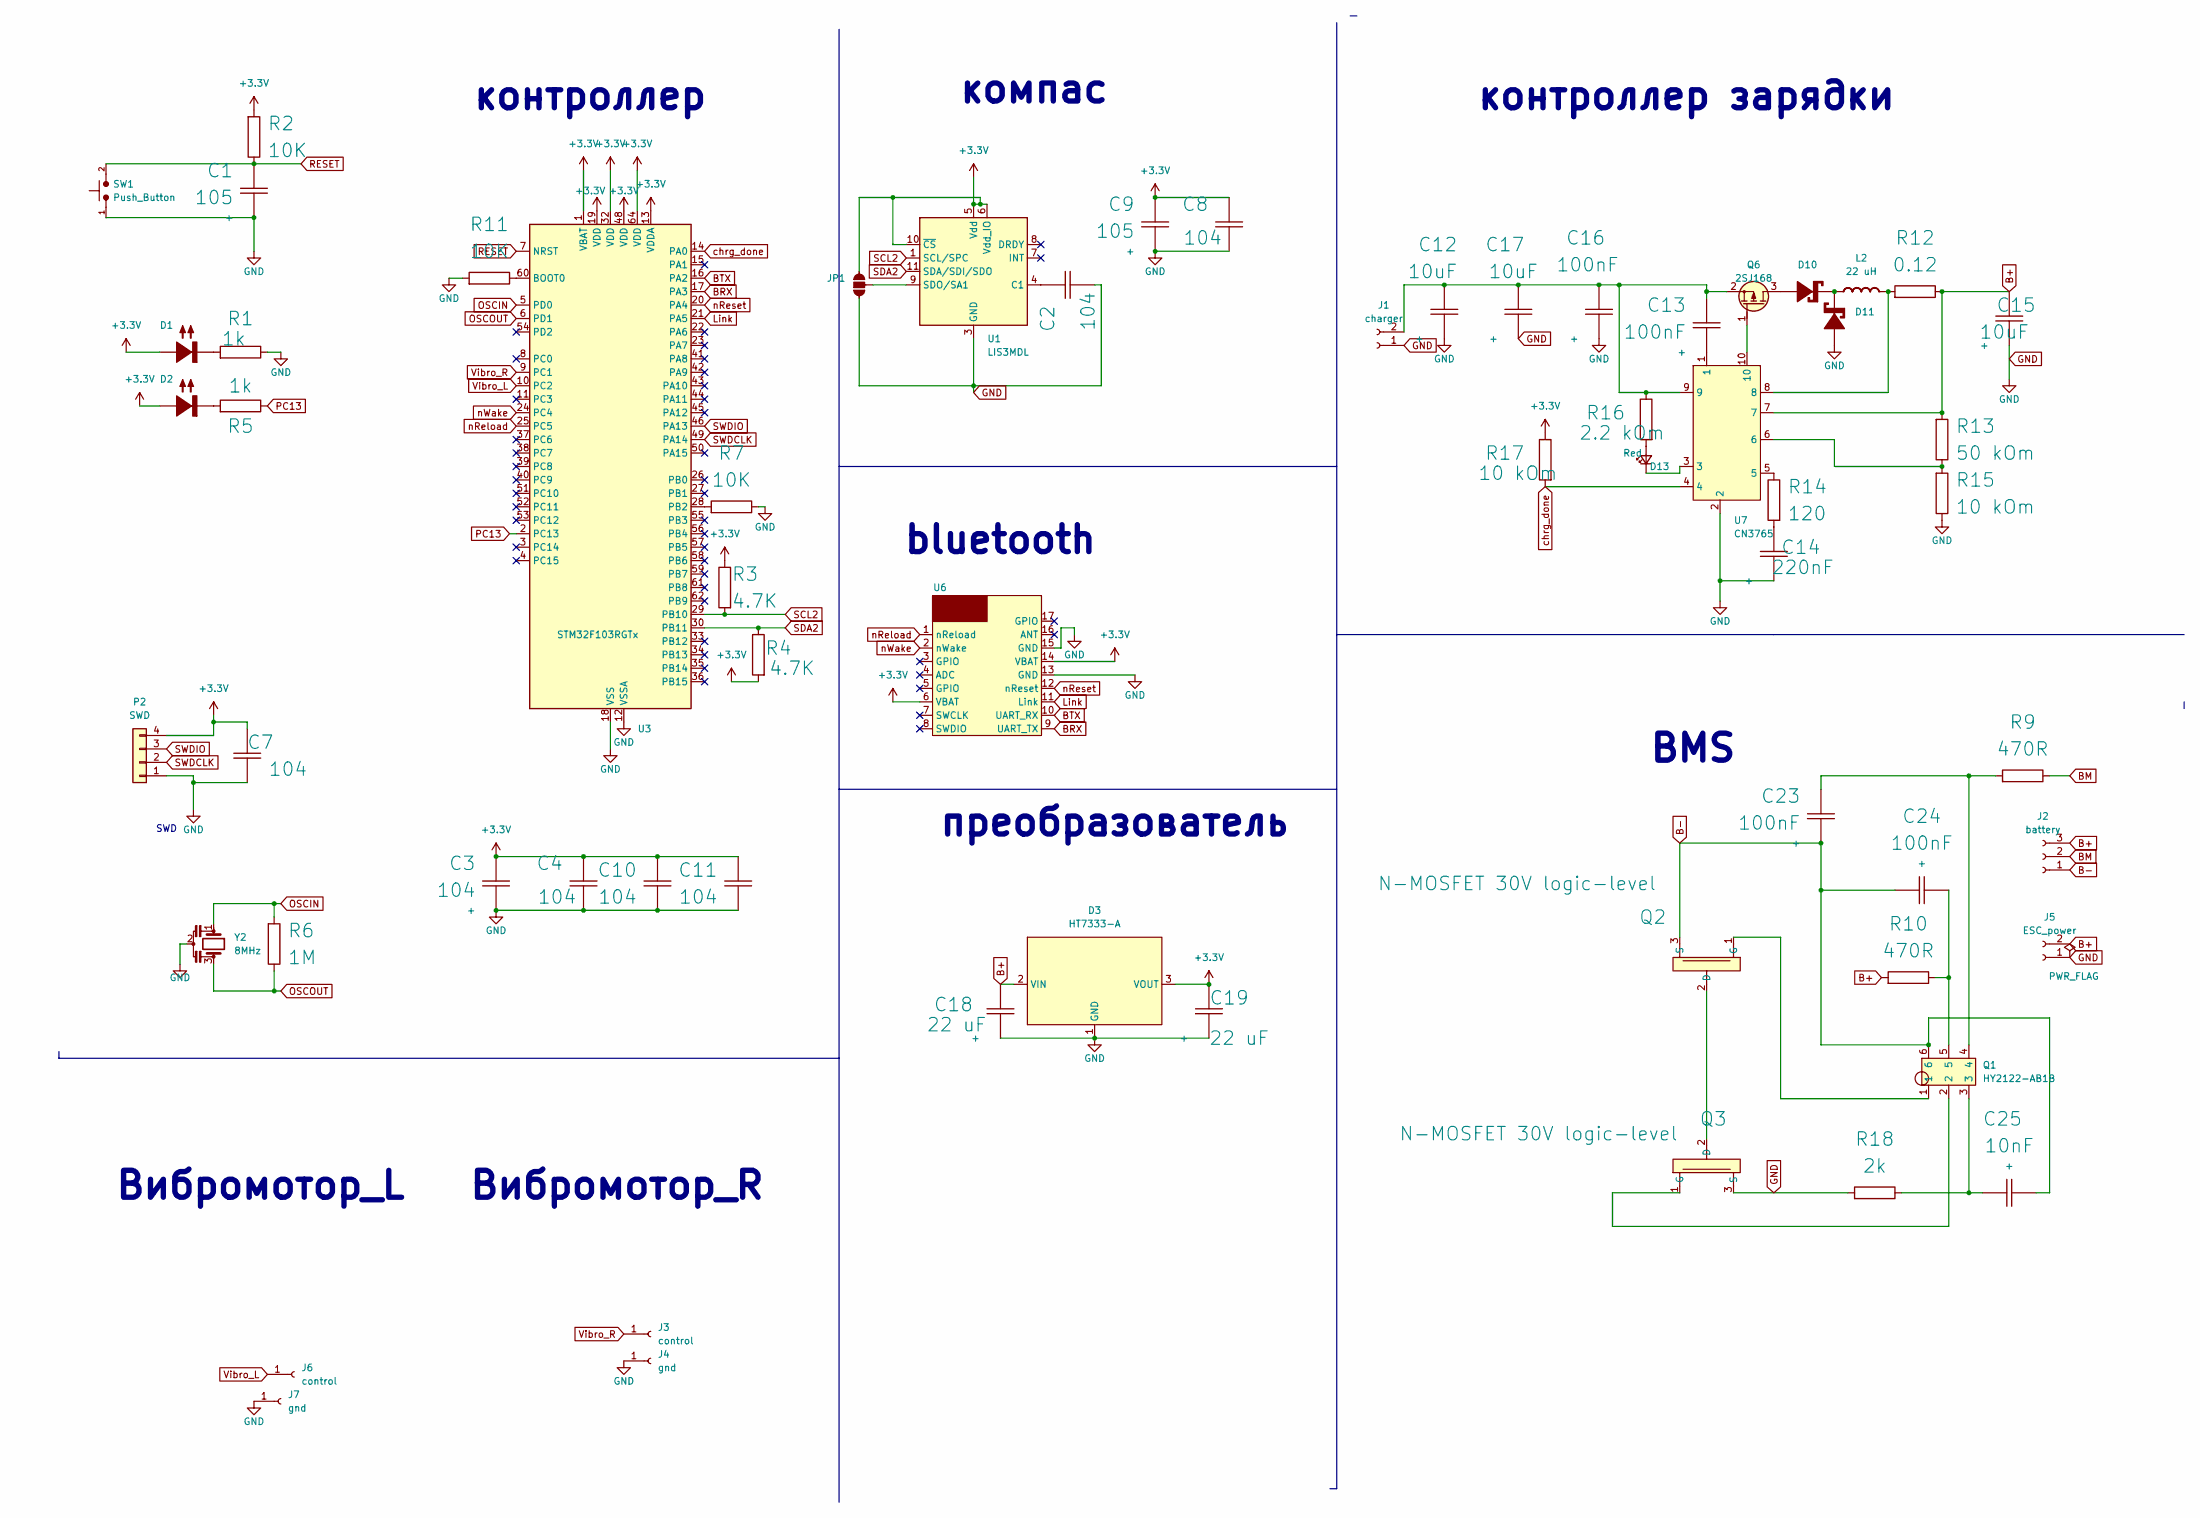
[picture p120: schematic velopath_final.kicad_sch]

Parts:
C1, C9: 105; C_0402_1005Metric_Pad0.74x0.62mm_HandSolder
C2, C3, C4, C7, C8, C10, C11: 104; C_0402_1005Metric_Pad0.74x0.62mm_HandSolder
C12, C15, C17: 10uF; C_0603_1608Metric_Pad1.05x0.95mm_HandSolder
C13, C16: 100nF; C_0402
C14: 220nF; C_0402
C18, C19: 22 uF; C_0402_1005Metric_Pad0.74x0.62mm_HandSolder
C23: 100nF; C_0603
C24: 100nF; C_0603_1608Metric_Pad1.08x0.95mm_HandSolder
C25: 10nF; C_0603_1608Metric_Pad1.08x0.95mm_HandSolder
D1, D2: LED_0603_1608Metric_Pad1.05x0.95mm_HandSolder; Rating A
D3: HT7333-A; SOT-89-3_Handsoldering
D10, D11: SOD-123; Rating V/A
D13: Red; LED_0603_1608Metric
J1: charger; Socket_1x02_2.54mm_TH
J2: battery; PinSocket_1x03_P2.54mm_Vertical
J3, J6: control; 1x01_P2.0mm
J4, J7: gnd; 1x01_P2.0mm
J5: ESC_power; Socket_1x02_2.54mm_TH
JP1: SolderJumper-3_P1.3mm_Open_Pad1.0x1.5mm
L2: 22 uH; L_Vishay_IHLP-2525; Rating A
P2: SWD; PinSocket_1x04_P2.00mm_Vertical; Part Number 1-0401FBV0T
Q1: HY2122-AB1B; TSOT-23-6
Q2, Q3: N-MOSFET 30V logic-level; TO-252-2
Q6: 2SJ168; SC-59
R1, R5: 1k; R_0402_1005Metric_Pad0.72x0.64mm_HandSolder
R2, R7, R11: 10K; R_0402_1005Metric_Pad0.72x0.64mm_HandSolder
R3, R4: 4.7K; R_0402_1005Metric_Pad0.72x0.64mm_HandSolder
R6: 1M; R_0402_1005Metric_Pad0.72x0.64mm_HandSolder
R9, R10: 470R; R_0603_1608Metric_Pad0.98x0.95mm_HandSolder
R12: 0.12; R_0402
R13: 50 kOm; R_0402
R14: 120; R_0402
R15: 10 kOm; R_0402
R16: 2.2 kOm; R_0402
R17: 10 kOm; R_0402_1005Metric_Pad0.72x0.64mm_HandSolder
R18: 2k; R_0603_1608Metric_Pad0.98x0.95mm_HandSolder
SW1: Push_Button; SW_SPST_PTS810
U1: LIS3MDL; LGA-12_2x2mm_P0.5mm
U3: STM32F103RGTx; LQFP-64_10x10mm_P0.5mm
U6: WH-BLE106
U7: CN3765; SSOP-10_3.9x4.9mm_P1.00mm
Y2: 8MHz; Resonator_SMD_Murata_CSTxExxV-3Pin_3.0x1.1mm_HandSoldering

Connections:
+3.3V: C3.1 (+), C4.1 (+), C7.1 (+), C8.1 (+), C9.1 (+), C10.1 (+), C11.1 (+), C19.1 (+), D1.2 (A+), D2.2 (A+), D3.3 (VOUT), JP1.3 (C), P2.4, R2.1 (+), R3.2 (-), R4.1 (+), R17.2 (-), U1.5 (Vdd), U1.6 (Vdd_IO), U1.10 (~CS), U3.1 (VBAT), U3.13 (VDDA), U3.19 (VDD), U3.32 (VDD), U3.48 (VDD), U3.64 (VDD), U6.6 (VBAT), U6.14 (VBAT)
B+: C15.1 (+), C18.1 (+), D3.2 (VIN), J2.3, J5.2, R10.1 (+), R12.2 (-), R13.1 (+), U7.7
B-: C23.1 (+), C24.1 (+), C25.2 (-), J2.1, Q1.6, Q2.3 (S)
BM: J2.2, R9.2 (-)
BRX: U3.17 (PA3), U6.9 (UART_TX)
BTX: U3.16 (PA2), U6.10 (UART_RX)
GND: C1.2 (-), C2.2 (-), C3.2 (-), C4.2 (-), C7.2 (-), C8.2 (-), C9.2 (-), C10.2 (-), C11.2 (-), C12.2 (-), C14.1 (+), C15.2 (-), C16.2 (-), C17.2 (-), C18.2 (-), C19.2 (-), D3.1 (GND), D11.2 (A+), J1.1, J4.1 (Pin_1_1), J5.1, J7.1 (Pin_1_1), JP1.1 (A), P2.1, Q3.3 (S), R1.2 (-), R7.2 (-), R11.1 (+), R15.2 (-), R18.1 (+), SW1.1, U1.2 (GND), U1.3 (GND), U1.12 (GND), U3.12 (VSSA), U3.18 (VSS), U3.31 (VSS), U3.47 (VSS), U3.63 (VSS), U6.13 (GND), U6.15 (GND), U7.2, Y2.2
Link: U3.21 (PA5), U6.11 (Link)
unnamed: C2.1 (+), U1.4 (C1)
unnamed: C12.1 (+), C13.1 (+), C16.1 (+), C17.1 (+), J1.2, Q6.2 (S), R16.2 (-), U7.9
unnamed: C13.2 (-), U7.1
unnamed: C14.2 (-), R14.1 (+)
unnamed: C23.2 (-), Q1.4, R9.1 (+)
unnamed: C24.2 (-), Q1.5, R10.2 (-)
unnamed: C25.1 (+), Q1.3, R18.2 (-)
unnamed: D1.1 (K-), R1.1 (+)
unnamed: D2.1 (K-), R5.1 (+)
unnamed: D10.2 (A+), Q6.3 (D)
unnamed: D10.1 (K-), D11.1 (K-), L2.1 (+)
unnamed: D13.2 (A), R16.1 (+)
unnamed: D13.1 (K), U7.3
unnamed: JP1.2 (B), U1.9 (SDO/SA1)
unnamed: L2.2 (-), R12.1 (+), U7.8
unnamed: Q2.2 (D), Q3.2 (D)
unnamed: Q1.1, Q2.1 (G)
unnamed: Q1.2, Q3.1 (G)
unnamed: Q6.1 (G), U7.10
unnamed: R7.1 (+), U3.28 (PB2)
unnamed: R11.2 (-), U3.60 (BOOT0)
unnamed: R13.2 (-), R15.1 (+), U7.6
unnamed: R14.2 (-), U7.5
OSCIN: R6.1 (+), U3.5 (PD0), Y2.1
OSCOUT: R6.2 (-), U3.6 (PD1), Y2.3
PC13: R5.2 (-), U3.2 (PC13)
RESET: C1.1 (+), R2.2 (-), SW1.2, U3.7 (NRST)
SCL2: R3.1 (+), U1.1 (SCL/SPC), U3.29 (PB10)
SDA2: R4.2 (-), U1.11 (SDA/SDI/SDO), U3.30 (PB11)
SWDCLK: P2.2, U3.49 (PA14)
SWDIO: P2.3, U3.46 (PA13)
Vibro_L: J6.1 (Pin_1_1), U3.10 (PC2)
Vibro_R: J3.1 (Pin_1_1), U3.9 (PC1)
chrg_done: R17.1 (+), U3.14 (PA0), U7.4
nReload: U3.25 (PC5), U6.1 (nReload)
nReset: U3.20 (PA4), U6.12 (nReset)
nWake: U3.24 (PC4), U6.2 (nWake)

Notes on the sheet:
Вибромотор_R
bluetooth
контроллер зарядки
преобразователь
SWD
контроллер
компас
BMS
Вибромотор_L

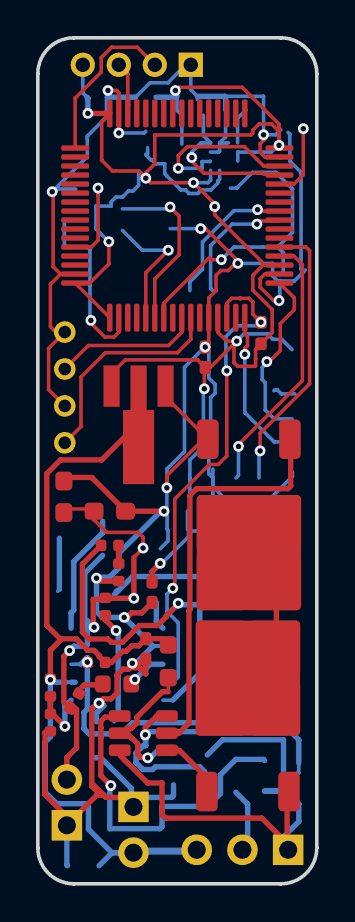
[picture p121: board pcb/velopath_final.kicad_pcb from above]

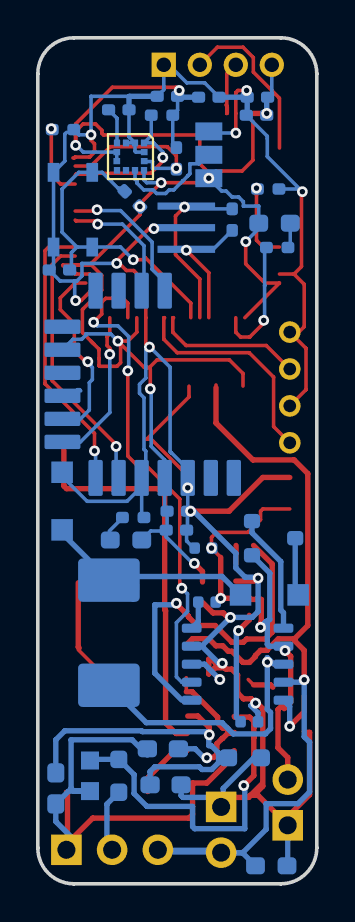
[picture p122: board pcb/velopath_final.kicad_pcb from below]

Board: 2 copper layers, 15.5 x 47.0 mm, 63 parts (36 on the bottom side), 45 nets.
