BananaGithubserfer/velopath/pcb/velopath_meta/velopath_final08/velopath_final.kicad_pcb

## KiCad design pcb/velopath_meta/velopath_final08/velopath_final.kicad_pcb (2026-08-09, an earlier design)

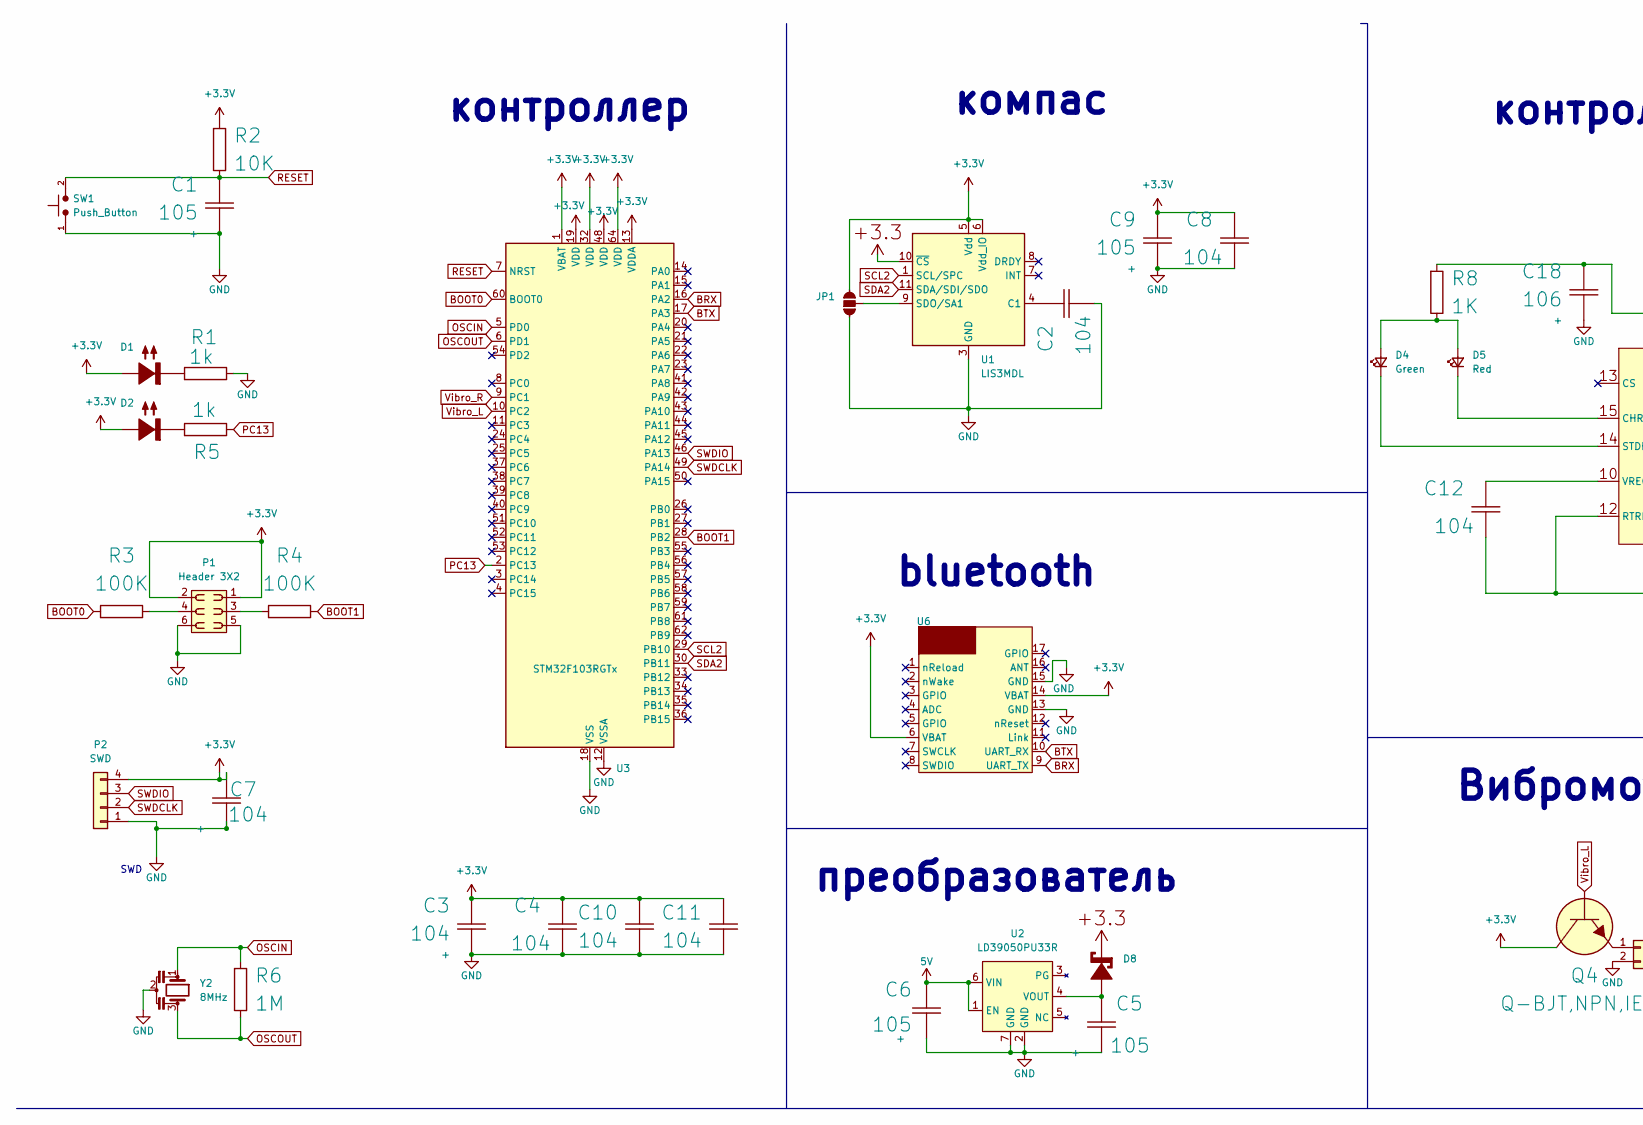
[picture p123: schematic velopath_final.kicad_sch, part in row 1, column 1]

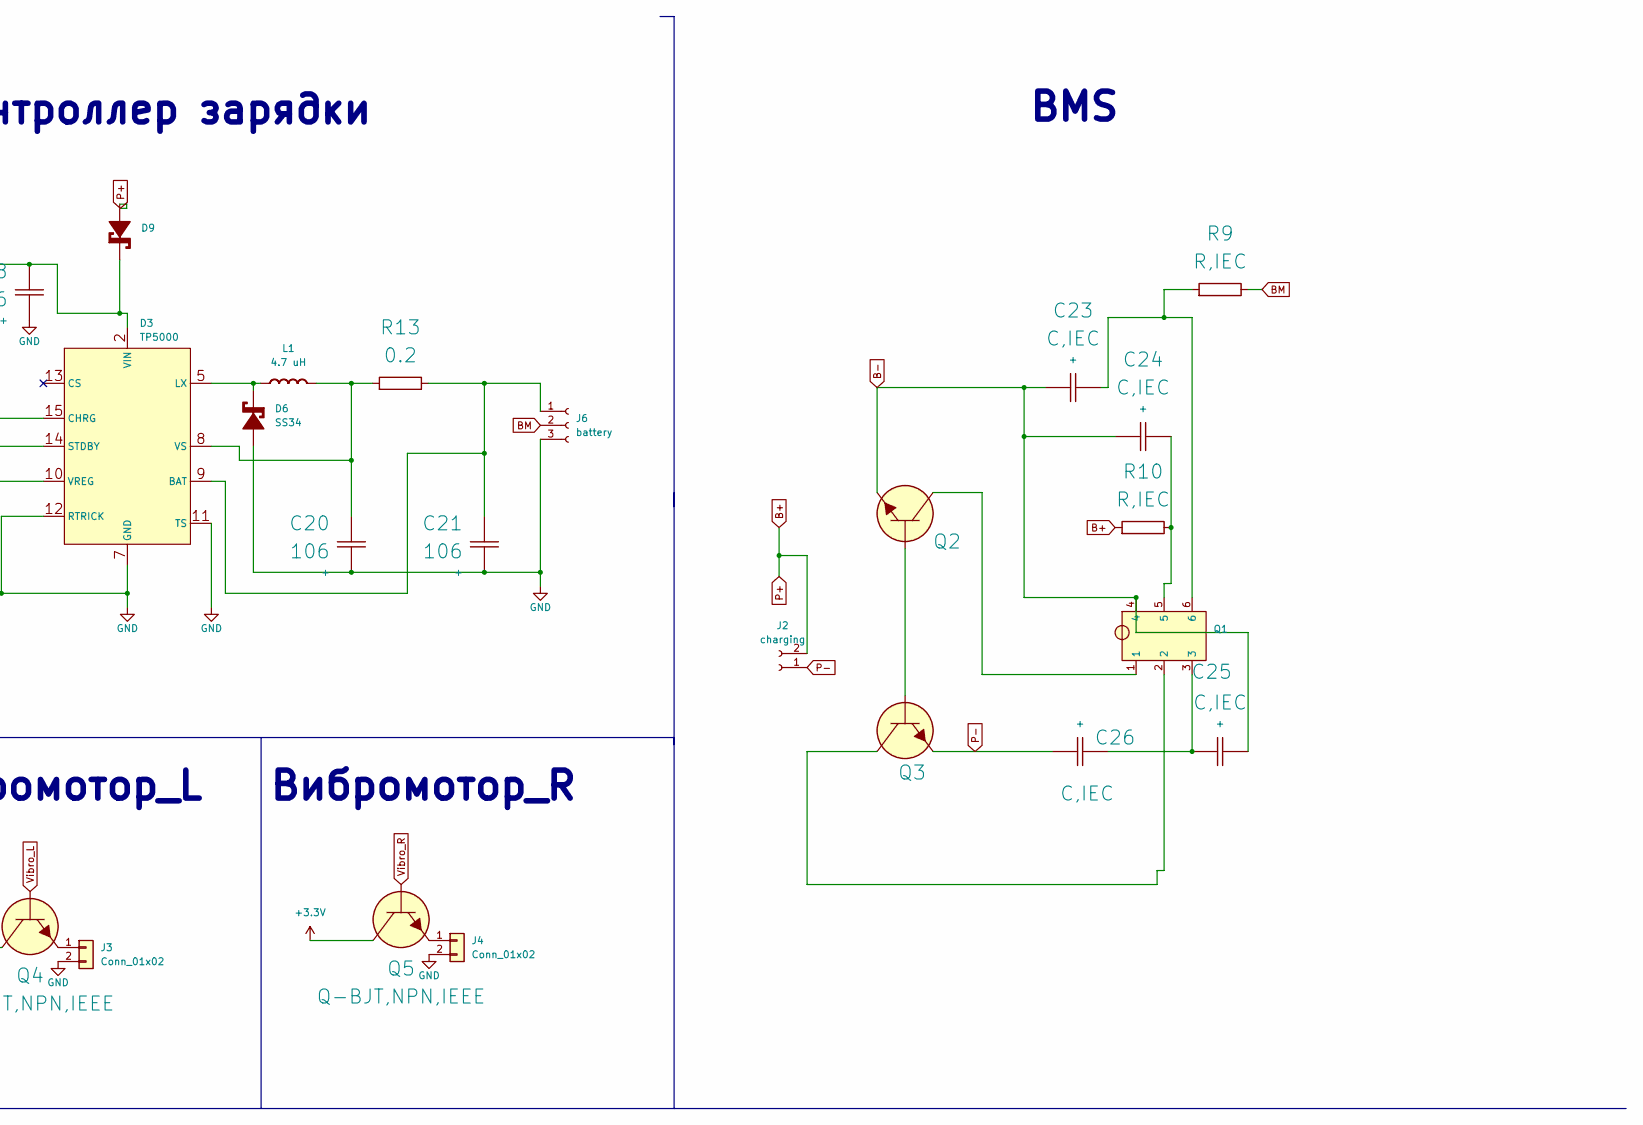
[picture p124: schematic velopath_final.kicad_sch, part in row 1, column 2]

Parts:
C1, C5, C6, C9: 105; C_0402_1005Metric_Pad0.74x0.62mm_HandSolder
C2, C3, C4, C7, C8, C10, C11, C12: 104; C_0402_1005Metric_Pad0.74x0.62mm_HandSolder
C18, C20, C21: 106; C_0402_1005Metric_Pad0.74x0.62mm_HandSolder
C23, C24, C25, C26: C,IEC; C_0603_1608Metric_Pad1.08x0.95mm_HandSolder
D1, D2: LED_0603_1608Metric_Pad1.05x0.95mm_HandSolder; Rating A
D3: TP5000; QFN-16-1EP_4x4mm_P0.65mm_EP2.5x2.5mm
D4: Green; LED_0603_1608Metric_Pad1.05x0.95mm_HandSolder
D5: Red; LED_0603_1608Metric_Pad1.05x0.95mm_HandSolder
D6: SS34; D_SMA_Handsoldering; Rating V/A
D8, D9: D_SOD-123; Rating V/A
J2: charging; PinSocket_1x02_P2.00mm_Vertical
J3, J4: Conn_01x02; PinSocket_1x02_P2.00mm_Vertical; Part Number 1-0201FBV0T
J6: battery; PinSocket_1x03_P2.00mm_Vertical
JP1: SolderJumper-3_P1.3mm_Open_Pad1.0x1.5mm
L1: 4.7 uH; L_Vishay_IHLP-2525; Rating A
P1: Header 3X2; PinSocket_2x03_P2.00mm_Vertical
P2: SWD; PinSocket_1x04_P2.00mm_Vertical; Part Number 1-0401FBV0T
Q1: SOT-23-6
Q2, Q3: TO-252-2
Q4, Q5: Q-BJT,NPN,IEEE; SOT-23
R1, R5: 1k; R_0402_1005Metric_Pad0.72x0.64mm_HandSolder
R2: 10K; R_0402_1005Metric_Pad0.72x0.64mm_HandSolder
R3, R4: 100K; R_0402_1005Metric_Pad0.72x0.64mm_HandSolder
R6: 1M; R_0402_1005Metric_Pad0.72x0.64mm_HandSolder
R8: 1K; R_0402_1005Metric_Pad0.72x0.64mm_HandSolder
R9, R10: R,IEC; R_0603_1608Metric_Pad0.98x0.95mm_HandSolder
R13: 0.2; R_0603_1608Metric_Pad0.98x0.95mm_HandSolder
SW1: Push_Button; SW_SPST_PTS810
U1: LIS3MDL; LGA-12_2x2mm_P0.5mm
U2: LD39050PU33R; DFN-6-1EP_3x3mm_P0.95mm_EP1.7x2.6mm
U3: STM32F103RGTx; LQFP-64_10x10mm_P0.5mm
U6: WH-BLE106
Y2: 8MHz; Resonator_SMD_Murata_CSTxExxV-3Pin_3.0x1.1mm_HandSoldering

Connections:
5V: C6.1 (+), U2.1 (EN), U2.6 (VIN)
+3.3V: C3.1 (+), C4.1 (+), C7.1 (+), C8.1 (+), C9.1 (+), C10.1 (+), C11.1 (+), D1.2 (A+), D2.2 (A+), JP1.3 (C), P1.1, P1.2, P2.4, Q4.1 (C), Q5.1 (C), R2.1 (+), U1.5 (Vdd), U1.6 (Vdd_IO), U3.1 (VBAT), U3.13 (VDDA), U3.19 (VDD), U3.32 (VDD), U3.48 (VDD), U3.64 (VDD), U6.6 (VBAT), U6.14 (VBAT)
B+: D9.2 (A+), J2.2, R10.1 (+)
B-: C23.1 (+), C24.1 (+), C25.2 (-), Q1.4, Q2.3 (E)
BM: J6.2, R9.2 (-)
BOOT0: R3.1 (+), U3.60 (BOOT0)
BOOT1: R4.2 (-), U3.28 (PB2)
BRX: U3.16 (PA2), U6.9 (UART_TX)
BTX: U3.17 (PA3), U6.10 (UART_RX)
GND: C1.2 (-), C2.2 (-), C3.2 (-), C4.2 (-), C5.2 (-), C6.2 (-), C7.2 (-), C8.2 (-), C9.2 (-), C10.2 (-), C11.2 (-), C12.2 (-), C18.2 (-), C20.2 (-), C21.2 (-), D3.6 (GND), D3.7 (GND), D3.11 (TS), D3.12 (RTRICK), D6.2 (A+), J3.2, J4.2, J6.3, JP1.1 (A), P1.5, P1.6, P2.1, R1.2 (-), SW1.1, U1.2 (GND), U1.3 (GND), U1.12 (GND), U2.2 (GND), U2.7 (GND), U3.12 (VSSA), U3.18 (VSS), U3.31 (VSS), U3.47 (VSS), U3.63 (VSS), U6.13 (GND), U6.15 (GND), Y2.2
unnamed: C2.1 (+), U1.4 (C1)
unnamed: C5.1 (+), D8.2 (A+), U2.4 (VOUT)
unnamed: C12.1 (+), D3.10 (VREG)
unnamed: C18.1 (+), D3.1 (VIN), D3.2 (VIN), D3.16 (VIN), D9.1 (K-), R8.1 (+)
unnamed: C20.1 (+), D3.8 (VS), L1.2 (-), R13.1 (+)
unnamed: C21.1 (+), D3.9 (BAT), J6.1, R13.2 (-)
unnamed: C23.2 (-), Q1.6, R9.1 (+)
unnamed: C24.2 (-), Q1.5, R10.2 (-)
unnamed: C25.1 (+), C26.2 (-), Q1.3
unnamed: D1.1 (K-), R1.1 (+)
unnamed: D2.1 (K-), R5.1 (+)
unnamed: D3.15 (CHRG), D5.1 (K)
unnamed: D3.14 (STDBY), D4.1 (K)
unnamed: D4.2 (A), D5.2 (A), R8.2 (-)
unnamed: D3.3 (LX), D3.4 (LX), D3.5 (LX), D6.1 (K-), L1.1 (+)
unnamed: J3.1, Q4.3 (E)
unnamed: J4.1, Q5.3 (E)
unnamed: JP1.2 (B), U1.9 (SDO/SA1)
unnamed: Q2.2 (B), Q3.2 (B)
unnamed: Q1.1, Q2.1 (C)
unnamed: Q1.2, Q3.1 (C)
unnamed: P1.4, R3.2 (-)
unnamed: P1.3, R4.1 (+)
OSCIN: R6.1 (+), U3.5 (PD0), Y2.1
OSCOUT: R6.2 (-), U3.6 (PD1), Y2.3
P,+3.3: D8.1 (K-), U1.10 (~CS)
P-: C26.1 (+), J2.1, Q3.3 (E)
PC13: R5.2 (-), U3.2 (PC13)
RESET: C1.1 (+), R2.2 (-), SW1.2, U3.7 (NRST)
SCL2: U1.1 (SCL/SPC), U3.29 (PB10)
SDA2: U1.11 (SDA/SDI/SDO), U3.30 (PB11)
SWDCLK: P2.2, U3.49 (PA14)
SWDIO: P2.3, U3.46 (PA13)
Vibro_L: Q4.2 (B), U3.10 (PC2)
Vibro_R: Q5.2 (B), U3.9 (PC1)

Notes on the sheet:
bluetooth
контроллер зарядки
преобразователь
Вибромотор_L
SWD
контроллер
компас
BMS
Вибромотор_R

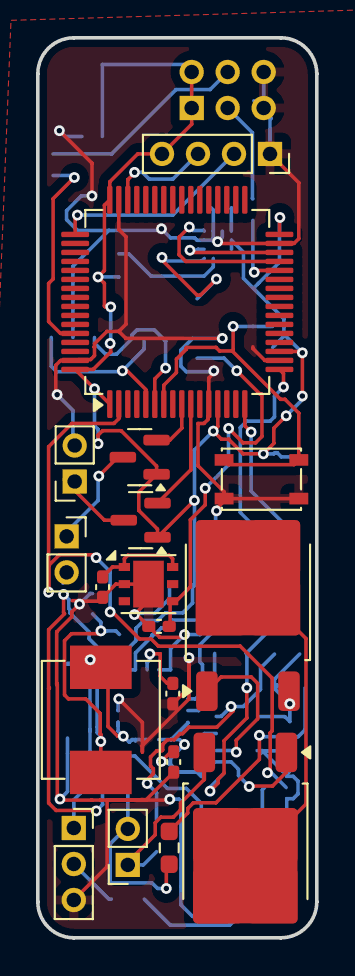
[picture p125: board pcb/velopath_meta/velopath_final08/velopath_final.kicad_pcb from above]

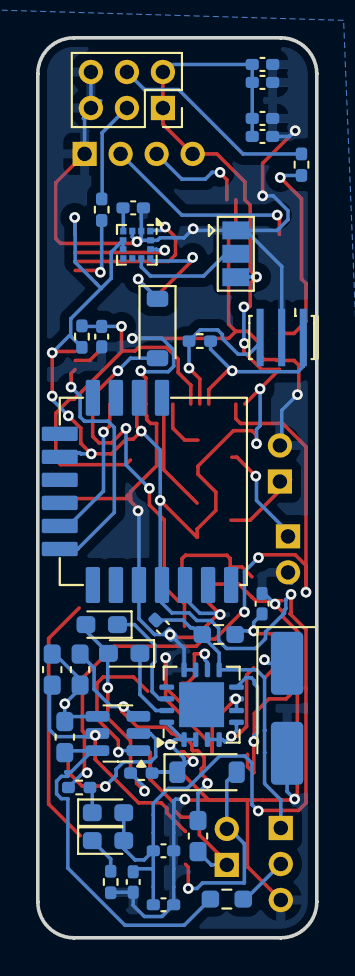
[picture p126: board pcb/velopath_meta/velopath_final08/velopath_final.kicad_pcb from below]

Board: 2 copper layers, 15.5 x 50.0 mm, 56 parts (38 on the bottom side), 45 nets.
