BananaGithubserfer/velopath/app/velopath3_project/firmware/Core/Inc/board_config.h

#ifndef BOARD_CONFIG_H
#define BOARD_CONFIG_H

#include "main.h"
#include "i2c.h"
#include "usart.h"

#define BLE_UART_HANDLE huart2
#define COMPASS_I2C_HANDLE hi2c2

#define LEFT_MOTOR_GPIO_PORT LEFT_MOTOR_GPIO_Port
#define LEFT_MOTOR_GPIO_PIN LEFT_MOTOR_Pin

#define RIGHT_MOTOR_GPIO_PORT RIGHT_MOTOR_GPIO_Port
#define RIGHT_MOTOR_GPIO_PIN RIGHT_MOTOR_Pin

#define LEFT_MOTOR_ACTIVE_STATE GPIO_PIN_RESET
#define LEFT_MOTOR_INACTIVE_STATE GPIO_PIN_SET

#define RIGHT_MOTOR_ACTIVE_STATE GPIO_PIN_SET
#define RIGHT_MOTOR_INACTIVE_STATE GPIO_PIN_RESET

#define ESC_GPIO_PORT RIGHT_MOTOR_GPIO_PORT
#define ESC_GPIO_PIN RIGHT_MOTOR_GPIO_PIN
#define ESC_ACTIVE_STATE RIGHT_MOTOR_ACTIVE_STATE
#define ESC_INACTIVE_STATE RIGHT_MOTOR_INACTIVE_STATE

#define PIN_TEST_MODE 0
#define ESC_ENABLED 0
#define BLE_LED_DEBUG 0
#define UART_TX_PROBE 0
#define SMOKE_GREEN_BLINK_ONLY 1

#define BLE_LINE_BUFFER_SIZE 256U
#define TURN_HEADING_TOLERANCE_DEG 12.0f

#endif
