BananaGithubserfer/velopath/app/velopath3_project/firmware/Core/Inc/main.h

#define LEFT_MOTOR_Pin GPIO_PIN_1
#define LEFT_MOTOR_GPIO_Port GPIOC
#define RIGHT_MOTOR_Pin GPIO_PIN_2
#define RIGHT_MOTOR_GPIO_Port GPIOC
