BananaGithubserfer/velopath/(commit log)

2026-08-10 Add full hardware audit report for schematic and PCB
2026-08-10 Sync repository with current project state
2026-10-26 Add LIS3MDL silkscreen outline and save current project changes
